amperes-robot/peta/etc/report/Figures/zipTrolley.JPG

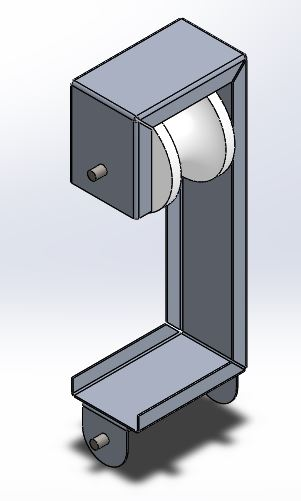
etc/report/Figures/zipTrolley.JPG
