amperes-robot/peta/etc/report/Figures/knockOffTool.JPG

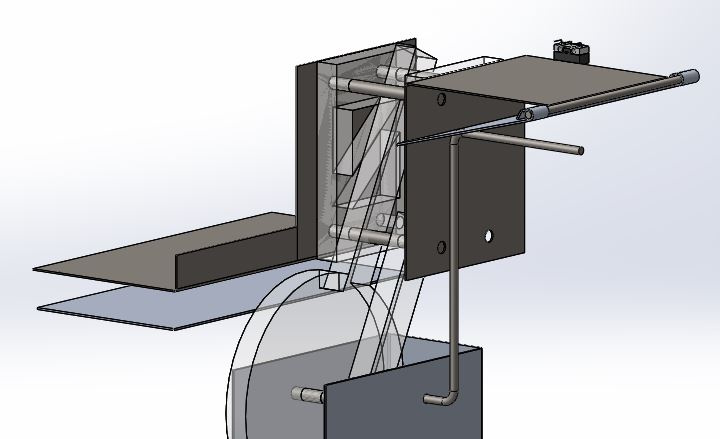
etc/report/Figures/knockOffTool.JPG
