amperes-robot/peta/README.md

ENPH 253 Project Repository

Team PETA
=========

Kevin Zhang

Anne Lim

Scott Fjordbotten

Johnson Liu
