amperes-robot/peta/mech/zipLine/ziplineZipper-Static 1-2.docx

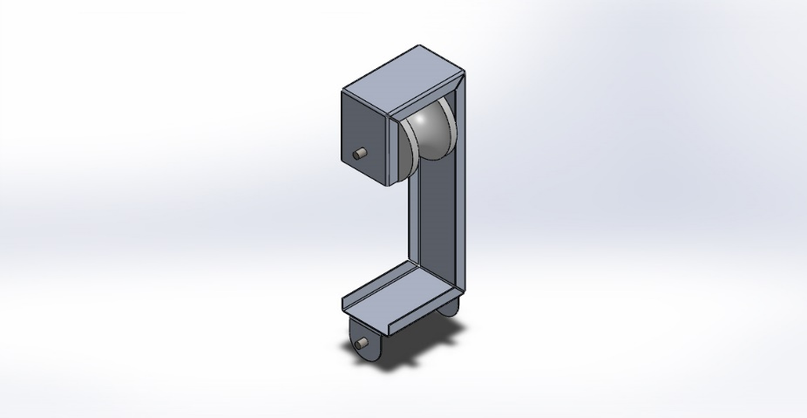
[picture p3: figure]

Simulation of ziplineZipper

Date: June 15, 2015
Designer: Solidworks

Study name: Static 1

Analysis type: Static
Description No Data

# Assumptions

# Model Information

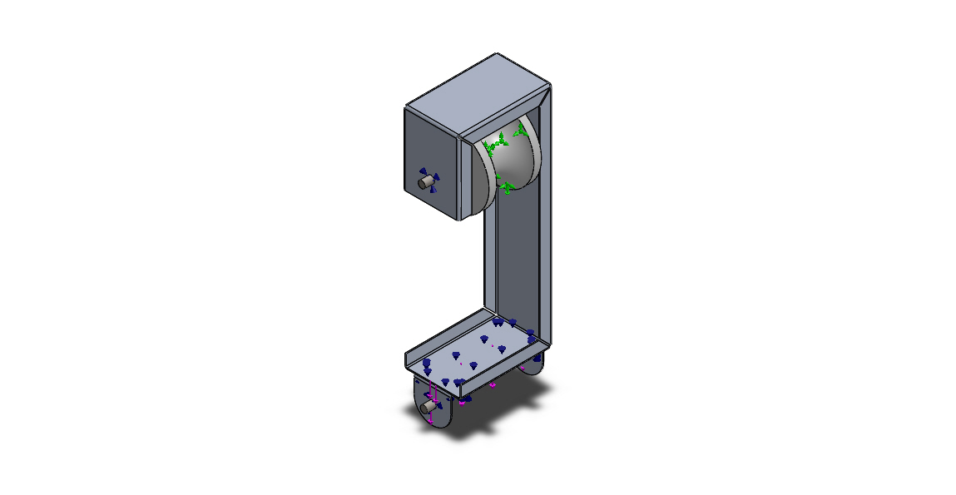
[picture p4: figure]

Model name: ziplineZipper

Current Configuration: Default

Solid Bodies
Document Name and Reference | Treated As | Volumetric Properties | Document Path/Date Modified

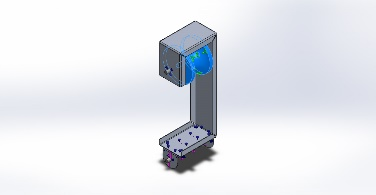
[picture p5: figure]

Cut-Extrude2 | Solid Body | Mass:0.0403131 kg Volume:3.95226e-005 m^3 Density:1020 kg/m^3 Weight:0.395068 N | C:\Users\Scott\Documents\2nd year\ENPH 253\peta\mech\zipLine\ziplineRoller.SLDPRT Jun 13 16:59:09 2015

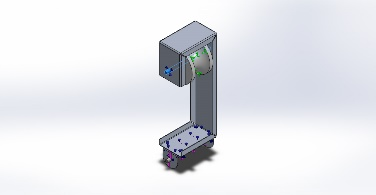
[picture p6: figure]

Boss-Extrude1 | Solid Body | Mass:0.0104596 kg Volume:1.32904e-006 m^3 Density:7870 kg/m^3 Weight:0.102504 N | C:\Users\Scott\Documents\2nd year\ENPH 253\peta\mech\zipLine\ziplineZipperAxel.SLDPRT Jun 13 16:59:10 2015

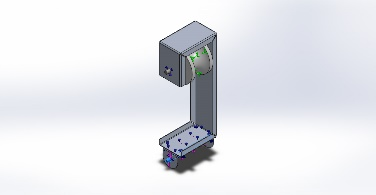
[picture p7: figure]

Boss-Extrude1 | Solid Body | Mass:0.0104596 kg Volume:1.32904e-006 m^3 Density:7870 kg/m^3 Weight:0.102504 N | C:\Users\Scott\Documents\2nd year\ENPH 253\peta\mech\zipLine\ziplineZipperAxel.SLDPRT Jun 13 16:59:10 2015

# Study Properties

Study name | Static 1
Analysis type | Static
Mesh type | Mixed Mesh
Thermal Effect: | On
Thermal option | Include temperature loads
Zero strain temperature | 298 Kelvin
Include fluid pressure effects from SolidWorks Flow Simulation | Off
Solver type | FFEPlus
Inplane Effect: | Off
Soft Spring: | Off
Inertial Relief: | Off
Incompatible bonding options | Automatic
Large displacement | Off
Compute free body forces | On
Friction | Off
Use Adaptive Method: | Off
Result folder | SolidWorks document (C:\Users\Scott\Documents\2nd year\ENPH 253\peta\mech\zipLine)

# Units

Unit system: | SI (MKS)
Length/Displacement | mm
Temperature | Kelvin
Angular velocity | Rad/sec
Pressure/Stress | N/m^2

# Material Properties

Model Reference | Properties | Components

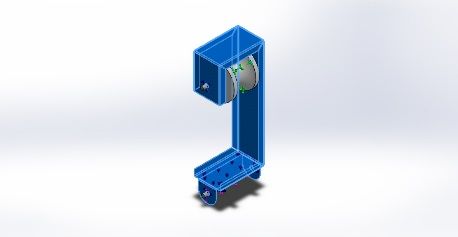
[picture p8: figure]

| Name: 5052-H34 Model type: Linear Elastic Isotropic Default failure criterion: Unknown Yield strength: 2.15e+008 N/m^2 Tensile strength: 2.6e+008 N/m^2 Elastic modulus: 7e+010 N/m^2 Poisson's ratio: 0.33 Mass density: 2680 kg/m^3 Shear modulus: 2.59e+010 N/m^2 Thermal expansion coefficient: 2.4e-005 /Kelvin | SolidBody 1(Cut-Extrude1)(ziplineCBracket-1), SolidBody 1(Cut-Extrude1)(ziplineWinchBracket-1)

Curve Data:N/A

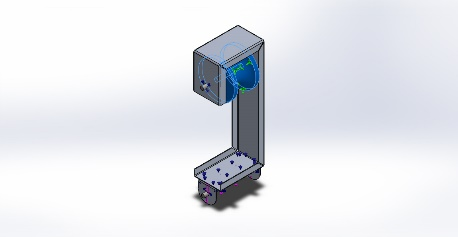
[picture p9: figure]

| Name: ABS Model type: Linear Elastic Isotropic Default failure criterion: Unknown Tensile strength: 3e+007 N/m^2 Elastic modulus: 2e+009 N/m^2 Poisson's ratio: 0.394 Mass density: 1020 kg/m^3 Shear modulus: 3.189e+008 N/m^2 | SolidBody 1(Cut-Extrude2)(ziplineRoller-1)

Curve Data:N/A

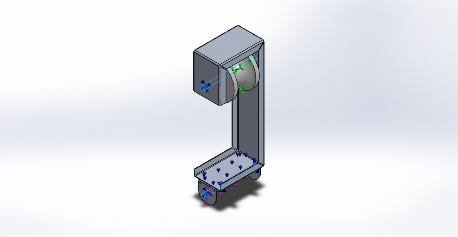
[picture p10: figure]

| Name: AISI 1020 Steel, Cold Rolled Model type: Linear Elastic Isotropic Default failure criterion: Unknown Yield strength: 3.5e+008 N/m^2 Tensile strength: 4.2e+008 N/m^2 Elastic modulus: 2.05e+011 N/m^2 Poisson's ratio: 0.29 Mass density: 7870 kg/m^3 Shear modulus: 8e+010 N/m^2 Thermal expansion coefficient: 1.2e-005 /Kelvin | SolidBody 1(Boss-Extrude1)(ziplineZipperAxel-1), SolidBody 1(Boss-Extrude1)(ziplineZipperAxel-2)

Curve Data:N/A

# Loads and Fixtures

Fixture name | Fixture Image | Fixture Details

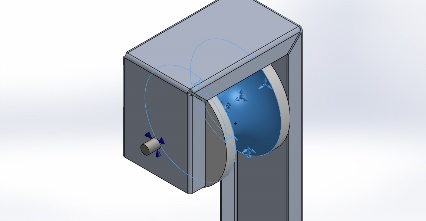
[picture p11: figure]

Fixed-1 | | Entities: 1 face(s) Type: Fixed Geometry

Resultant Forces

Components | X | Y | Z | Resultant
Reaction force(N) | 6.08177e-006 | 44.145 | -7.96234e-006 | 44.145
Reaction Moment(N.m) | 0 | 0 | 0 | 1e-033

Load name | Load Image | Load Details

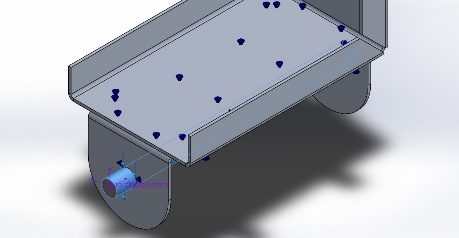
[picture p12: figure]

BearingLoads-1 | | Entities: 1 face(s) Coordinate System: Coordinate System1 Force Values: 0 -44.145 0 N

# Connector Definitions

Connector name | Connector Details | Connector Image

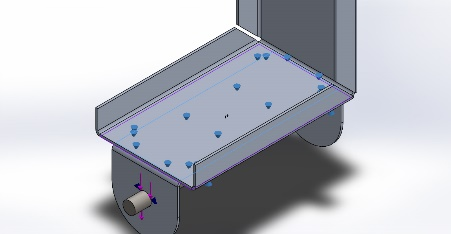
[picture p13: figure]

Rigid Connector-1 | Entities: 2 face(s) Type: Rigid | Rigid Connector-1

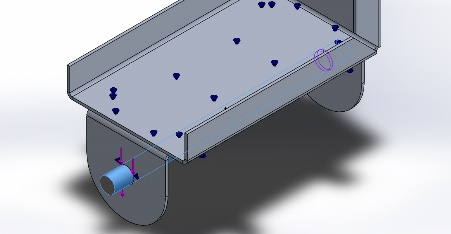
[picture p14: figure]

Rigid Connector-2 | Entities: 2 face(s) Type: Rigid | Rigid Connector-2

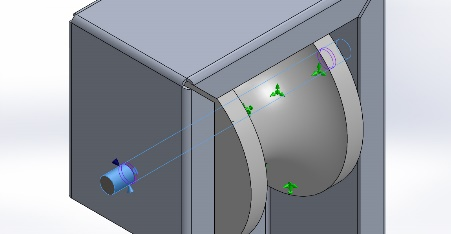
[picture p15: figure]

Rigid Connector-3 | Entities: 3 face(s) Type: Rigid | Rigid Connector-3

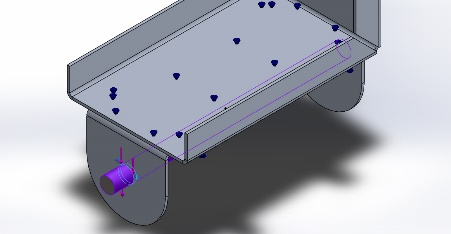
[picture p16: figure]

Rigid Connector-4 | Entities: 2 face(s) Type: Rigid | Rigid Connector-4

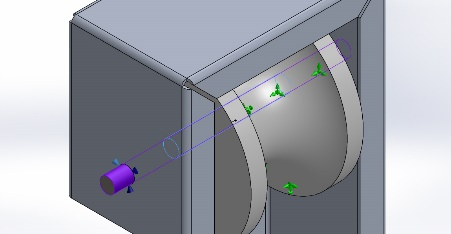
[picture p17: figure]

Rigid Connector-5 | Entities: 2 face(s) Type: Rigid | Rigid Connector-5

# Contact Information

Contact | Contact Image | Contact Properties

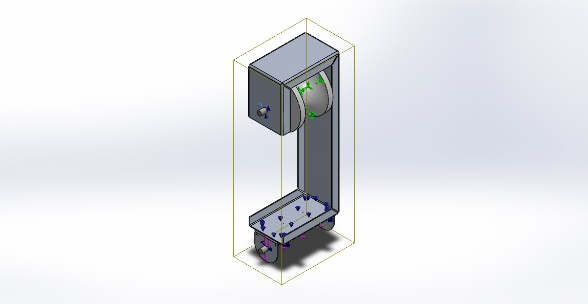
[picture p18: figure]

Global Contact | | Type: Bonded Components: 1 component(s) Options: Compatible mesh

# Mesh Information

Mesh type | Mixed Mesh
Mesher Used: | Standard mesh
Automatic Transition: | Off
Include Mesh Auto Loops: | Off
Jacobian points | 4 Points
Jacobian check for shell | Off
Element Size | 3.69528 mm
Tolerance | 0.184764 mm
Mesh Quality | High
Remesh failed parts with incompatible mesh | Off

## Mesh Information - Details

Total Nodes | 18106
Total Elements | 9996
Time to complete mesh(hh;mm;ss): | 00:00:08
Computer name: | HP-PC

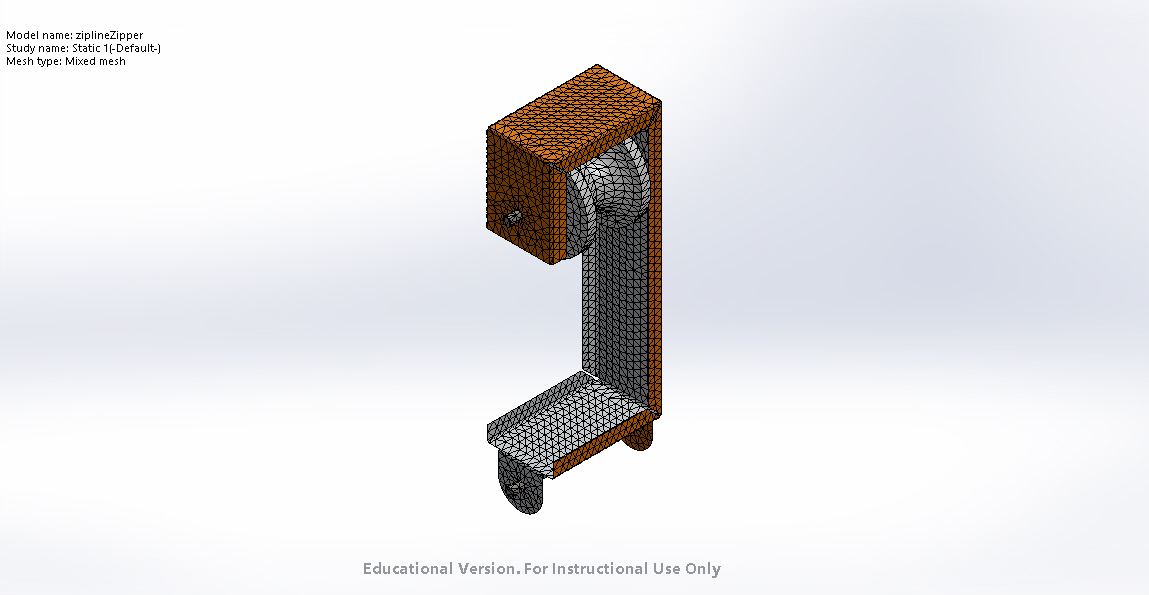
[picture p19: figure]

# Sensor Details

No Data

# Resultant Forces

## Reaction Forces

Selection set | Units | Sum X | Sum Y | Sum Z | Resultant
Entire Model | N | 6.08177e-006 | 44.145 | -7.96234e-006 | 44.145

## Reaction Moments

Selection set | Units | Sum X | Sum Y | Sum Z | Resultant
Entire Model | N.m | 0 | 0 | 0 | 1e-033

# Beams

No Data

# Study Results

Name | Type | Min | Max
Stress1 | VON: von Mises Stress | 0.00107596 N/m^2 Node: 9768 | 1.32393e+007 N/m^2 Node: 11499

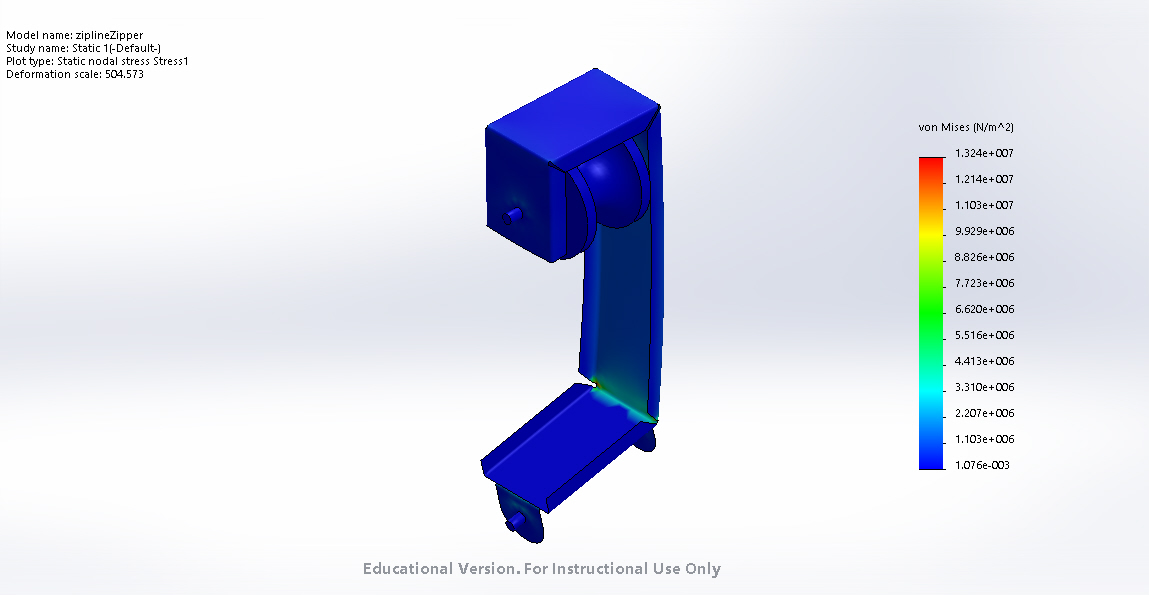
[picture p20: figure]

ziplineZipper-Static 1-Stress-Stress1

Name | Type | Min | Max
Displacement1 | URES: Resultant Displacement | 0 mm Node: 1 | 0.035754 mm Node: 10597

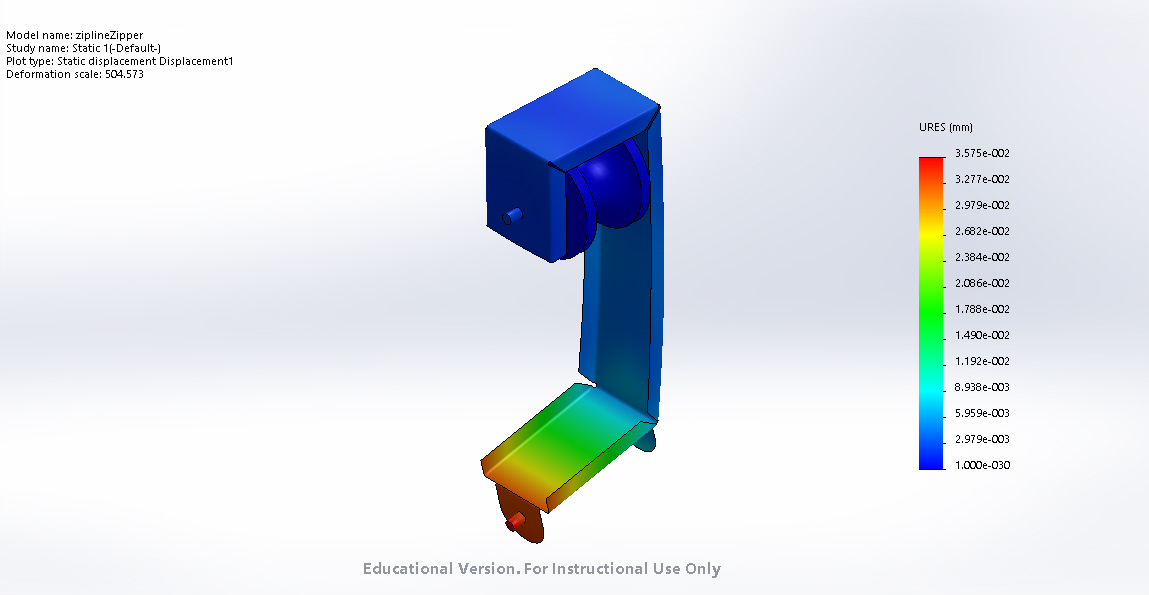
[picture p21: figure]

ziplineZipper-Static 1-Displacement-Displacement1

Name | Type | Min | Max
Strain1 | ESTRN: Equivalent Strain | 3.14989e-014 Element: 6184 | 0.000224662 Element: 1951

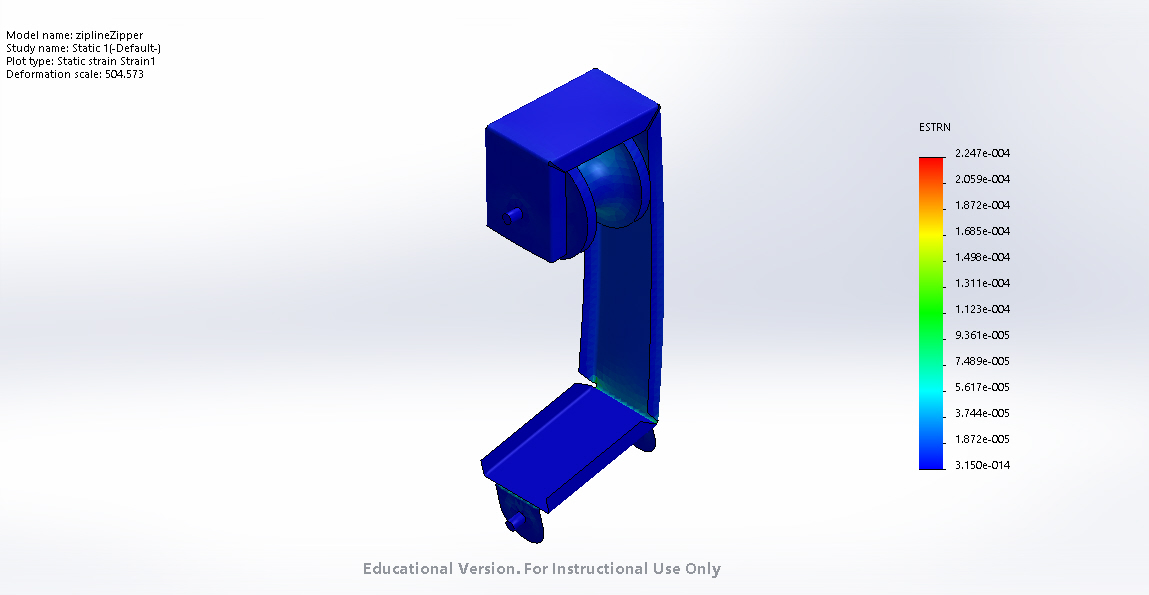
[picture p22: figure]

ziplineZipper-Static 1-Strain-Strain1

Name | Type
Displacement1{1} | Deformed Shape

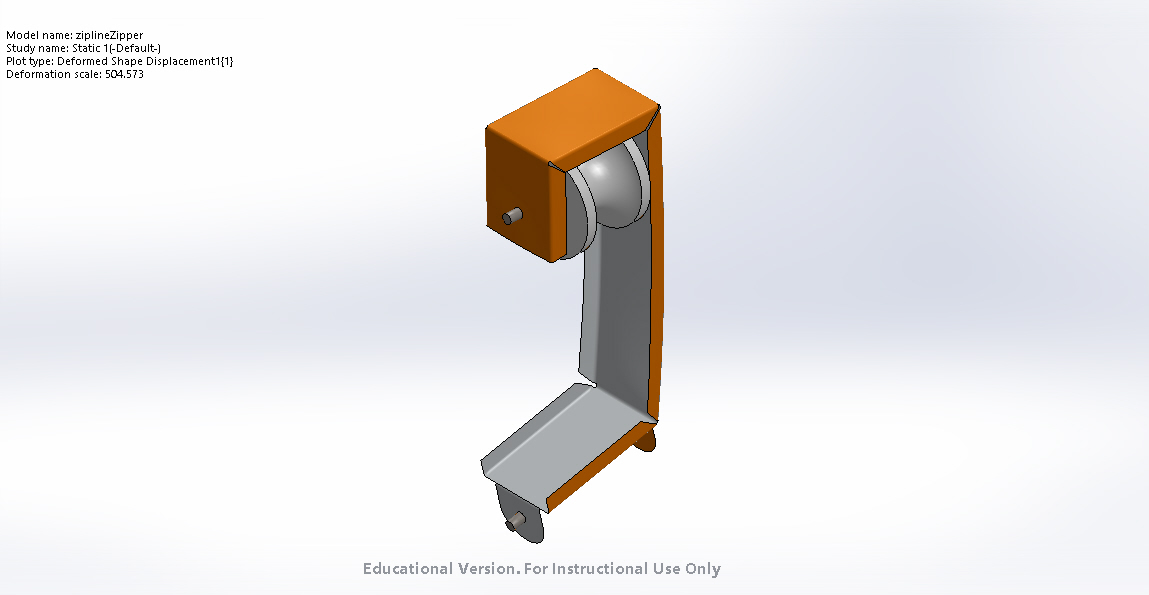
[picture p23: figure]

ziplineZipper-Static 1-Displacement-Displacement1{1}

# Conclusion

Analyzed with SolidWorks Simulation Simulation of ziplineZipper 14

Analyzed with SolidWorks Simulation Simulation of ziplineZipper 1
