amperes-robot/peta/elec/HBridge.png

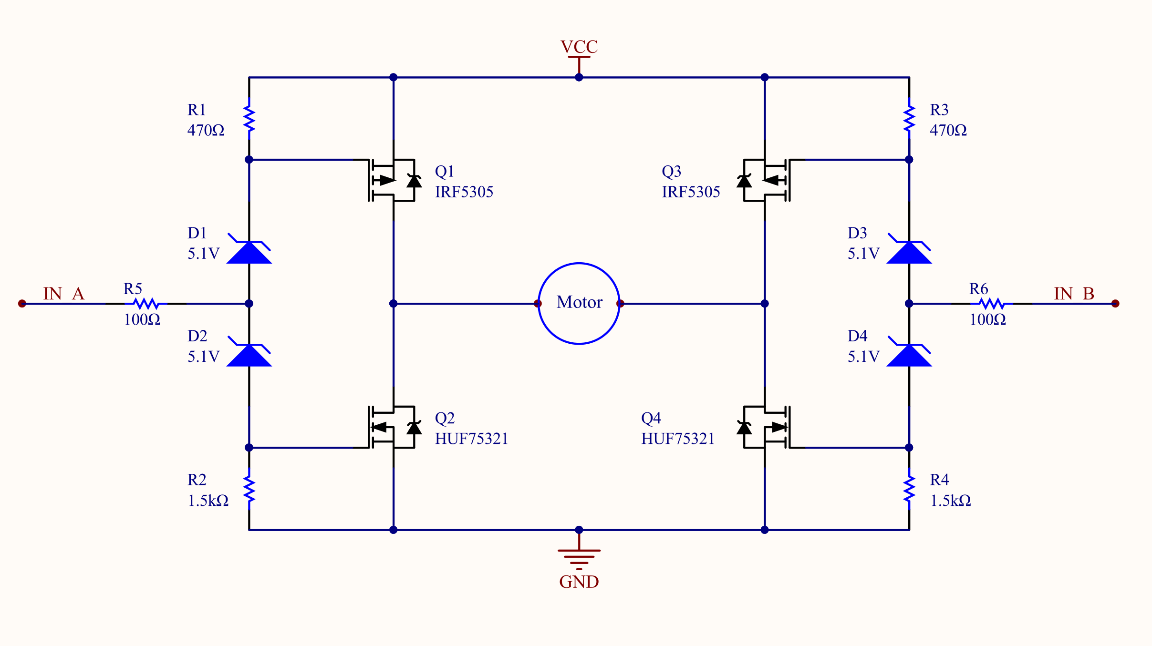
elec/HBridge.png
