amperes-robot/peta/elec/IR_forWebsite.JPG

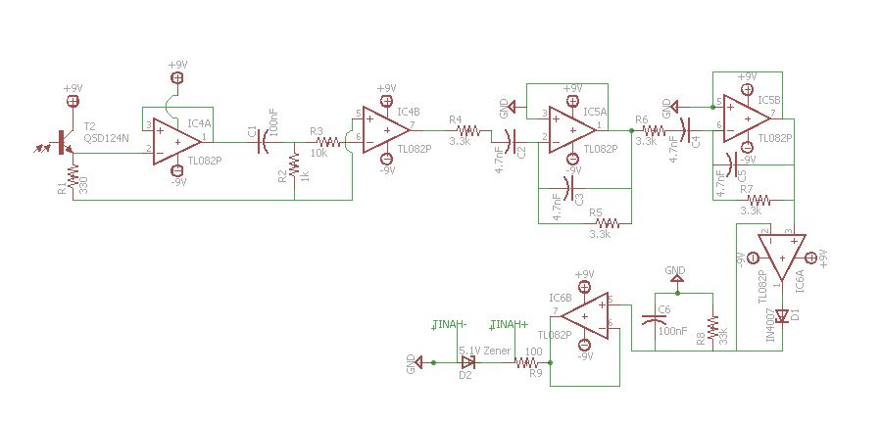
elec/IR_forWebsite.JPG
