amperes-robot/peta/etc/report/Figures/amp.jpg

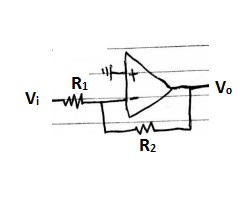
etc/report/Figures/amp.jpg
