amperes-robot/peta/etc/report/Figures/armArms.JPG

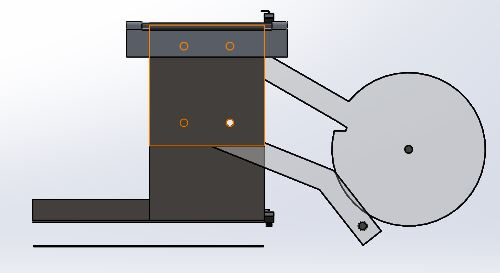
etc/report/Figures/armArms.JPG
