amperes-robot/peta/etc/report/Figures/armBodyFront.JPG

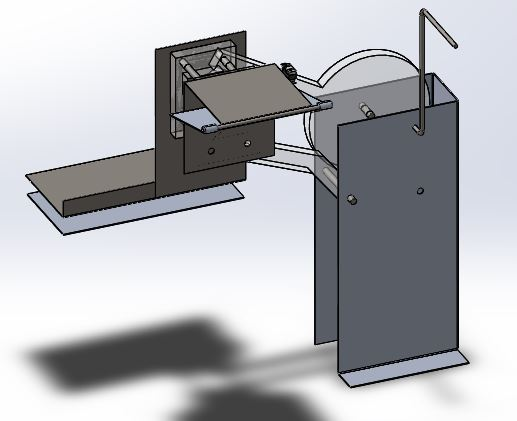
etc/report/Figures/armBodyFront.JPG
