amperes-robot/peta/etc/report/Figures/armBodyRear.JPG

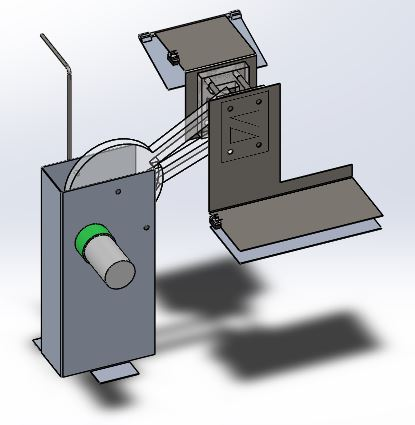
etc/report/Figures/armBodyRear.JPG
