amperes-robot/peta/etc/report/Figures/armEnd.JPG

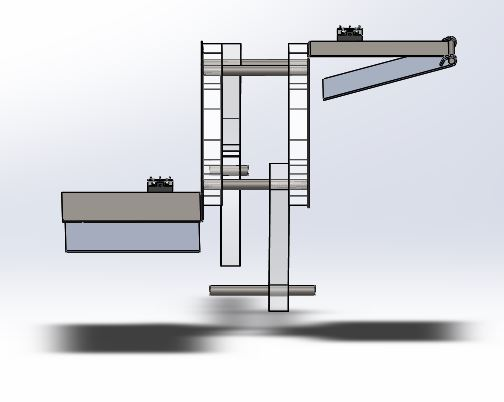
etc/report/Figures/armEnd.JPG
