amperes-robot/peta/etc/report/Figures/bandPass.jpg

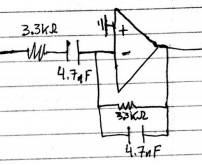
etc/report/Figures/bandPass.jpg
