amperes-robot/peta/etc/report/Figures/Board Storage Space.JPG

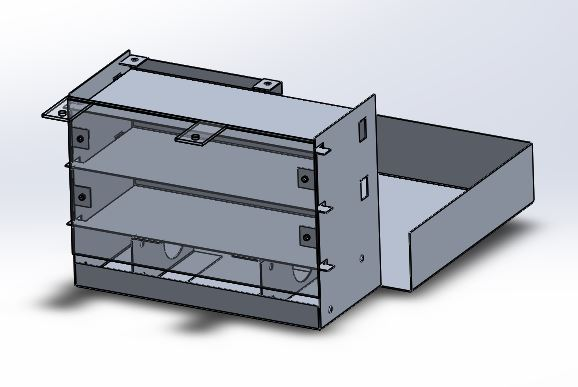
etc/report/Figures/Board Storage Space.JPG
