amperes-robot/peta/etc/report/Figures/chassis back features.jpg

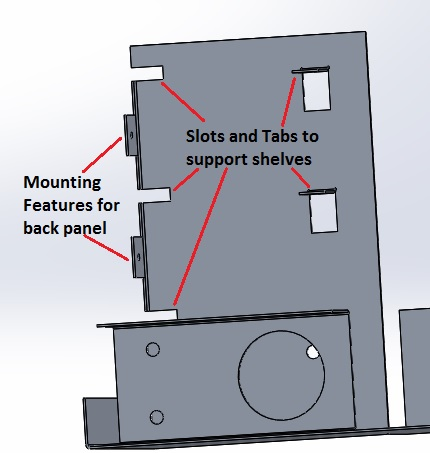
etc/report/Figures/chassis back features.jpg
