amperes-robot/peta/etc/report/Figures/Chassis Body.JPG

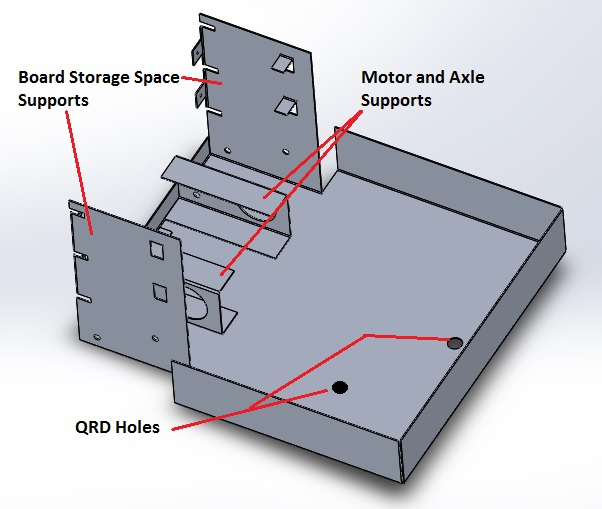
etc/report/Figures/Chassis Body.JPG
