amperes-robot/peta/etc/report/Figures/chassisAssy.JPG

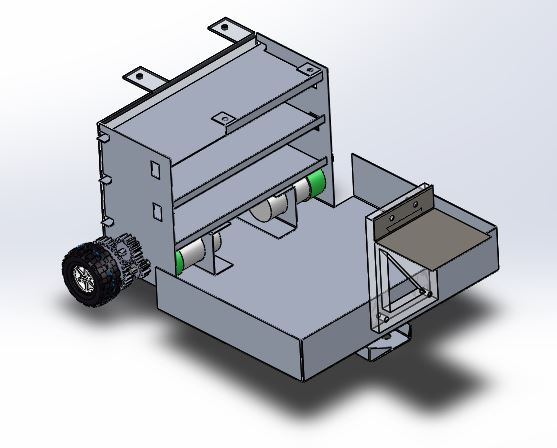
etc/report/Figures/chassisAssy.JPG
