amperes-robot/peta/etc/report/Figures/course.JPG

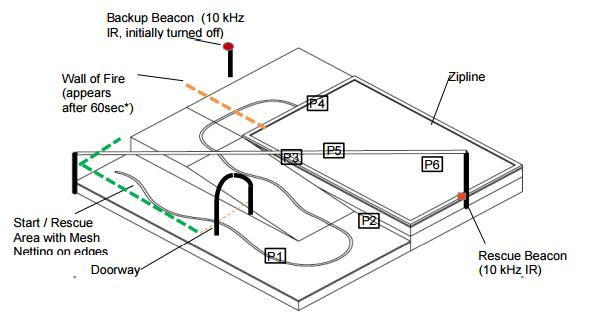
etc/report/Figures/course.JPG
