amperes-robot/peta/etc/report/Figures/dcBlock.jpg

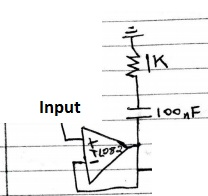
etc/report/Figures/dcBlock.jpg
