amperes-robot/peta/etc/report/Figures/driveGears.JPG

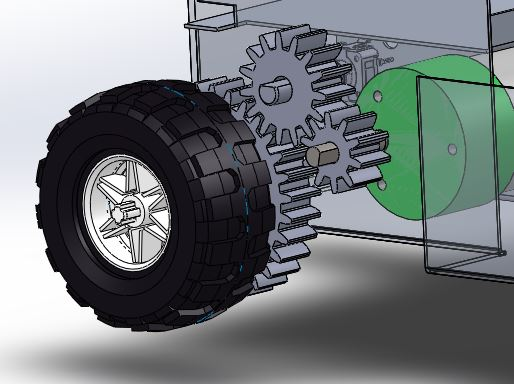
etc/report/Figures/driveGears.JPG
