amperes-robot/peta/etc/report/Figures/frontArm.JPG

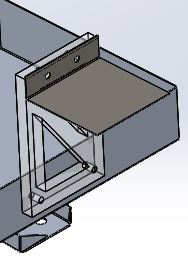
etc/report/Figures/frontArm.JPG
