amperes-robot/peta/etc/report/Figures/frontSled.JPG

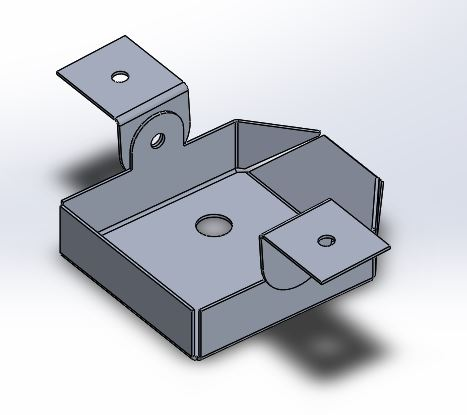
etc/report/Figures/frontSled.JPG
