amperes-robot/peta/etc/report/Figures/peakDetector.jpg

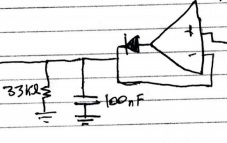
etc/report/Figures/peakDetector.jpg
