amperes-robot/peta/etc/report/Figures/robotAssy.JPG

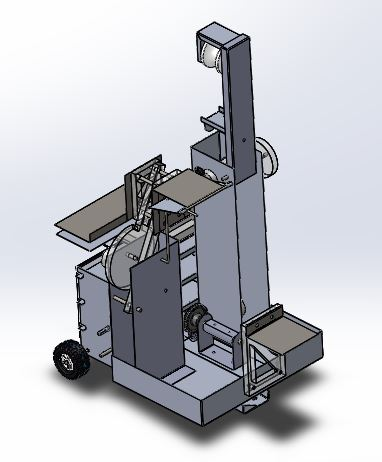
etc/report/Figures/robotAssy.JPG
