amperes-robot/peta/etc/report/Figures/Schematic_B_QRD.PNG

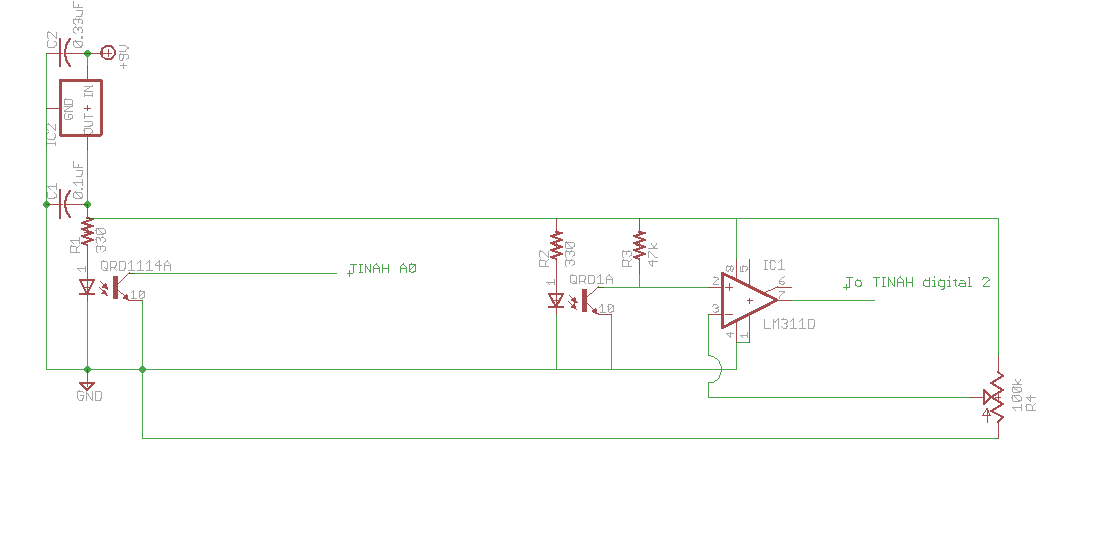
etc/report/Figures/Schematic_B_QRD.PNG
