amperes-robot/peta/etc/report/Figures/Schematic_C-IR.PNG

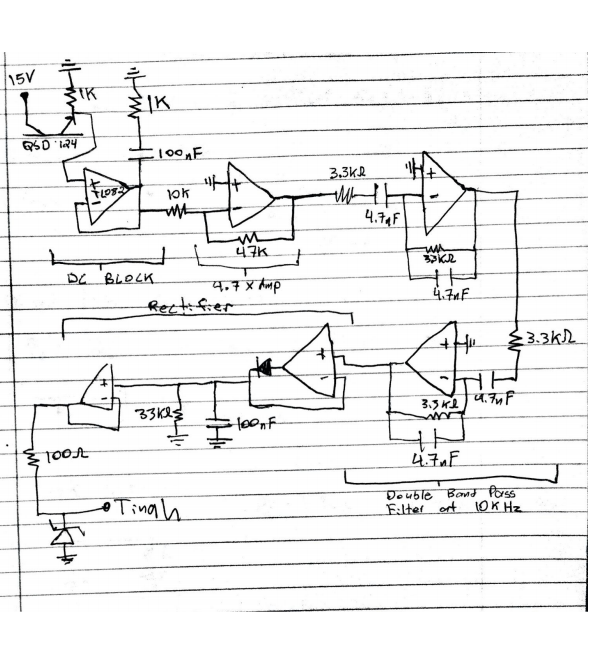
etc/report/Figures/Schematic_C-IR.PNG
