amperes-robot/peta/etc/report/Figures/Schematic_D-winch.PNG

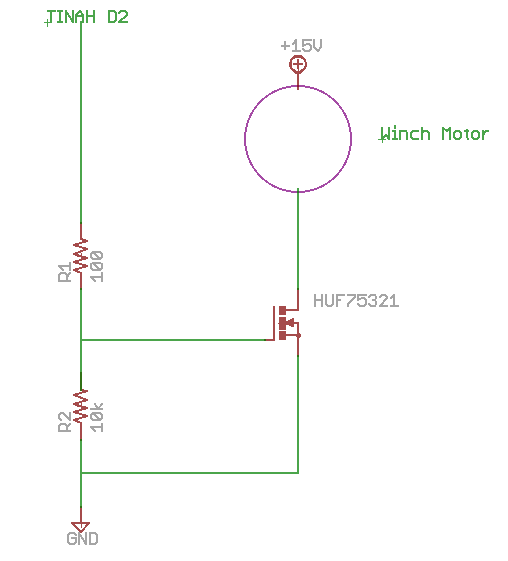
etc/report/Figures/Schematic_D-winch.PNG
