amperes-robot/peta/etc/report/Figures/Schematic_E-petpickup.PNG

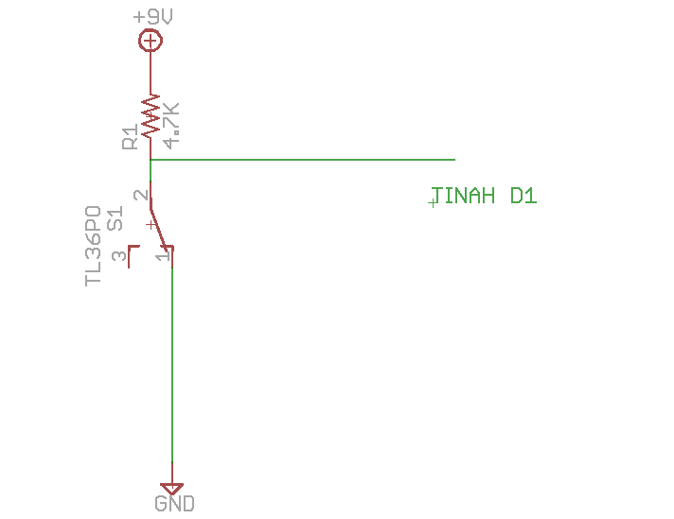
etc/report/Figures/Schematic_E-petpickup.PNG
