amperes-robot/peta/etc/report/Figures/SchematicA_HBridge.PNG

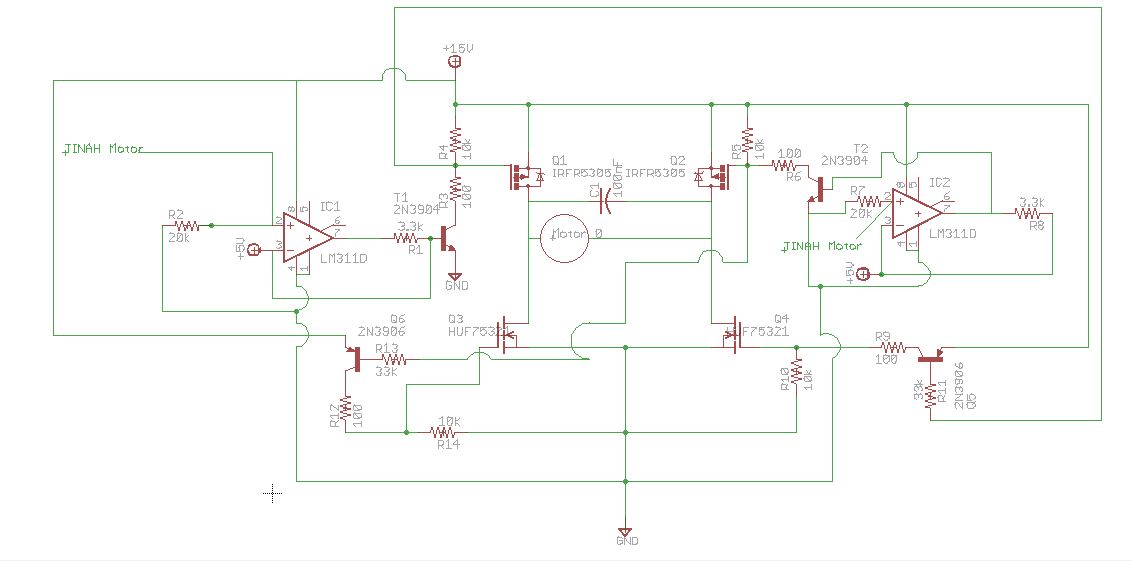
etc/report/Figures/SchematicA_HBridge.PNG
