amperes-robot/peta/etc/report/Figures/Software Modes.JPG

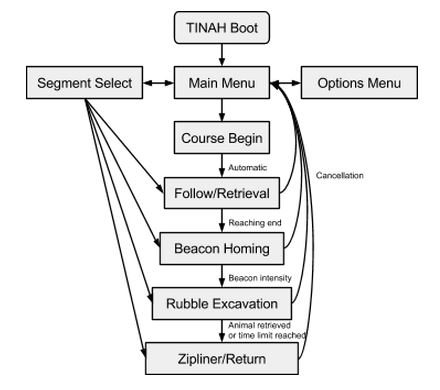
etc/report/Figures/Software Modes.JPG
