amperes-robot/peta/etc/report/Figures/Software State Diag.png

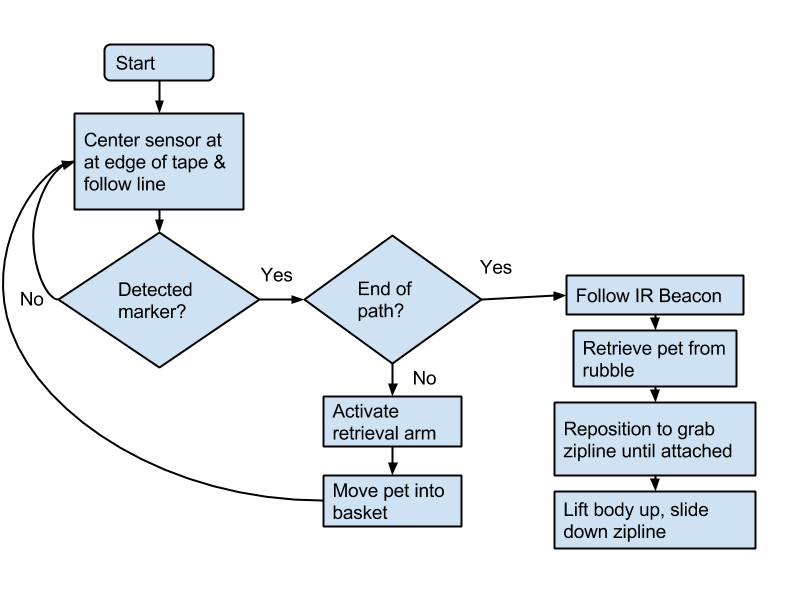
etc/report/Figures/Software State Diag.png
