amperes-robot/peta/etc/report/Figures/winch.JPG

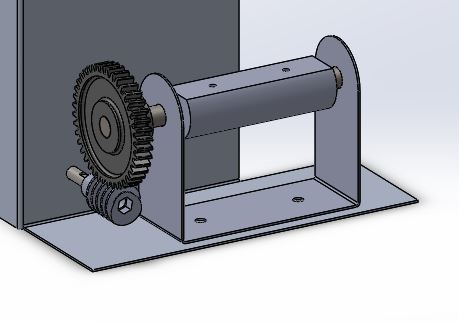
etc/report/Figures/winch.JPG
