amperes-robot/peta/etc/report/Figures/wireRouting.jpg

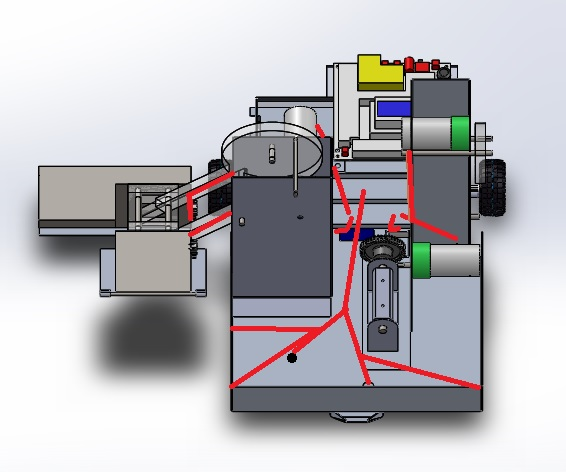
etc/report/Figures/wireRouting.jpg
