amperes-robot/peta/etc/report/Figures/ziplineModule.JPG

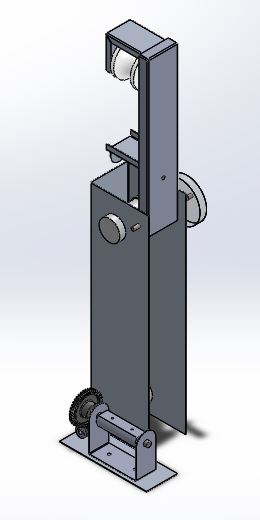
etc/report/Figures/ziplineModule.JPG
