amperes-robot/peta/etc/report/Figures/ziplineZipperFEA.JPG

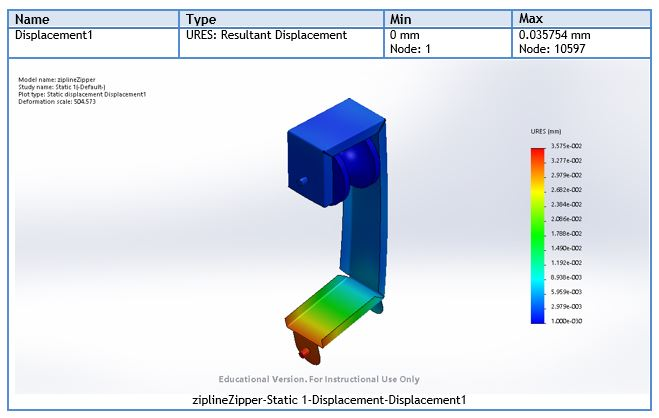
etc/report/Figures/ziplineZipperFEA.JPG
