amperes-robot/peta/etc/Solidworks Render Best Quality.JPG

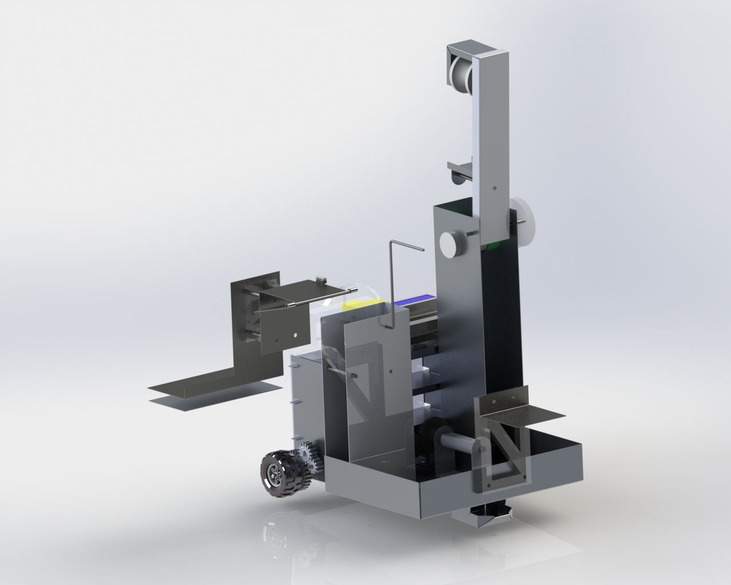
etc/Solidworks Render Best Quality.JPG
