amperes-robot/peta/mech/boxArm/boxArm.SLDASM

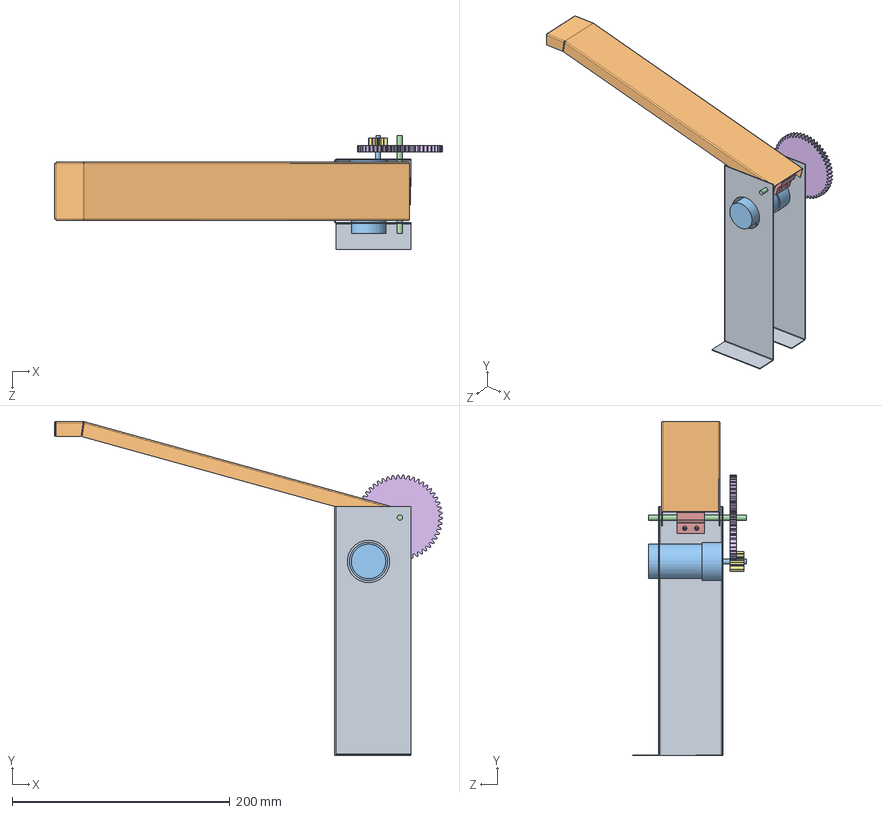
[picture p76: CAD file, 2015-07-29]
mech/boxArm/boxArm.SLDASM
356.2 x 307.0 x 104.9 mm
armSupport
boxArm
Motor Barber Coleman geared
ziplineAxel
printedShaftFitting
50toothGearWithOffset
MotorGearSolidworks
