amperes-robot/peta/mech/chassis/chassisAssy.SLDASM

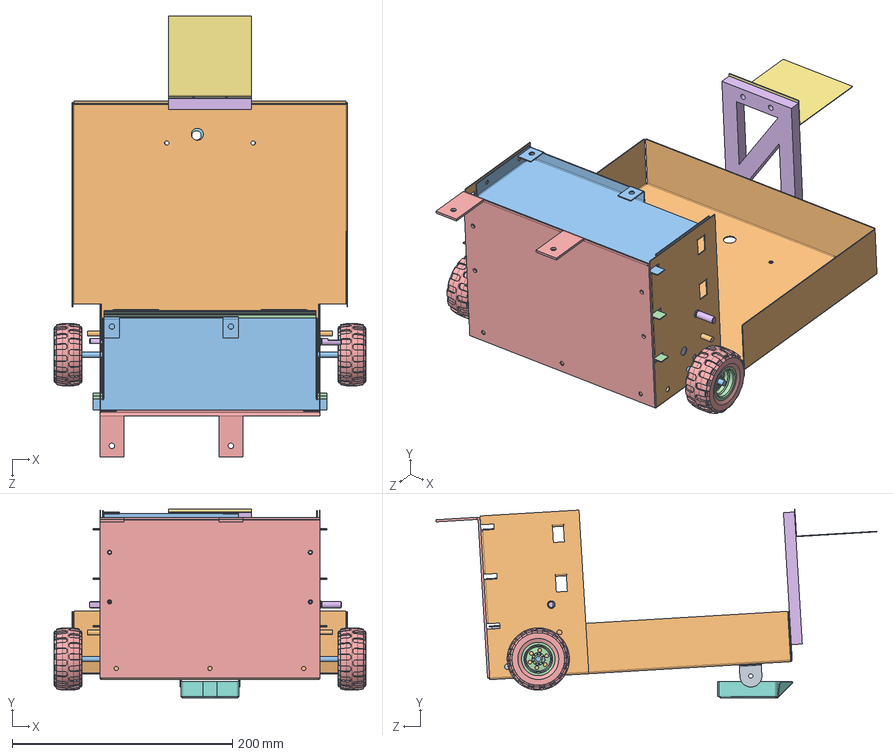
[picture p77: CAD file, 2015-07-23]
mech/chassis/chassisAssy.SLDASM
283.1 x 171.2 x 400.0 mm
sledBracket x 2
ChassisPlate
boardTrayTopTINAH
boardTray x 2
frontarm
LBracket
SledV2
Base x 2
Motor Barber Coleman geared x 2
steelAxle x 2
hub x 2
tire x 2
pec11r-4x25f-sxxxx x 2
axleSupport x 2
