amperes-robot/peta/mech/ext/meccano gear/worm and gear assembly.SLDASM

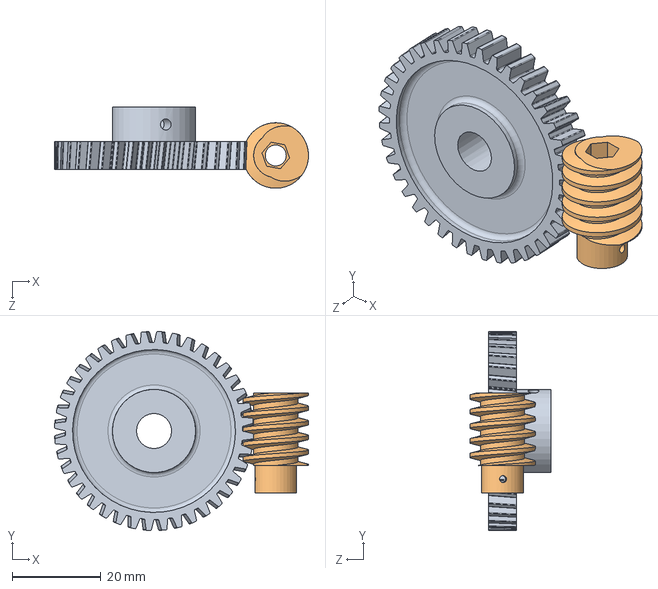
[picture p78: CAD file, 2015-07-09]
mech/ext/meccano gear/worm and gear assembly.SLDASM
57.4 x 45.0 x 18.4 mm
helical gear 40 teeth
worm for helical gear
