amperes-robot/peta/mech/ext/QRD/QRD1114.SLDASM

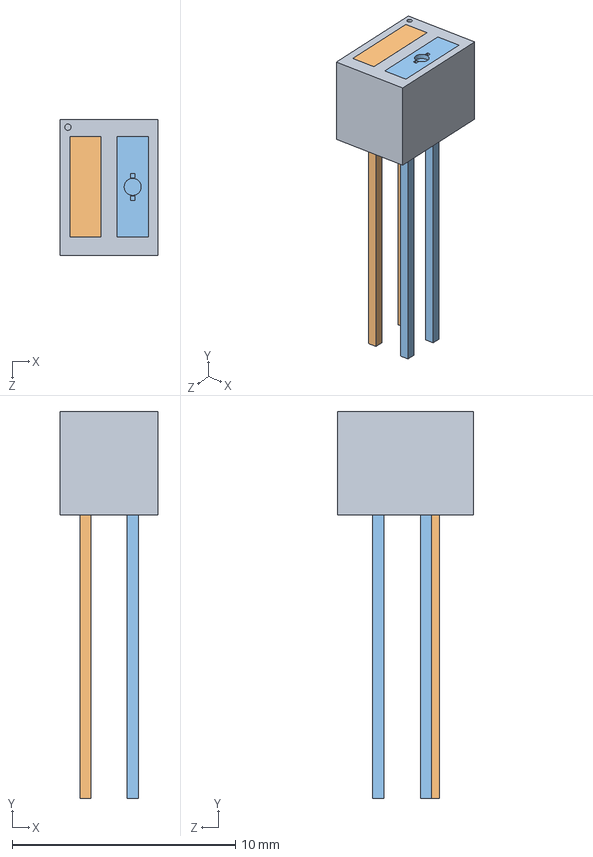
[picture p79: CAD file, 2015-07-23]
mech/ext/QRD/QRD1114.SLDASM
4.39 x 17.4 x 6.10 mm
QRD Chasis
receptor qrd
emisorqrd
