amperes-robot/peta/mech/ext/wheel.SLDASM

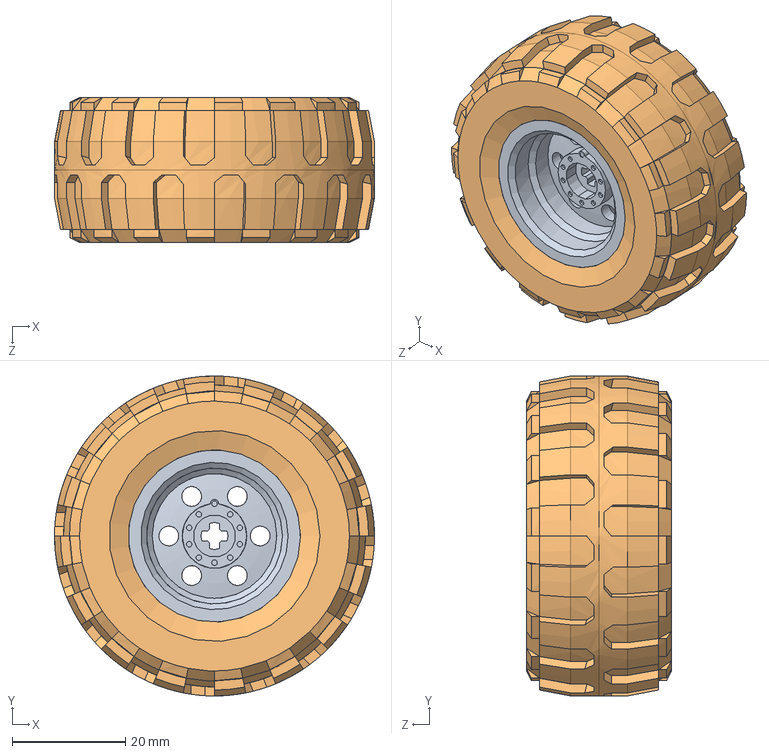
[picture p80: CAD file, 2015-07-23]
mech/ext/wheel.SLDASM
56.5 x 56.5 x 25.6 mm
hub
tire
