amperes-robot/peta/mech/GearBox/GearBoxAssy.SLDASM

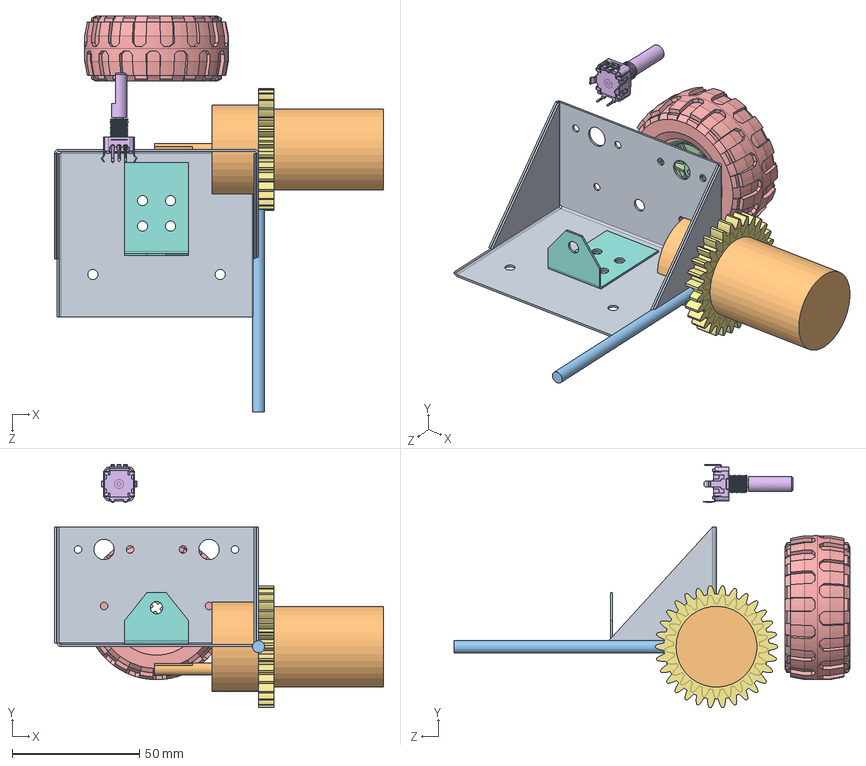
[picture p81: CAD file, 2015-07-23]
mech/GearBox/GearBoxAssy.SLDASM
129.1 x 95.5 x 155.4 mm
Base
Motor Barber Coleman geared
steelAxle
hub
tire
pec11r-4x25f-sxxxx
spur gear_am x 3
axleSupport
