amperes-robot/peta/mech/petArm/armAssy.SLDASM

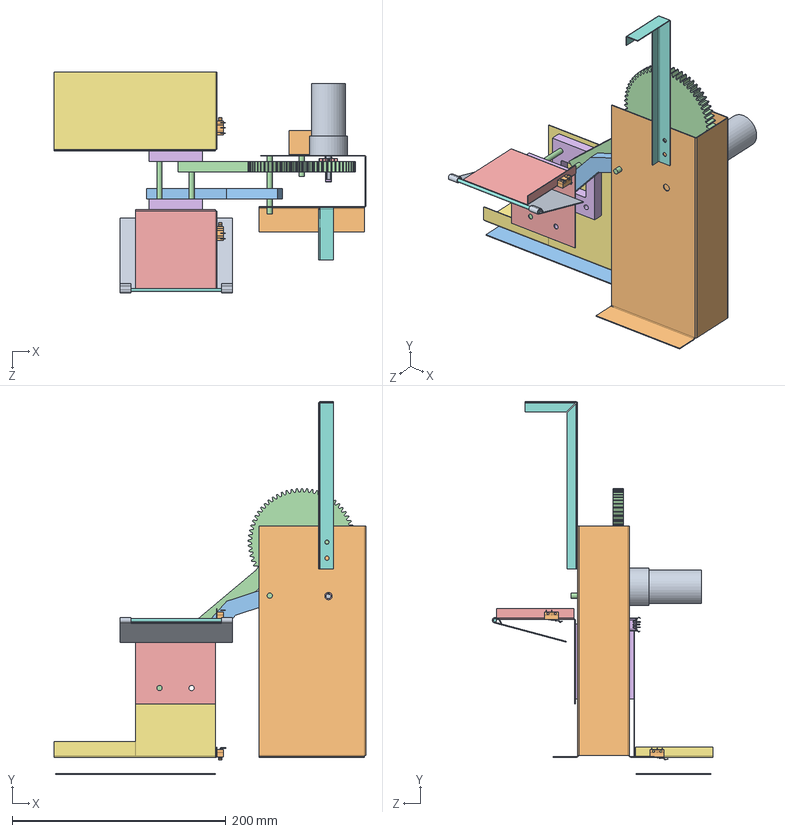
[picture p82: CAD file, 2015-07-23]
mech/petArm/armAssy.SLDASM
291.8 x 348.9 x 206.3 mm
Motor Barber Coleman geared
armBase
ArmLongSection
armRod x 5
LBracket
armBracket x 2
LBracketBack
pickUpArmAxel
pickUpArmSensorPlate
Microswitch_1A_125vAC(seul) x 2
boxPetSensePlate
GearArmV2
MotorGearSolidworks
pec11r-4x25f-sxxxx
spur gear_am
knockOffToolSheetMetal
