amperes-robot/peta/mech/QRDeye.SLDASM

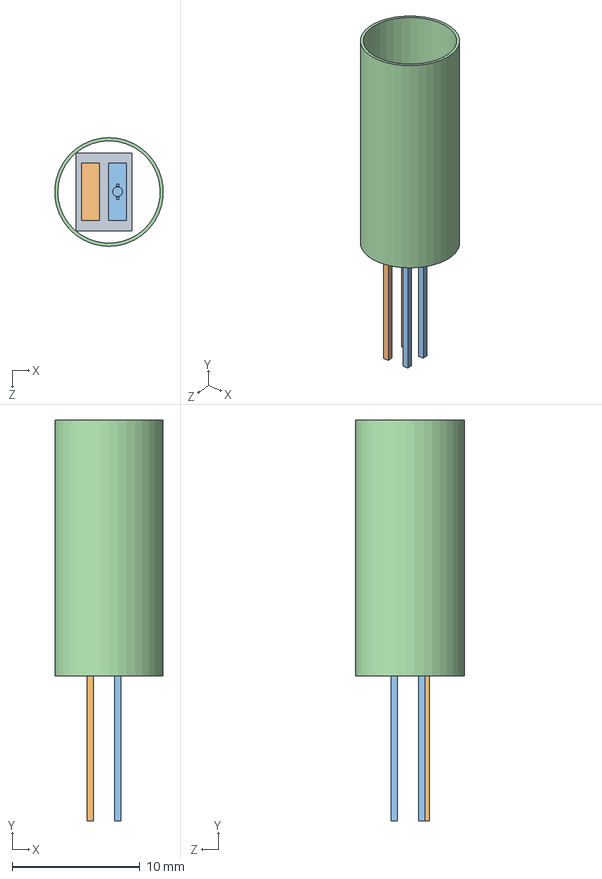
[picture p83: CAD file, 2015-07-23]
mech/QRDeye.SLDASM
8.47 x 31.4 x 8.50 mm
QRD Chasis
receptor qrd
emisorqrd
QRDsleeve
