amperes-robot/peta/mech/RobotAssy.SLDASM

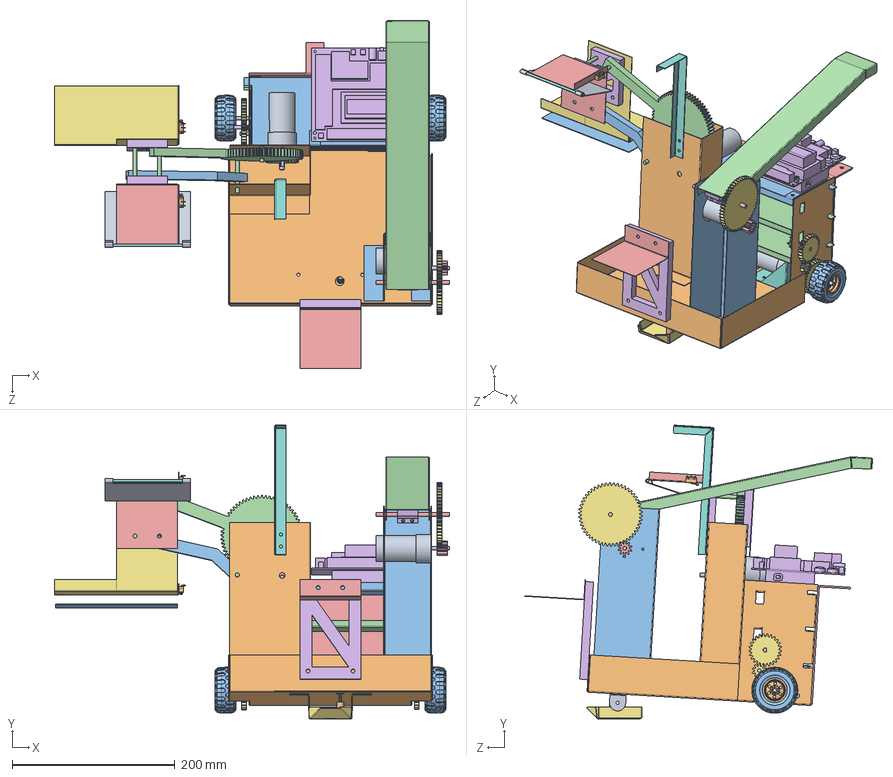
[picture p84: CAD file, 2015-07-23]
mech/RobotAssy.SLDASM
484.8 x 360.7 x 427.2 mm
Motor Barber Coleman geared x 4
armBase
ArmLongSection
armRod x 5
LBracket x 2
armBracket x 2
LBracketBack
pickUpArmAxel
pickUpArmSensorPlate
Microswitch_1A_125vAC(seul) x 2
boxPetSensePlate
GearArmV2
MotorGearSolidworks x 2
pec11r-4x25f-sxxxx x 3
spur gear_am x 7
knockOffToolSheetMetal
sledBracket x 2
ChassisPlate
boardTrayTopTINAH
boardTray x 2
frontarm
SledV2
Base x 2
steelAxle x 2
hub x 2
tire x 2
axleSupport x 2
LiPoBattery
Tinah Board representation
QRD Chasis
receptor qrd
emisorqrd
QRDsleeve
armSupport
boxArm
ziplineAxel
printedShaftFitting
50toothGearWithOffset
