amperes-robot/peta/mech/zipLine/winchAssy.SLDASM

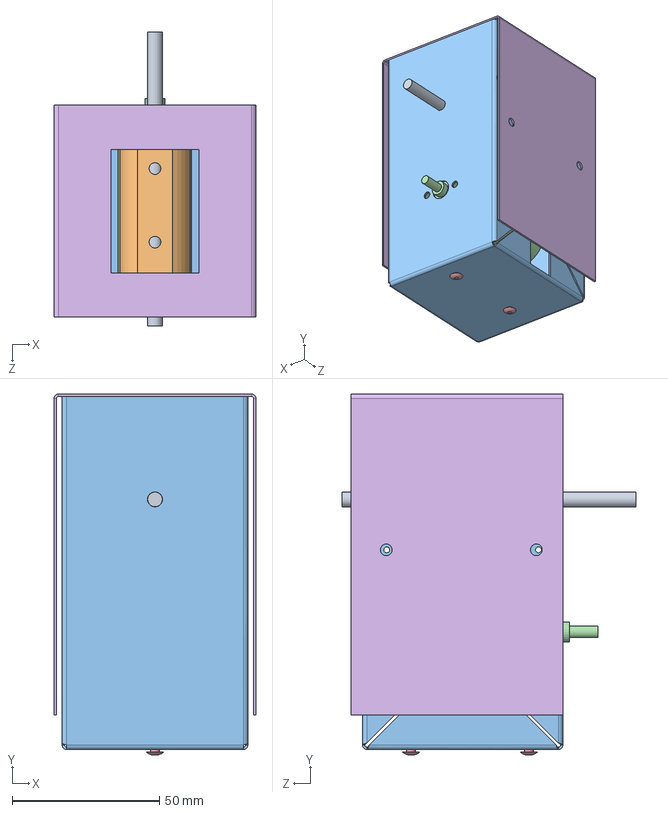
[picture p85: CAD file, 2015-07-29]
mech/zipLine/winchAssy.SLDASM
68.6 x 122.7 x 100.0 mm
winchAxel
winchReel
winchBody
winchGearedMotor
pop rivet x 2
winchCover
