amperes-robot/peta/mech/ext/meccano gear/ASM Meccano Gear 65mm.SLDASM

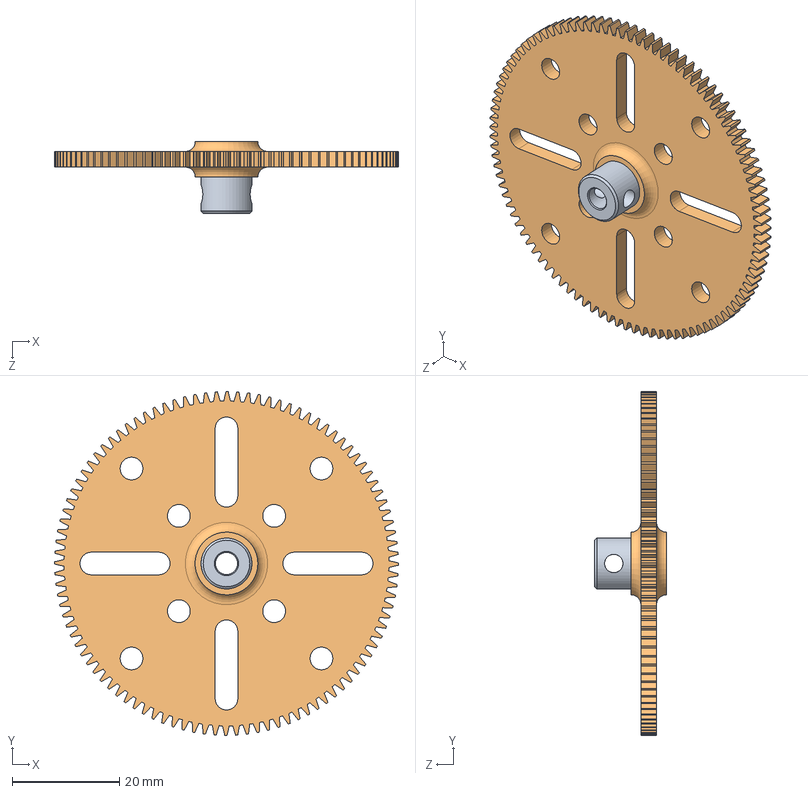
[picture p86: CAD file, 2015-06-16]
mech/ext/meccano gear/ASM Meccano Gear 65mm.SLDASM
64.3 x 64.3 x 13.4 mm
Meccano Gear Axle
Meccano Gear 65mm
