amperes-robot/peta/mech/zipLine/ziplineZipper.SLDASM

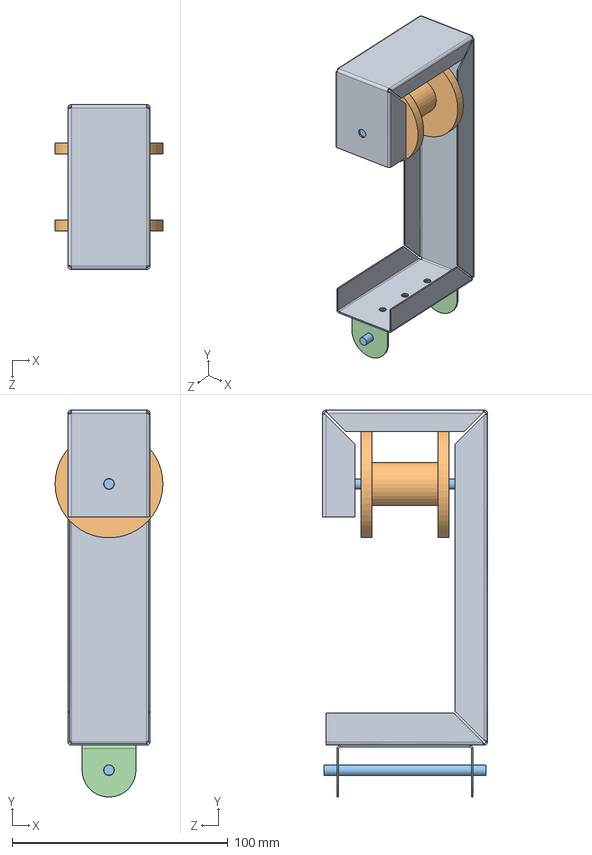
[picture p87: CAD file, 2015-07-29]
mech/zipLine/ziplineZipper.SLDASM
50.0 x 179.5 x 76.5 mm
ziplineCBracket
ziplineRoller
ziplineZipperAxel x 2
ziplineWinchBracket
