amperes-robot/peta/mech/zipLine/ziplineAssy.SLDASM

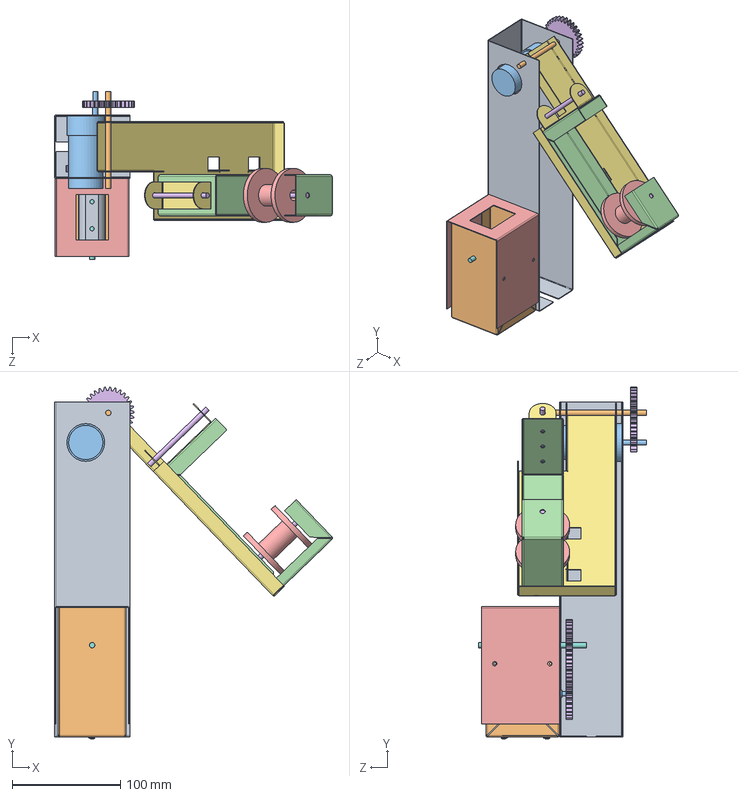
[picture p88: CAD file, 2015-07-29]
mech/zipLine/ziplineAssy.SLDASM
257.7 x 325.8 x 155.7 mm
ZiplineSupport
ziplineAxel
Motor Barber Coleman geared
ziplineCBracket
ziplineRoller
ziplineZipperAxel x 2
ziplineWinchBracket
winchAxel
winchReel
winchBody
winchGearedMotor
pop rivet x 2
winchCover
spur gear_am x 4
ziplineArmGuideLShape
