amperes-robot/peta/mech/chassis/sledAssy.SLDASM

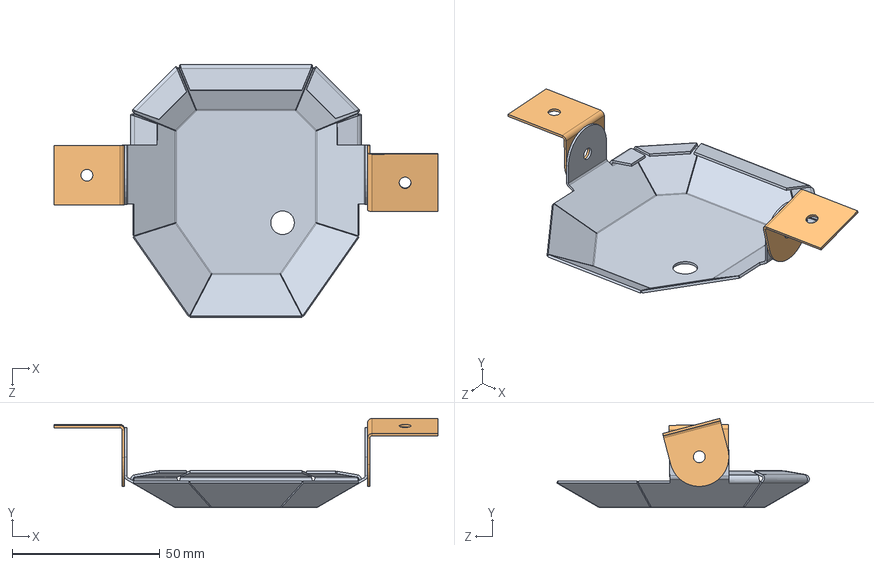
[picture p89: CAD file, 2015-06-16]
mech/chassis/sledAssy.SLDASM
129.9 x 30.2 x 85.5 mm
Sled
sledBracket x 2
