amperes-robot/peta/mech/DXFs/50toothGearWithOffset.DXF

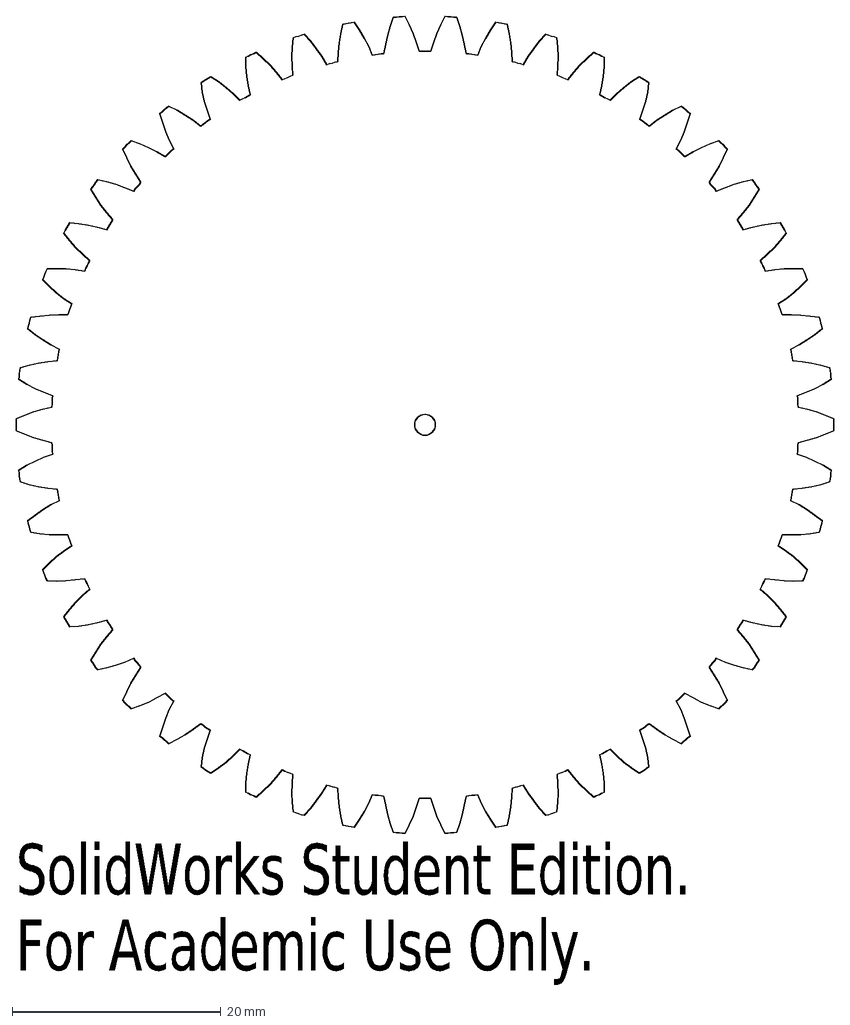
[picture p90: CAD file, 2015-07-23]
mech/DXFs/50toothGearWithOffset.DXF
SolidWorks Student Edition.
For Academic Use Only.
