amperes-robot/peta/mech/DXFs/arm/Flat pattern - knockOffToolSheetMetal.DXF

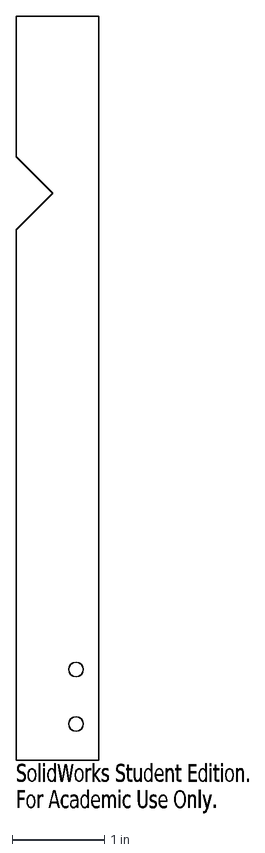
[picture p91: CAD file, 2015-07-11]
mech/DXFs/arm/Flat pattern - knockOffToolSheetMetal.DXF
SolidWorks Student Edition.
For Academic Use Only.
