amperes-robot/peta/mech/DXFs/boxArm/Flat pattern - boxArm.DXF

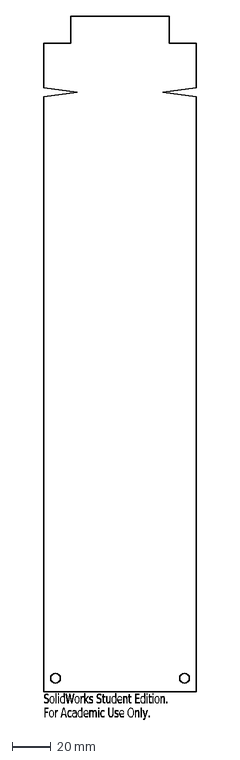
[picture p92: CAD file, 2015-07-23]
mech/DXFs/boxArm/Flat pattern - boxArm.DXF
SolidWorks Student Edition.
For Academic Use Only.
