amperes-robot/peta/mech/DXFs/chassis/Flat pattern - boardTray.DXF

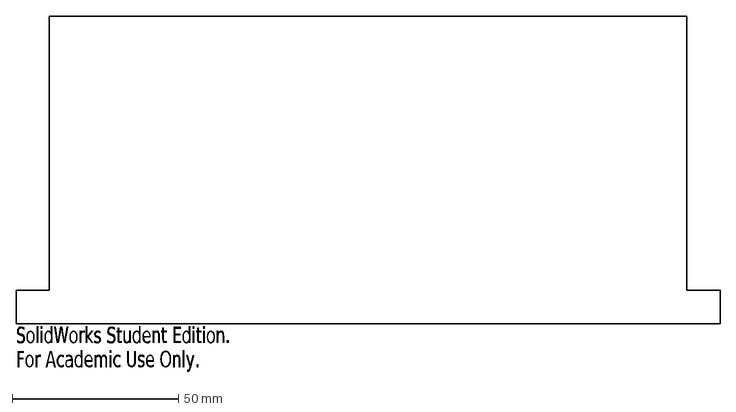
[picture p93: CAD file, 2015-06-25]
mech/DXFs/chassis/Flat pattern - boardTray.DXF
SolidWorks Student Edition.
For Academic Use Only.
