amperes-robot/peta/mech/DXFs/Zipline/Flat pattern - ziplineArmGuideLShape.DXF

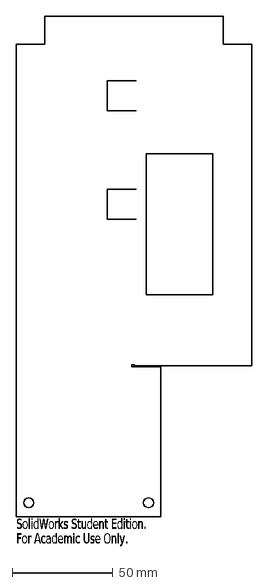
[picture p94: CAD file, 2015-07-17]
mech/DXFs/Zipline/Flat pattern - ziplineArmGuideLShape.DXF
SolidWorks Student Edition.
For Academic Use Only.
