amperes-robot/peta/mech/Gears/MotorGearSolidworks.SLDPRT

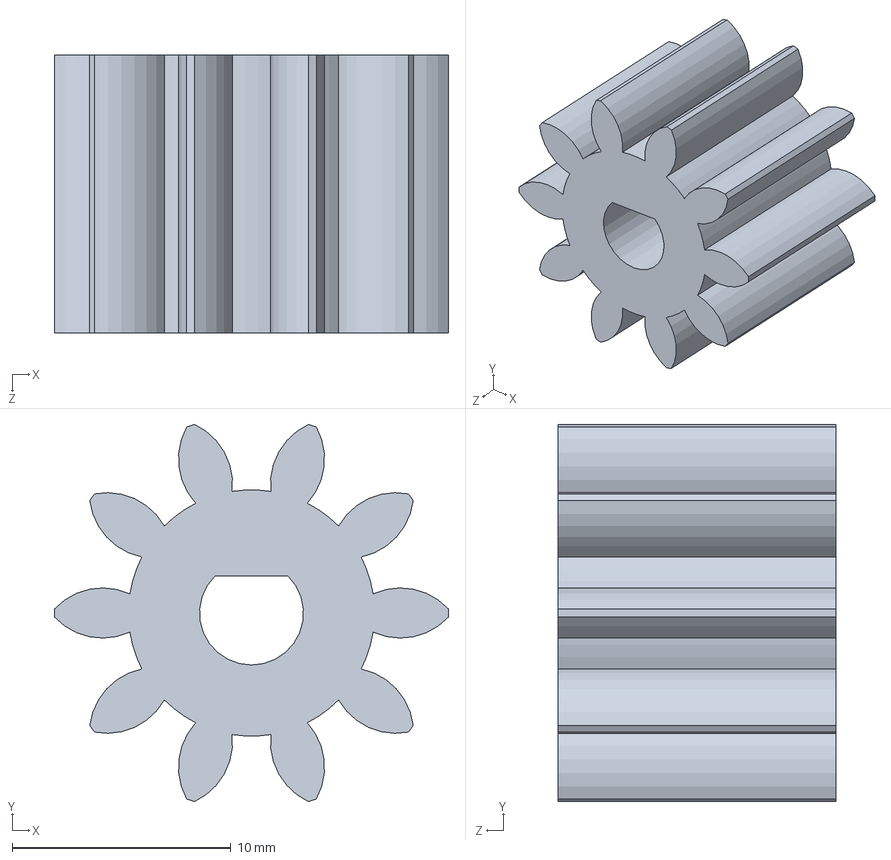
[picture p95: CAD file, 2015-07-23]
mech/Gears/MotorGearSolidworks.SLDPRT
18.0 x 17.2 x 12.7 mm
