amperes-robot/peta/mech/zipLine/ziplineArmGuideLShape.SLDPRT

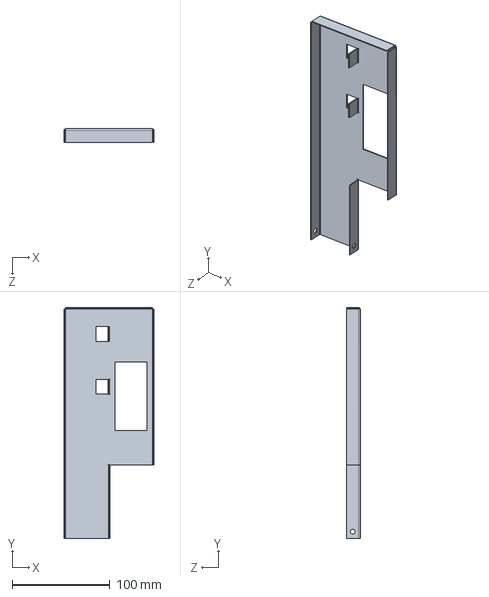
[picture p96: CAD file, 2015-07-29]
mech/zipLine/ziplineArmGuideLShape.SLDPRT
91.6 x 235.8 x 13.8 mm
