amperes-robot/peta/mech/boxArm/50toothGearWithOffset.SLDPRT

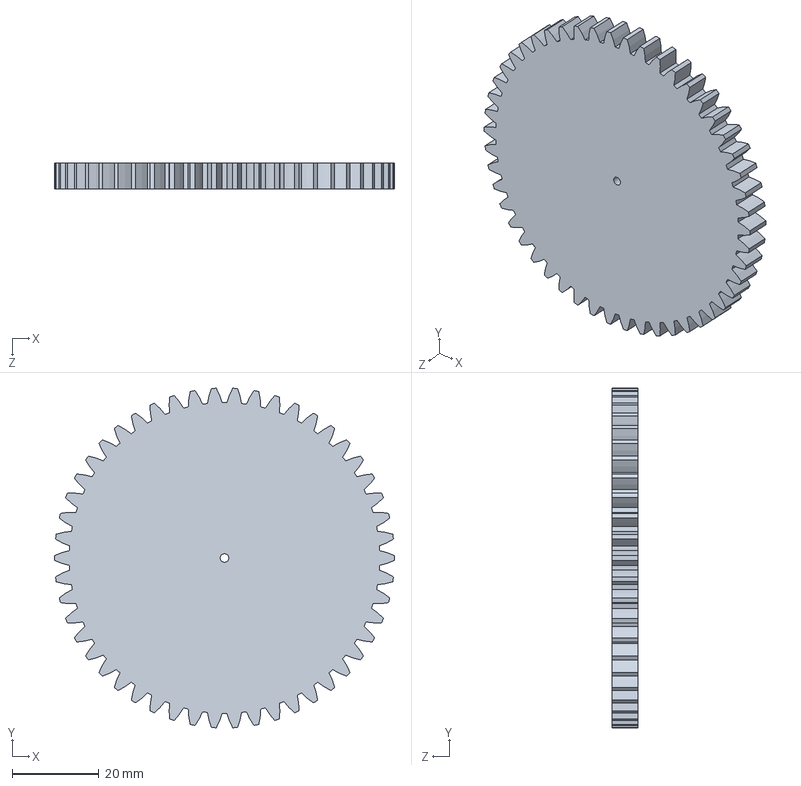
[picture p97: CAD file, 2015-07-23]
mech/boxArm/50toothGearWithOffset.SLDPRT
78.2 x 78.2 x 6.00 mm
