amperes-robot/peta/mech/chassis/AxelMotorBracket.SLDPRT

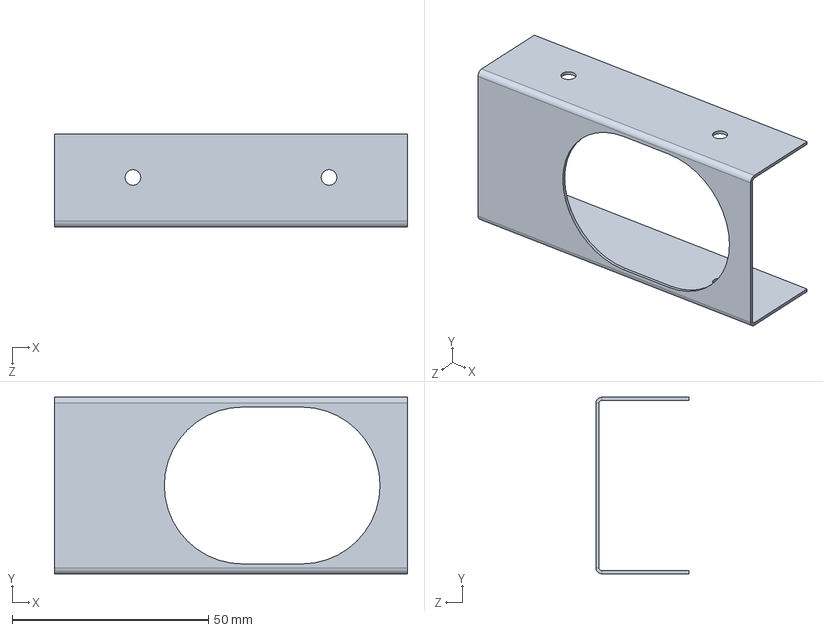
[picture p98: CAD file, 2015-07-22]
mech/chassis/AxelMotorBracket.SLDPRT
90.0 x 45.0 x 23.8 mm
