amperes-robot/peta/mech/DXFs/arm/Flat-frontarm_curved.DXF

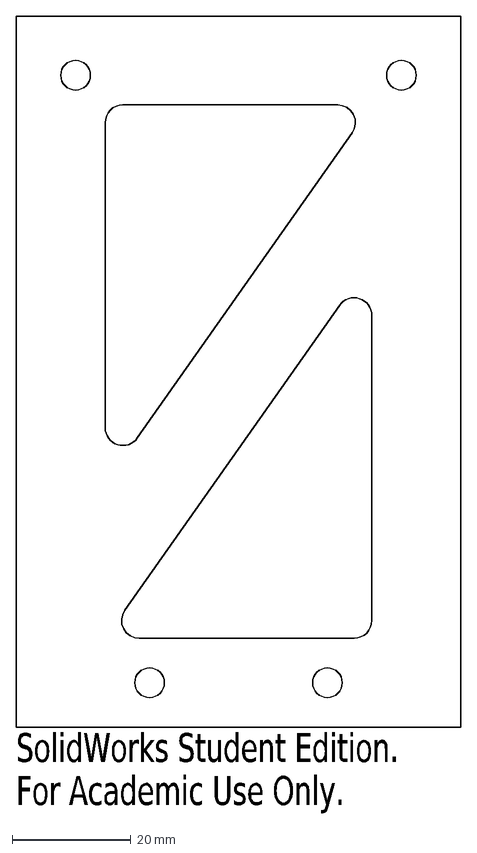
[picture p99: CAD file, 2015-07-09]
mech/DXFs/arm/Flat-frontarm_curved.DXF
SolidWorks Student Edition.
For Academic Use Only.
