amperes-robot/peta/mech/DXFs/boxArm/Flat pattern - armSupport.DXF

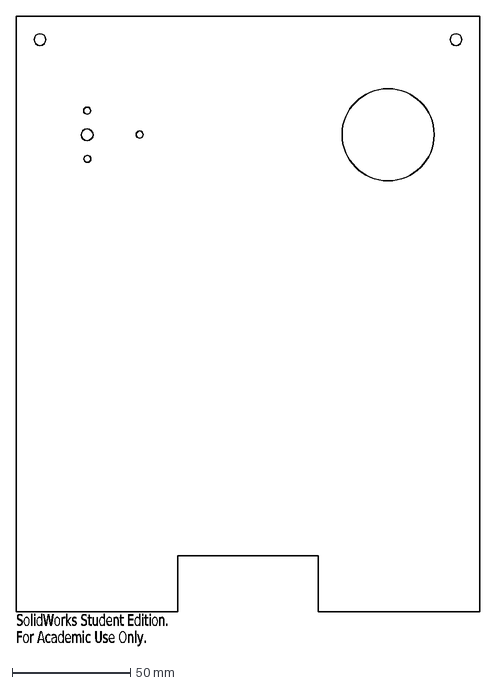
[picture p100: CAD file, 2015-07-23]
mech/DXFs/boxArm/Flat pattern - armSupport.DXF
SolidWorks Student Edition.
For Academic Use Only.
