amperes-robot/peta/mech/DXFs/chassis/Flat pattern - boadBackPanel.DXF

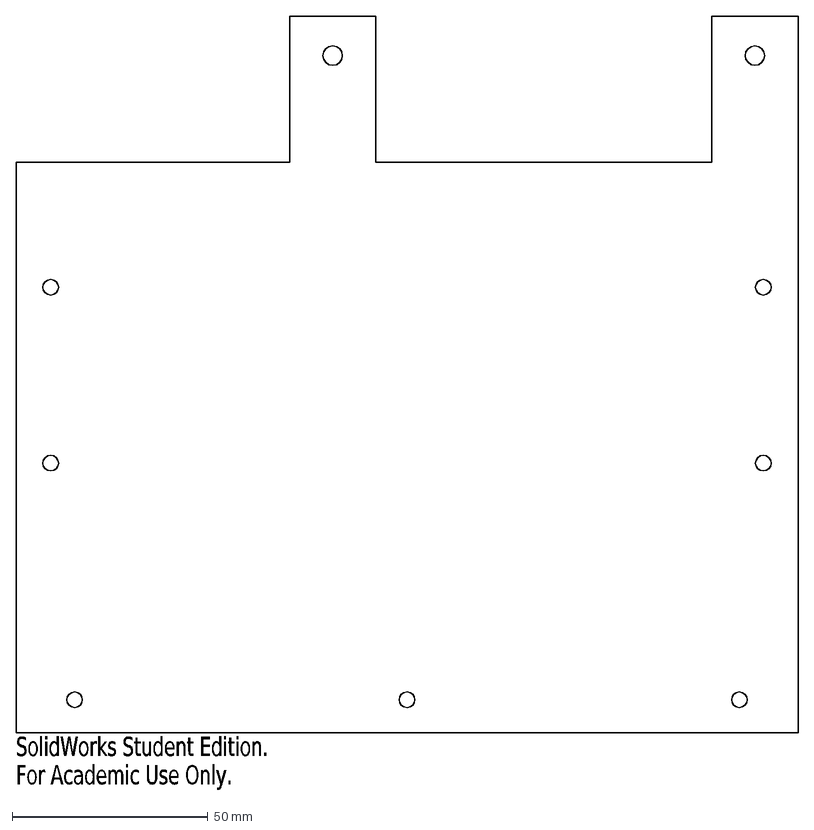
[picture p101: CAD file, 2015-06-25]
mech/DXFs/chassis/Flat pattern - boadBackPanel.DXF
SolidWorks Student Edition.
For Academic Use Only.
