amperes-robot/peta/mech/DXFs/Flat pattern - AxelMotorBracket_NoHoles.DXF

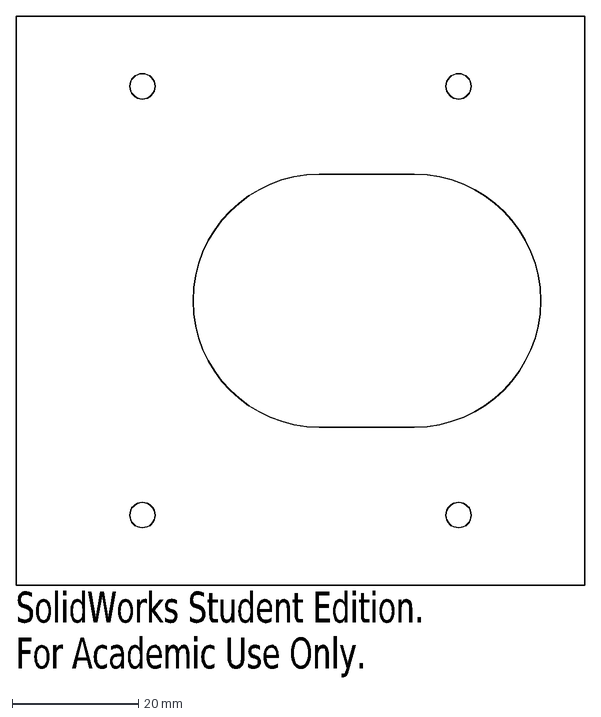
[picture p102: CAD file, 2015-07-22]
mech/DXFs/Flat pattern - AxelMotorBracket_NoHoles.DXF
SolidWorks Student Edition.
For Academic Use Only.
