amperes-robot/peta/mech/DXFs/Zipline/Flat pattern - ZiplineSupport.DXF

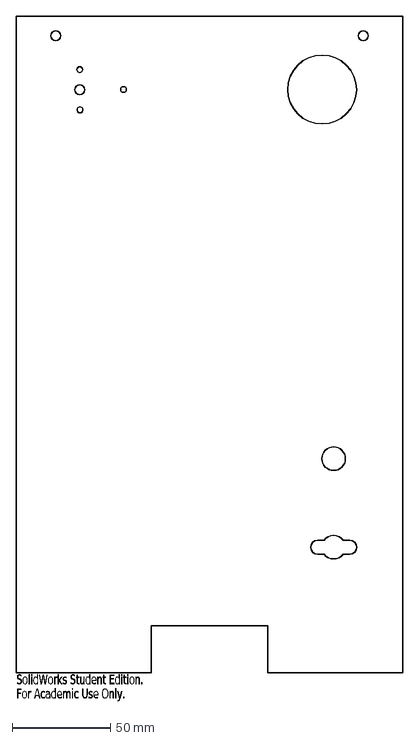
[picture p103: CAD file, 2015-07-17]
mech/DXFs/Zipline/Flat pattern - ZiplineSupport.DXF
SolidWorks Student Edition.
For Academic Use Only.
