amperes-robot/peta/mech/ext/axle.SLDPRT

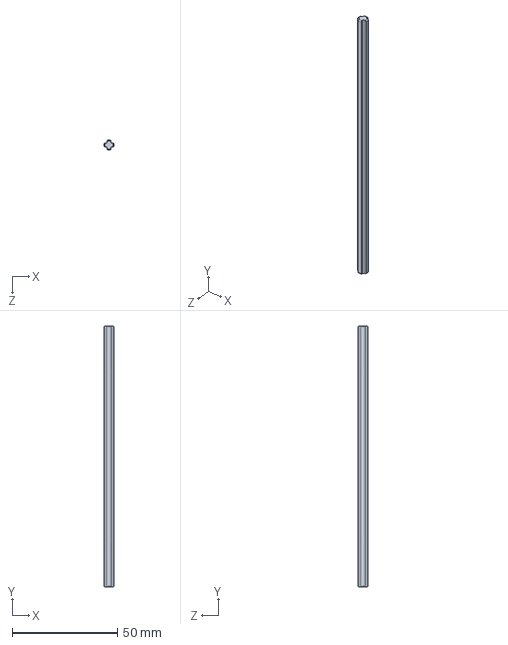
[picture p104: CAD file, 2015-06-18]
mech/ext/axle.SLDPRT
4.78 x 124.0 x 4.78 mm
