amperes-robot/peta/mech/ext/meccano gear/Meccano Gear 65mm.SLDPRT

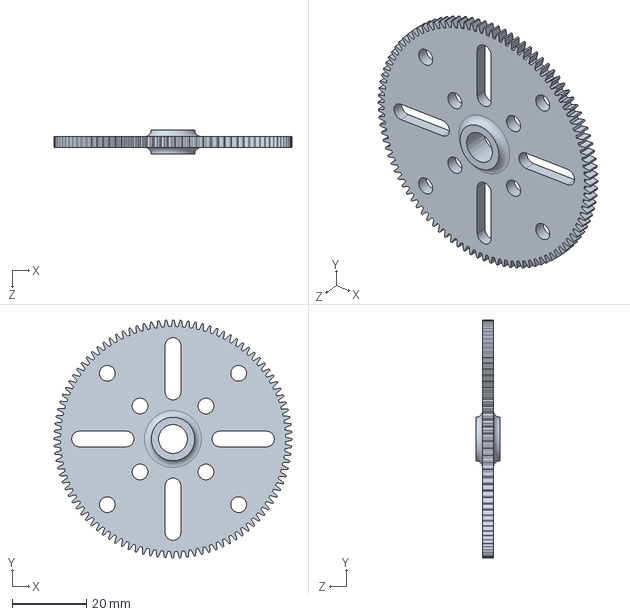
[picture p105: CAD file, 2015-06-16]
mech/ext/meccano gear/Meccano Gear 65mm.SLDPRT
64.3 x 64.3 x 6.58 mm
