amperes-robot/peta/mech/ext/QRD/QRD Chasis.SLDPRT

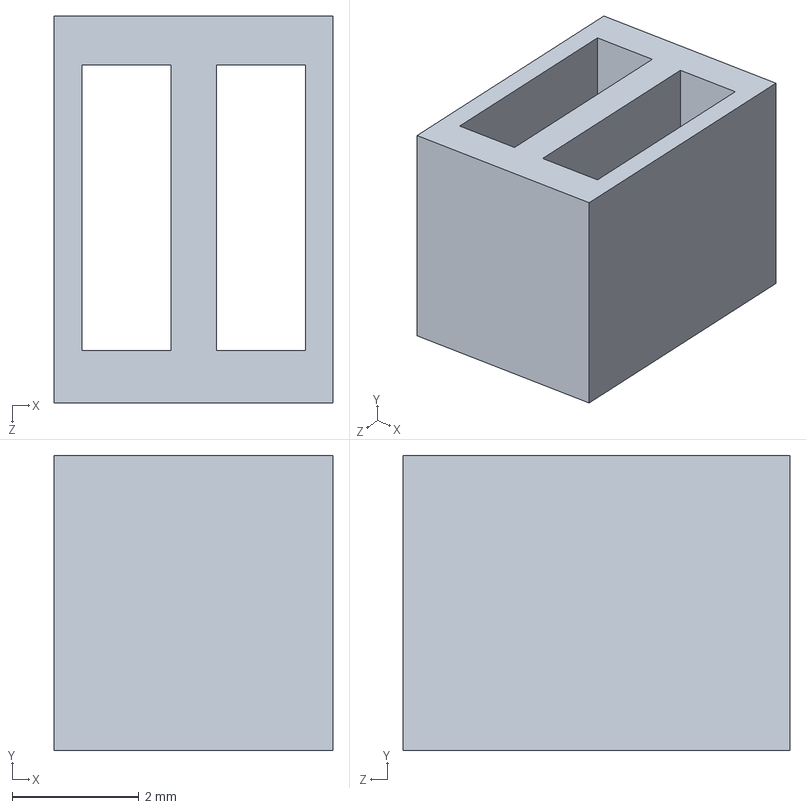
[picture p106: CAD file, 2015-06-16]
mech/ext/QRD/QRD Chasis.SLDPRT
4.39 x 4.65 x 6.10 mm
