amperes-robot/peta/mech/GearBox/Base.SLDPRT

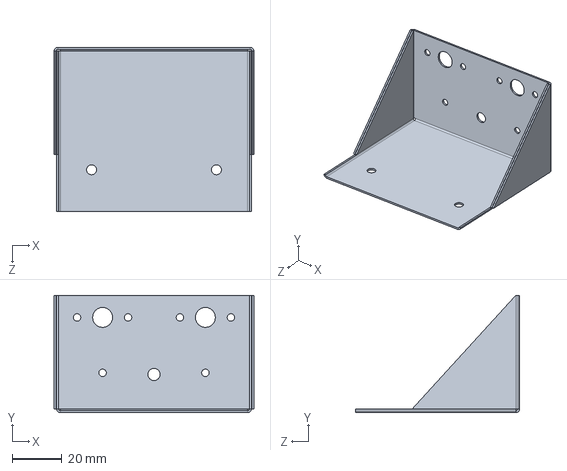
[picture p107: CAD file, 2015-07-06]
mech/GearBox/Base.SLDPRT
80.1 x 47.0 x 65.8 mm
