amperes-robot/peta/mech/Gears/WheelGearSolidworksWoffset.SLDPRT

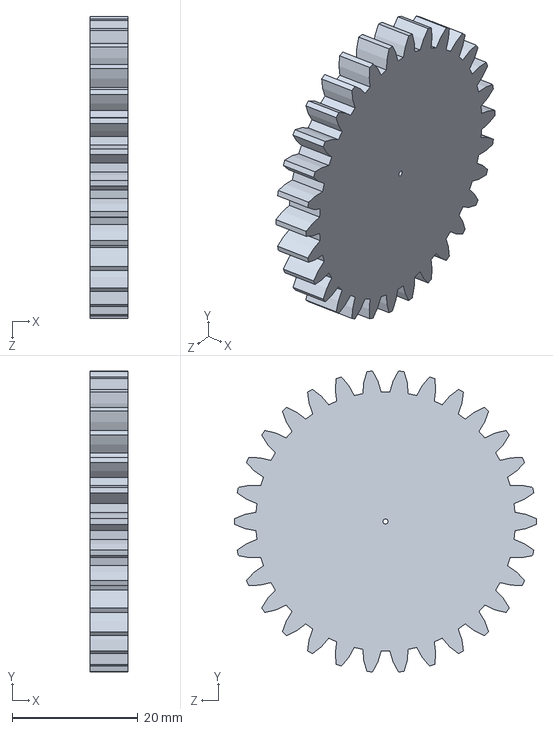
[picture p108: CAD file, 2015-07-11]
mech/Gears/WheelGearSolidworksWoffset.SLDPRT
6.00 x 47.8 x 48.0 mm
