amperes-robot/peta/mech/petArm/knockOffToolSheetMetal.SLDPRT

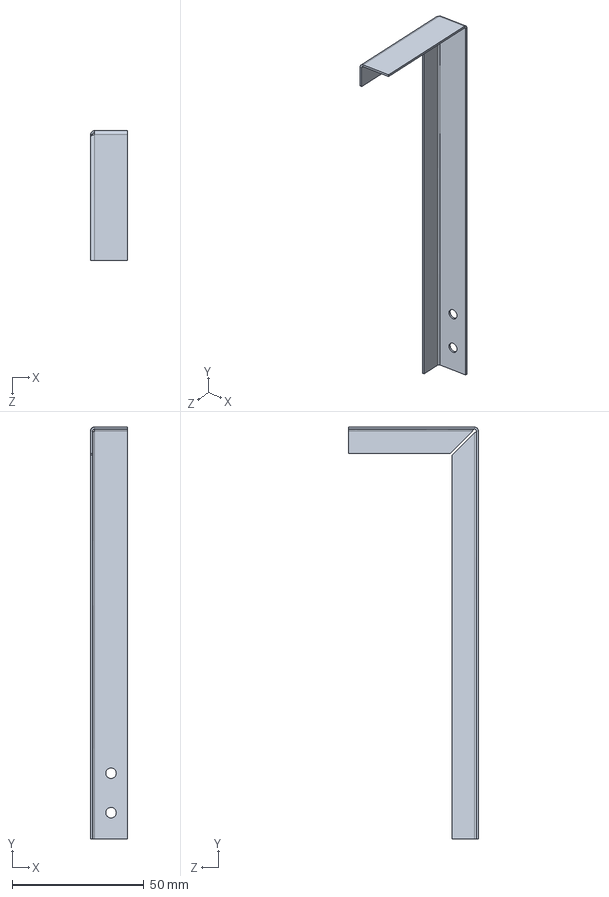
[picture p109: CAD file, 2015-07-11]
mech/petArm/knockOffToolSheetMetal.SLDPRT
14.0 x 156.5 x 49.3 mm
