amperes-robot/peta/mech/better_gear.SLDPRT

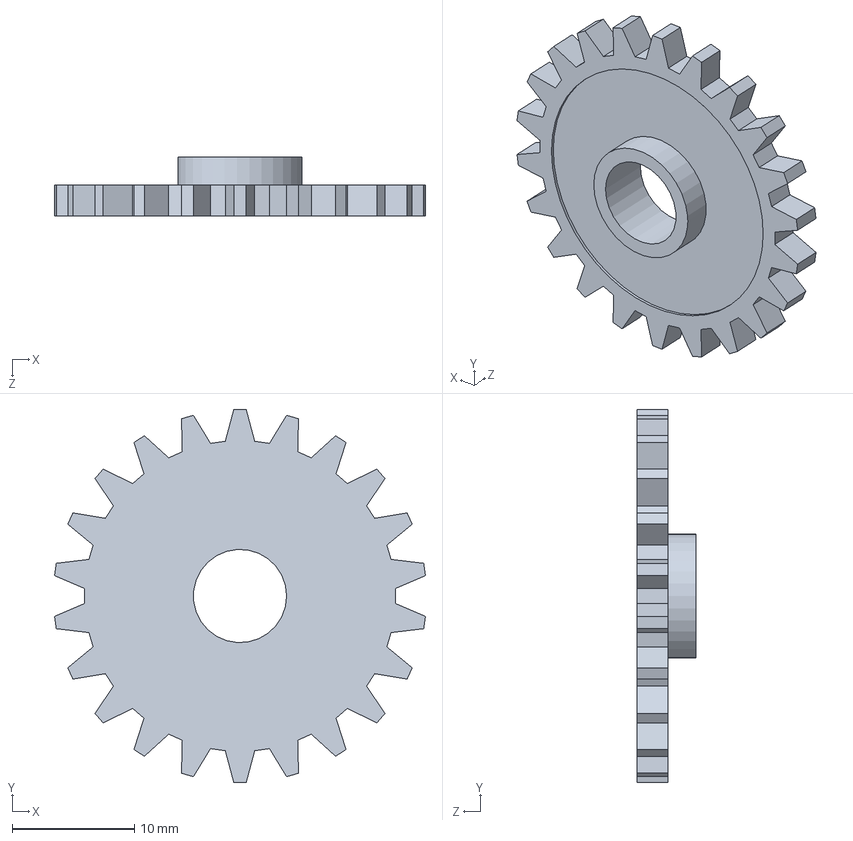
[picture p110: CAD file, 2015-06-17]
mech/better_gear.SLDPRT
30.3 x 30.5 x 4.83 mm
