amperes-robot/peta/mech/boxArm/armSupport.SLDPRT

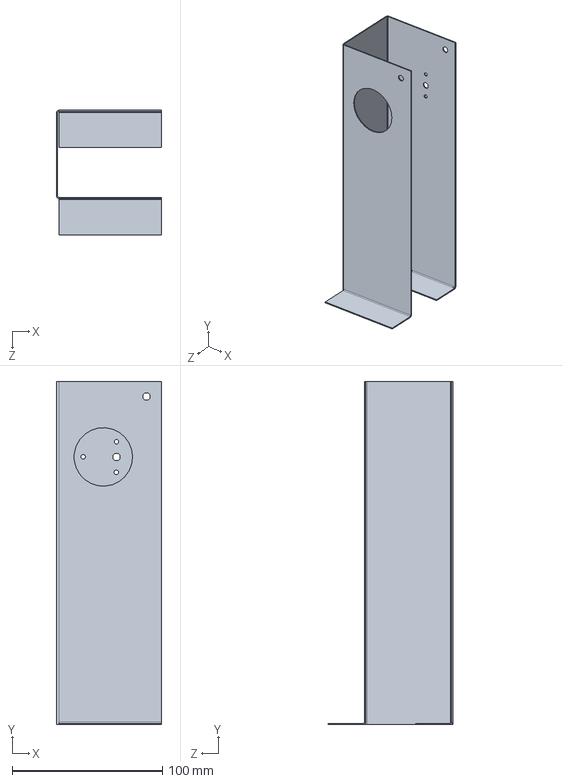
[picture p111: CAD file, 2015-07-23]
mech/boxArm/armSupport.SLDPRT
70.0 x 228.6 x 83.0 mm
