amperes-robot/peta/mech/chassis/boardTray.SLDPRT

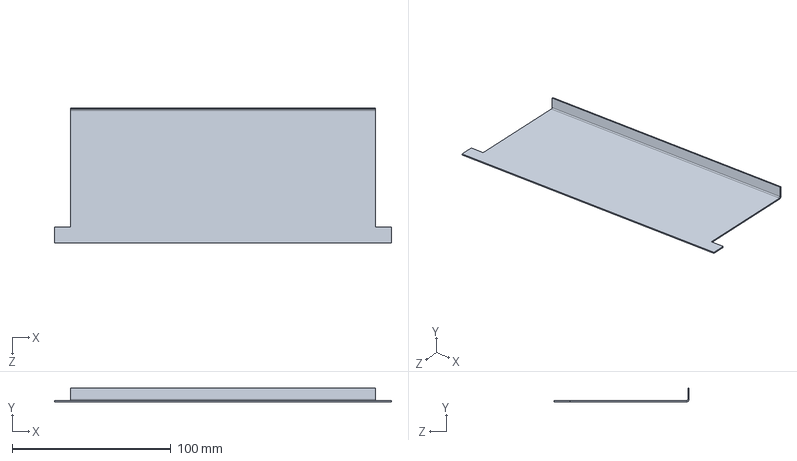
[picture p112: CAD file, 2015-06-25]
mech/chassis/boardTray.SLDPRT
212.0 x 8.81 x 85.0 mm
