amperes-robot/peta/mech/DXFs/arm/FrontLBracket.DXF

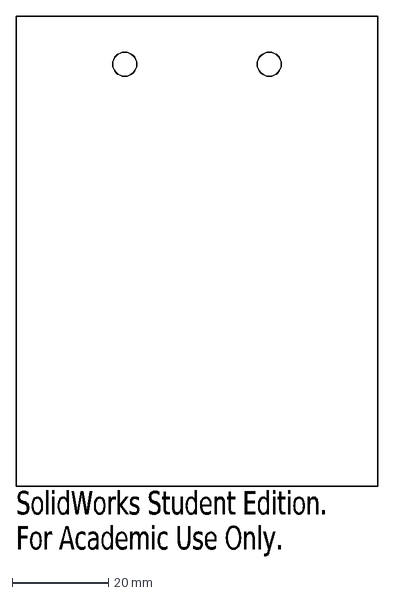
[picture p113: CAD file, 2015-07-09]
mech/DXFs/arm/FrontLBracket.DXF
SolidWorks Student Edition.
For Academic Use Only.
