amperes-robot/peta/mech/DXFs/chassis/Flat pattern - SledV2.DXF

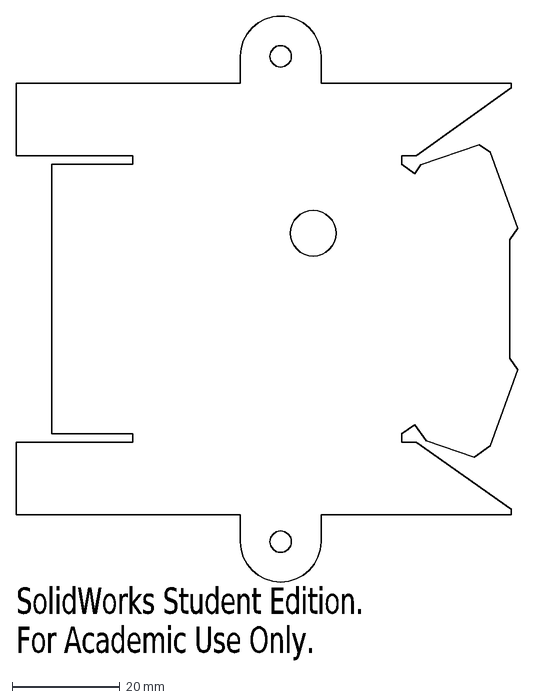
[picture p114: CAD file, 2015-06-24]
mech/DXFs/chassis/Flat pattern - SledV2.DXF
SolidWorks Student Edition.
For Academic Use Only.
