amperes-robot/peta/mech/DXFs/Zipline/Flat pattern - winchBody.DXF

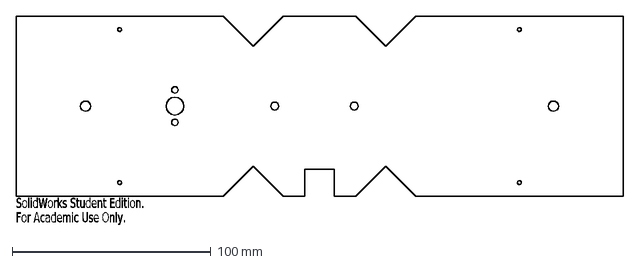
[picture p115: CAD file, 2015-07-11]
mech/DXFs/Zipline/Flat pattern - winchBody.DXF
SolidWorks Student Edition.
For Academic Use Only.
