amperes-robot/peta/mech/ext/gear_12_bevel_lego.sldprt

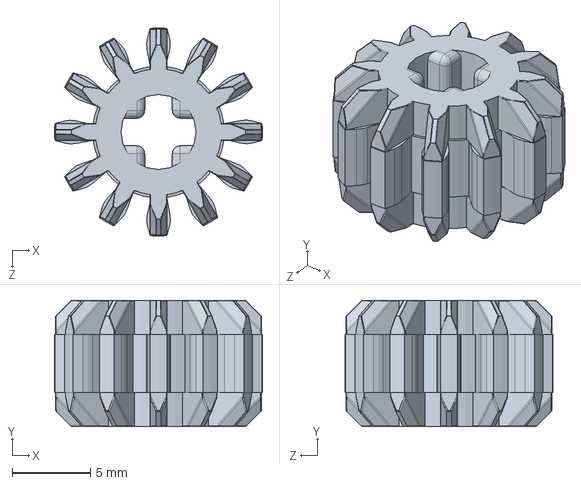
[picture p116: CAD file, 2015-06-18]
mech/ext/gear_12_bevel_lego.sldprt
13.3 x 8.07 x 13.3 mm
