amperes-robot/peta/mech/ext/QRD/receptor qrd.SLDPRT

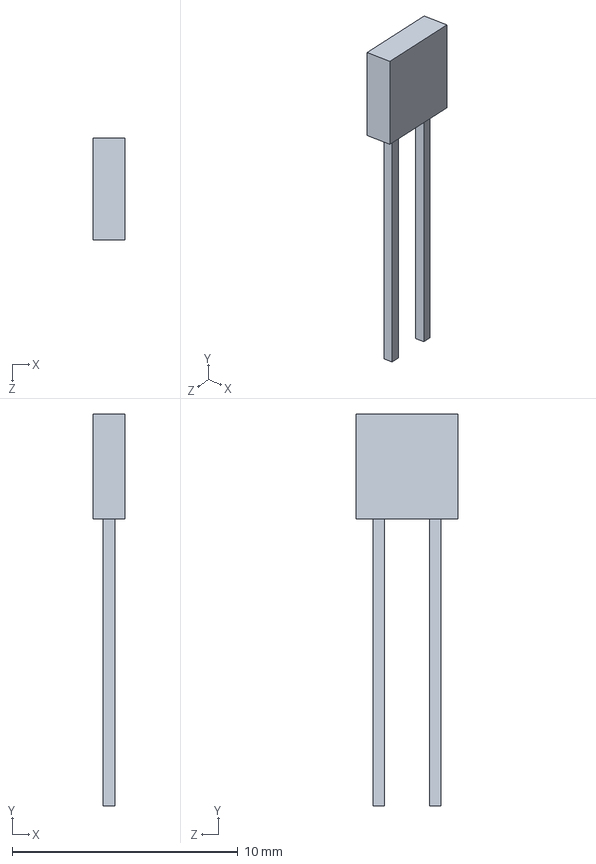
[picture p117: CAD file, 2015-06-16]
mech/ext/QRD/receptor qrd.SLDPRT
1.40 x 17.4 x 4.50 mm
