amperes-robot/peta/mech/GearBox/axleSupport.SLDPRT

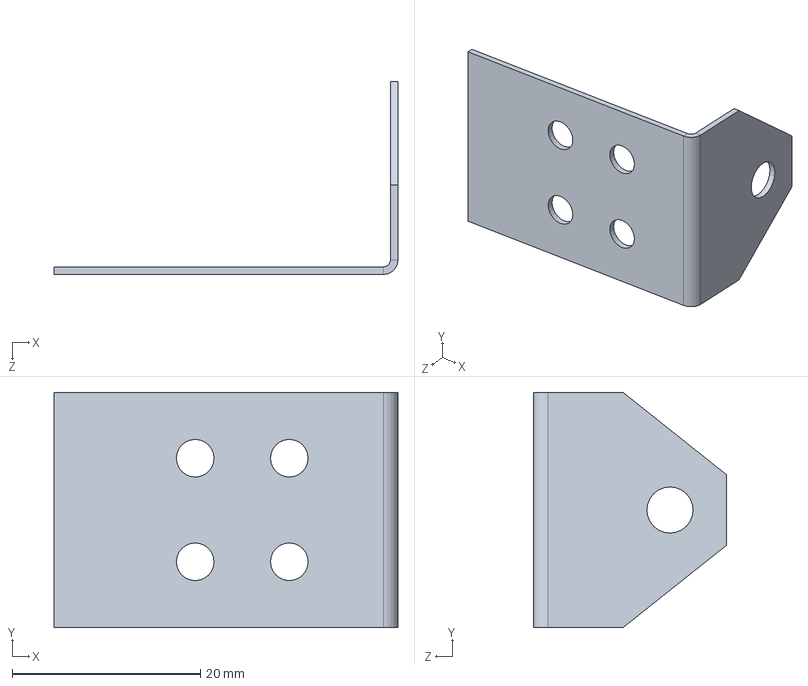
[picture p118: CAD file, 2015-07-02]
mech/GearBox/axleSupport.SLDPRT
36.5 x 25.0 x 20.5 mm
