amperes-robot/peta/mech/Gears/EncoderGearSolidworks.SLDPRT

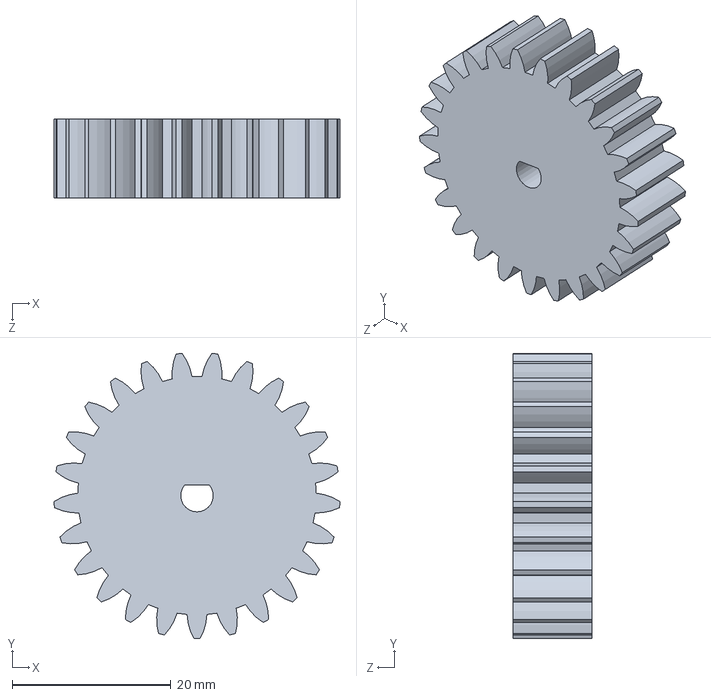
[picture p119: CAD file, 2015-07-11]
mech/Gears/EncoderGearSolidworks.SLDPRT
36.1 x 36.0 x 10.0 mm
