amperes-robot/peta/mech/petArm/armBase.SLDPRT

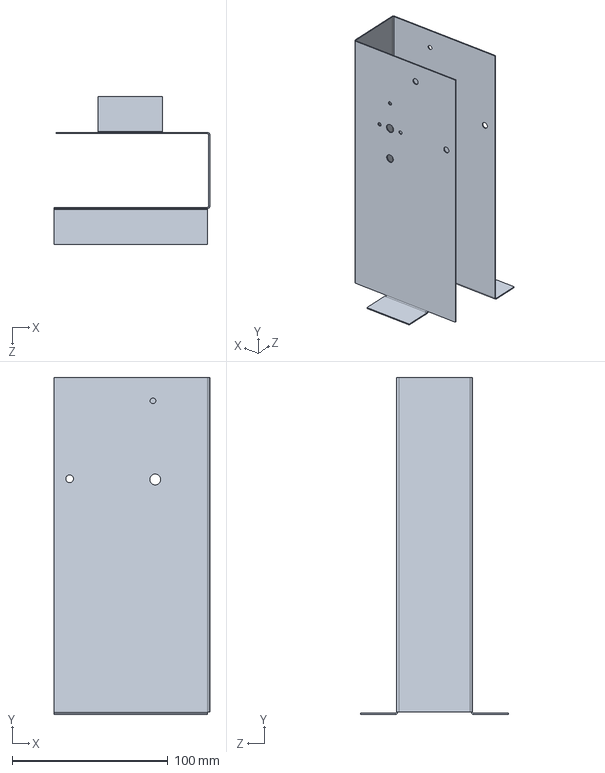
[picture p120: CAD file, 2015-07-09]
mech/petArm/armBase.SLDPRT
100.0 x 216.2 x 94.8 mm
