amperes-robot/peta/mech/chassis/boadBackPanel.SLDPRT

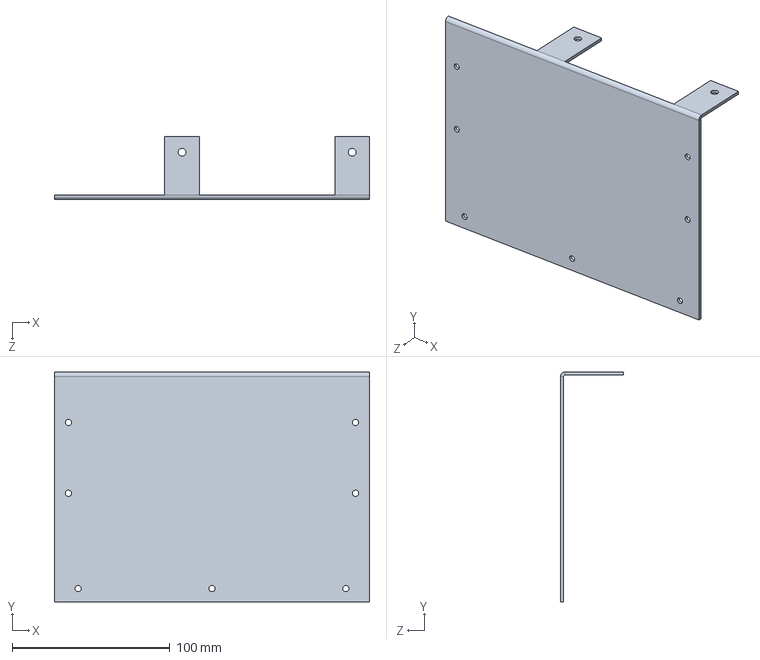
[picture p121: CAD file, 2015-06-25]
mech/chassis/boadBackPanel.SLDPRT
200.0 x 146.0 x 40.0 mm
