amperes-robot/peta/mech/DXFs/arm/Flat-frontarm.DXF

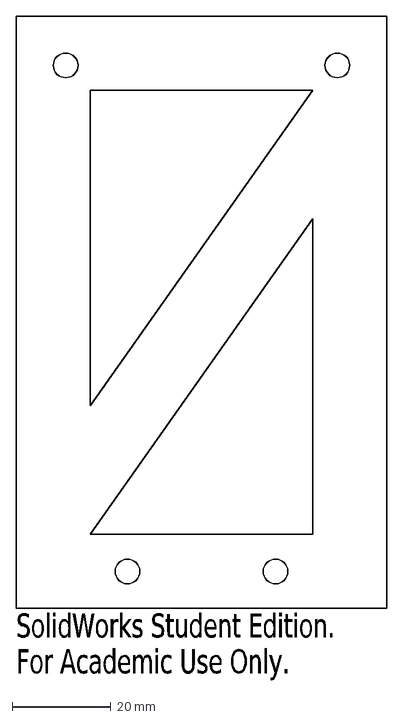
[picture p122: CAD file, 2015-07-09]
mech/DXFs/arm/Flat-frontarm.DXF
SolidWorks Student Edition.
For Academic Use Only.
