amperes-robot/peta/mech/DXFs/chassis/Flat pattern - boardTrayTopTINAH.DXF

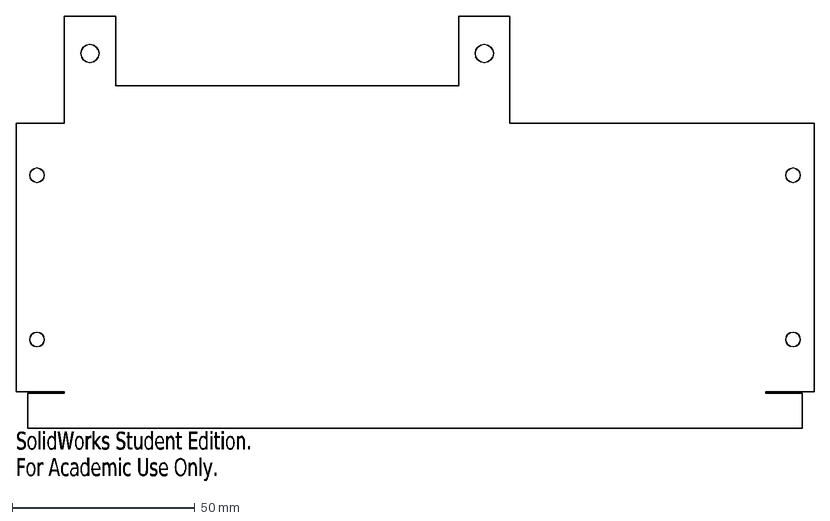
[picture p123: CAD file, 2015-06-20]
mech/DXFs/chassis/Flat pattern - boardTrayTopTINAH.DXF
SolidWorks Student Edition.
For Academic Use Only.
