amperes-robot/peta/mech/DXFs/MotorGearSolidworksFORWATERJET.DXF

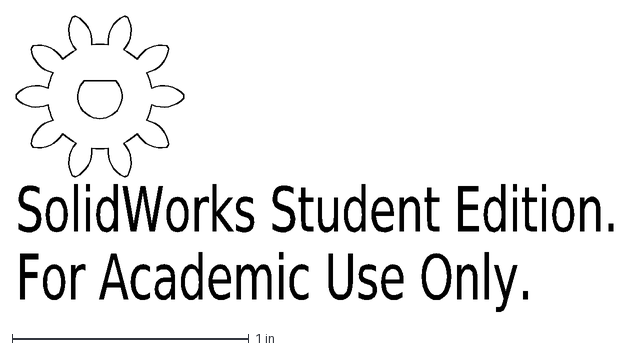
[picture p124: CAD file, 2015-07-09]
mech/DXFs/MotorGearSolidworksFORWATERJET.DXF
SolidWorks Student Edition.
For Academic Use Only.
