amperes-robot/peta/mech/DXFs/Zipline/Flat pattern - ziplineWinchBracket.DXF

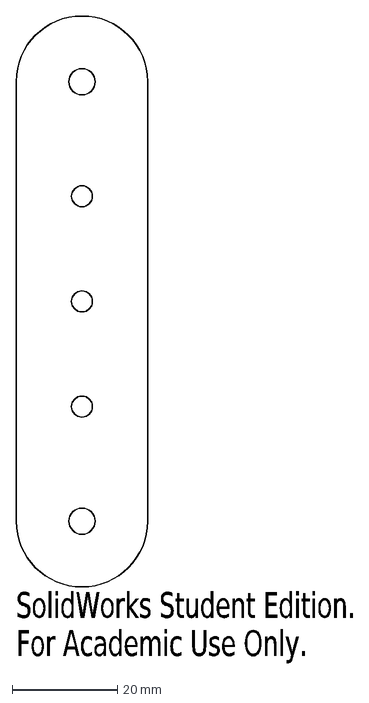
[picture p125: CAD file, 2015-07-09]
mech/DXFs/Zipline/Flat pattern - ziplineWinchBracket.DXF
SolidWorks Student Edition.
For Academic Use Only.
