amperes-robot/peta/mech/ext/hub.SLDPRT

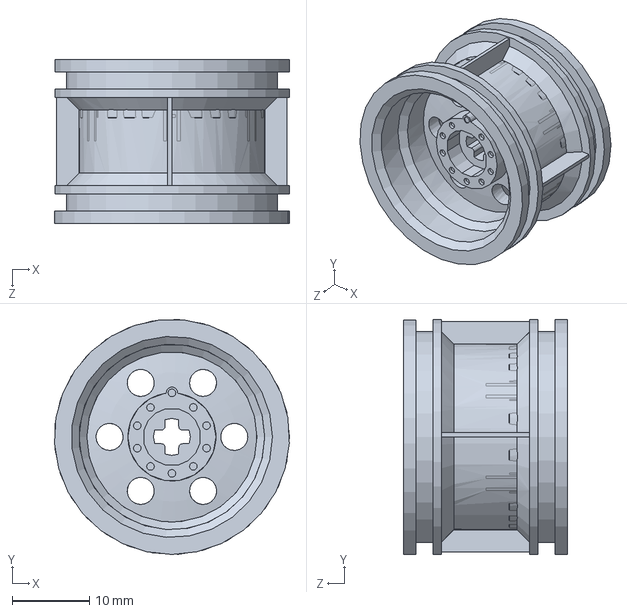
[picture p126: CAD file, 2015-06-16]
mech/ext/hub.SLDPRT
30.4 x 30.4 x 21.2 mm
