amperes-robot/peta/mech/ext/meccano gear/Meccano Gear 13.5mm.SLDPRT

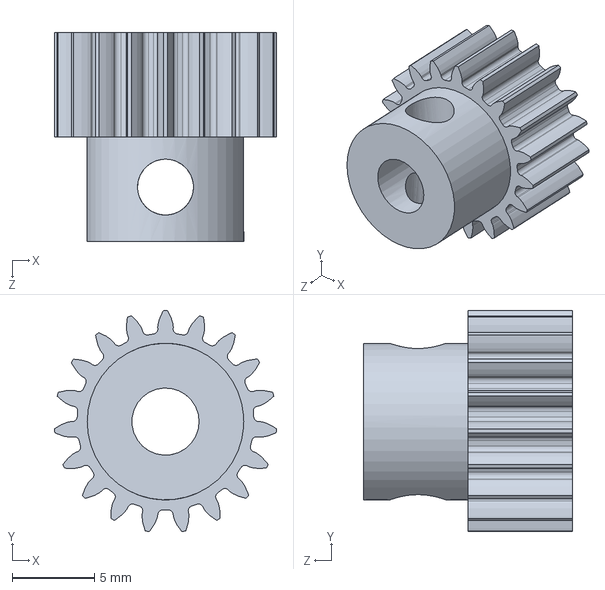
[picture p127: CAD file, 2015-06-16]
mech/ext/meccano gear/Meccano Gear 13.5mm.SLDPRT
13.5 x 13.5 x 12.7 mm
