amperes-robot/peta/mech/Gear_Blank.SLDPRT

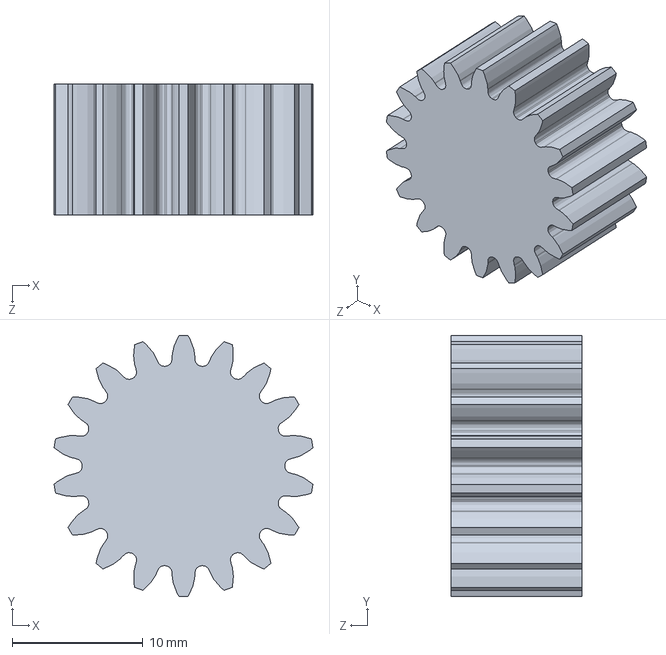
[picture p128: CAD file, 2015-06-17]
mech/Gear_Blank.SLDPRT
19.8 x 20.0 x 10.0 mm
