amperes-robot/peta/mech/GearBox/steelAxle.SLDPRT

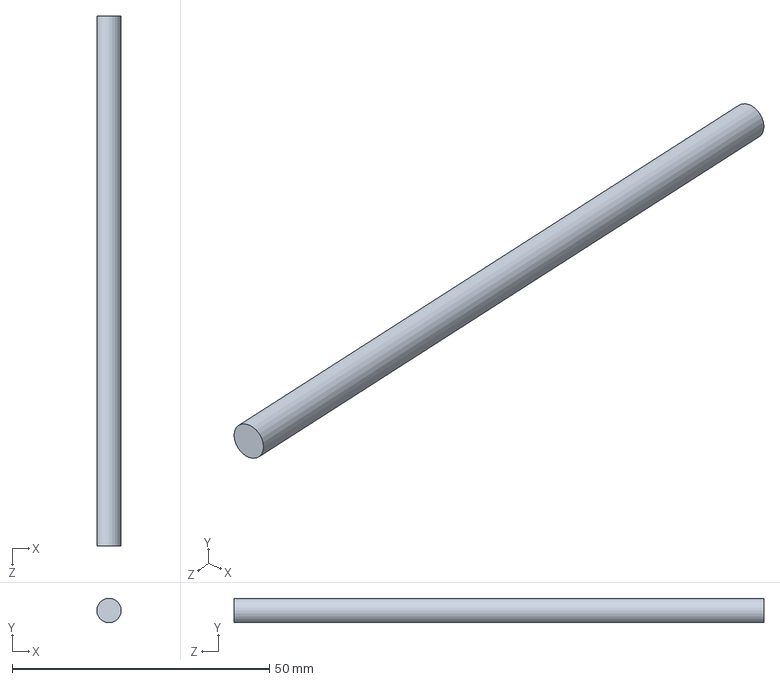
[picture p129: CAD file, 2015-07-02]
mech/GearBox/steelAxle.SLDPRT
4.75 x 4.75 x 103.0 mm
