amperes-robot/peta/mech/Gears/MotorGearSolidworksWoffset.SLDPRT

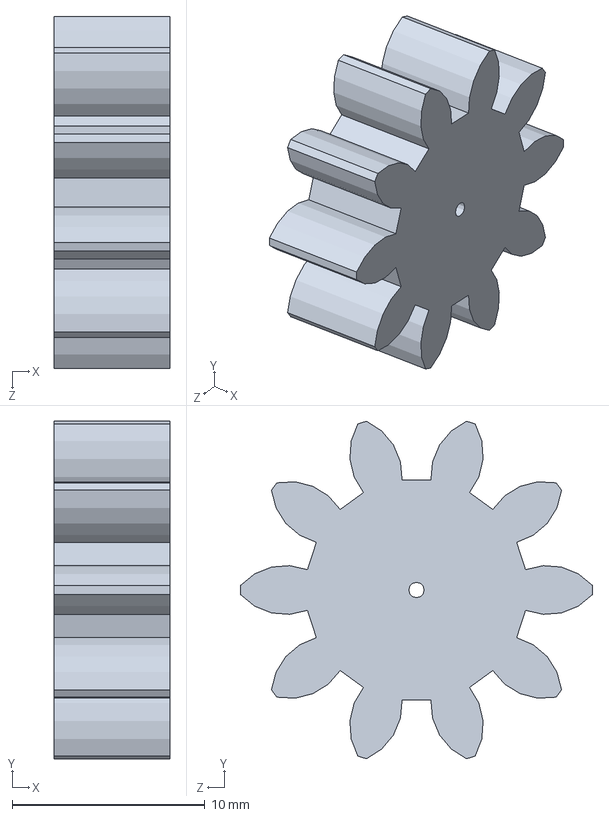
[picture p130: CAD file, 2015-06-30]
mech/Gears/MotorGearSolidworksWoffset.SLDPRT
6.00 x 17.5 x 18.2 mm
