amperes-robot/peta/mech/petArm/armBracket.SLDPRT

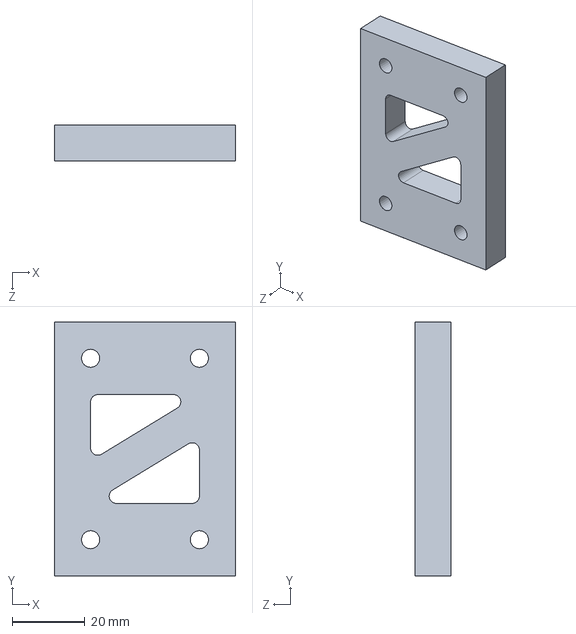
[picture p131: CAD file, 2015-07-06]
mech/petArm/armBracket.SLDPRT
50.0 x 70.0 x 10.0 mm
