amperes-robot/peta/mech/chassis/SledV2.SLDPRT

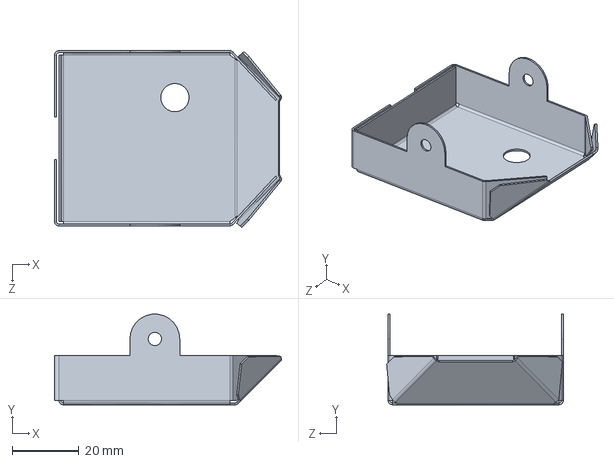
[picture p132: CAD file, 2015-06-24]
mech/chassis/SledV2.SLDPRT
68.2 x 27.2 x 53.1 mm
