amperes-robot/peta/mech/DXFs/arm/Flat pattern - LBracket.DXF

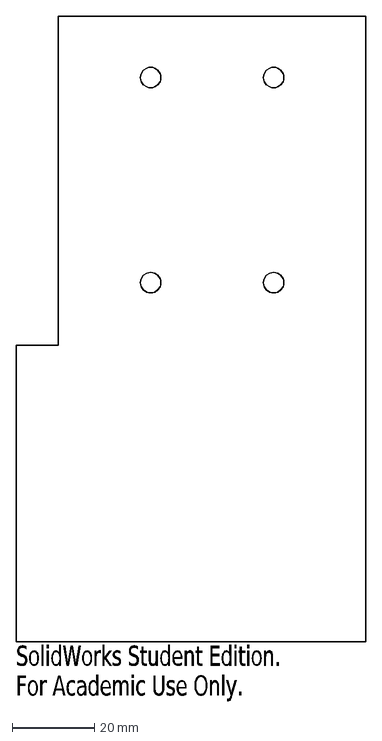
[picture p133: CAD file, 2015-07-06]
mech/DXFs/arm/Flat pattern - LBracket.DXF
SolidWorks Student Edition.
For Academic Use Only.
