amperes-robot/peta/mech/DXFs/chassis/Flat pattern - sledBracket.DXF

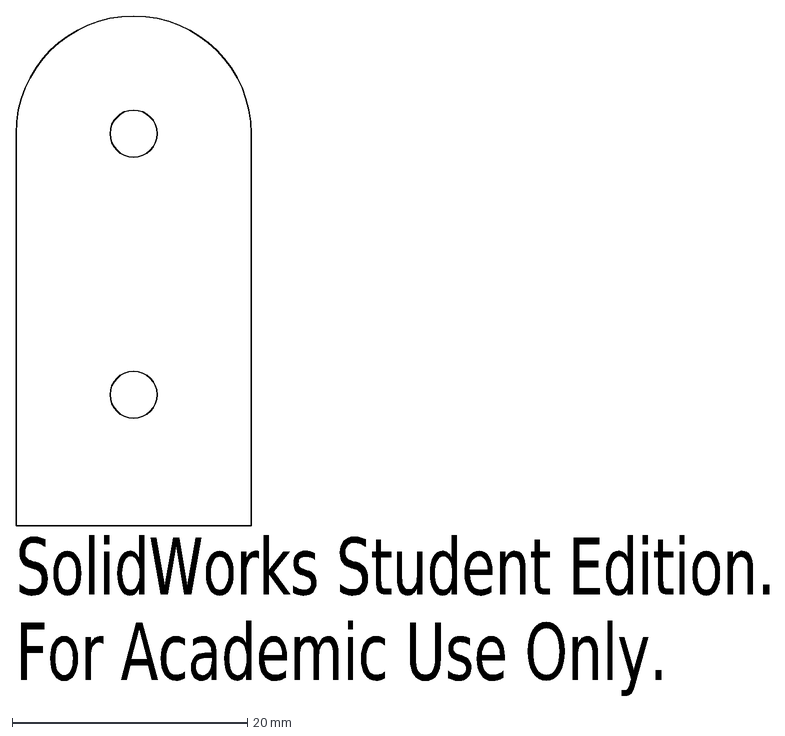
[picture p134: CAD file, 2015-06-19]
mech/DXFs/chassis/Flat pattern - sledBracket.DXF
SolidWorks Student Edition.
For Academic Use Only.
