amperes-robot/peta/mech/DXFs/MotorGearSolidworksWoffset.DXF

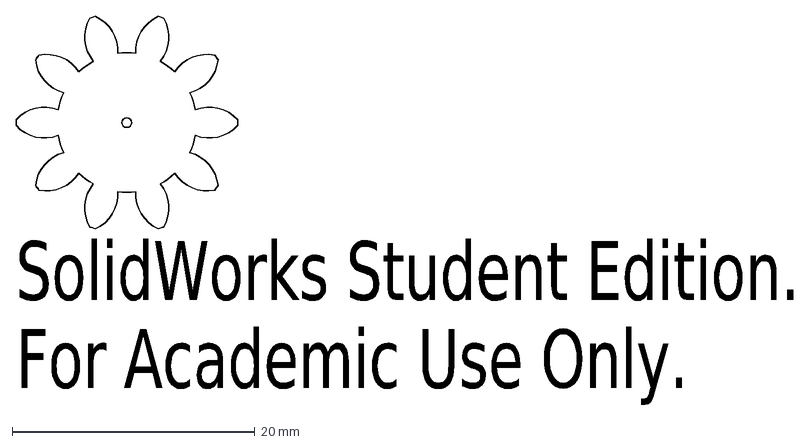
[picture p135: CAD file, 2015-07-02]
mech/DXFs/MotorGearSolidworksWoffset.DXF
SolidWorks Student Edition.
For Academic Use Only.
