amperes-robot/peta/mech/DXFs/Zipline/Flat pattern - ziplineCBracket.DXF

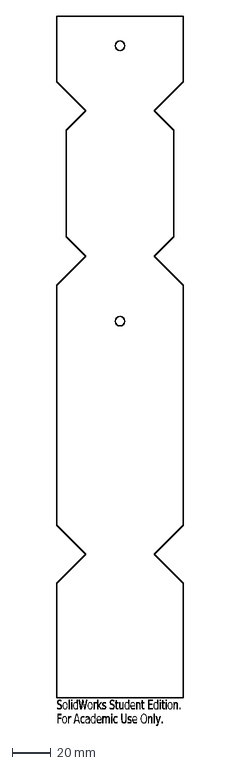
[picture p136: CAD file, 2015-07-06]
mech/DXFs/Zipline/Flat pattern - ziplineCBracket.DXF
SolidWorks Student Edition.
For Academic Use Only.
