amperes-robot/peta/mech/ext/LiPoBattery.SLDPRT

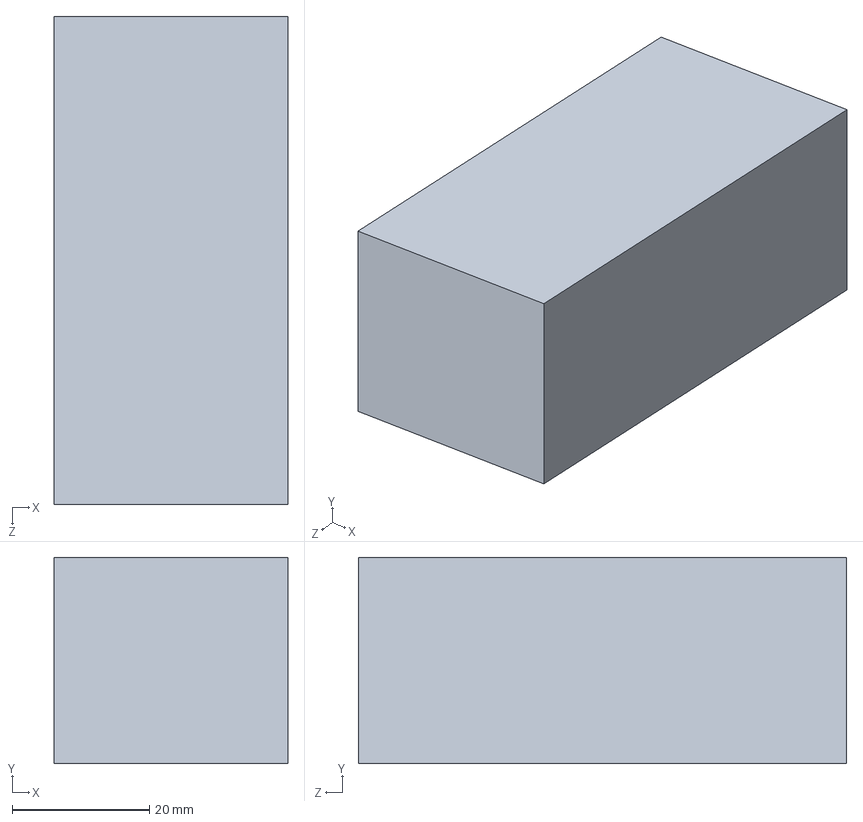
[picture p137: CAD file, 2015-06-16]
mech/ext/LiPoBattery.SLDPRT
34.0 x 30.0 x 71.0 mm
