amperes-robot/peta/mech/ext/meccano gear/helical gear 40 teeth.SLDPRT

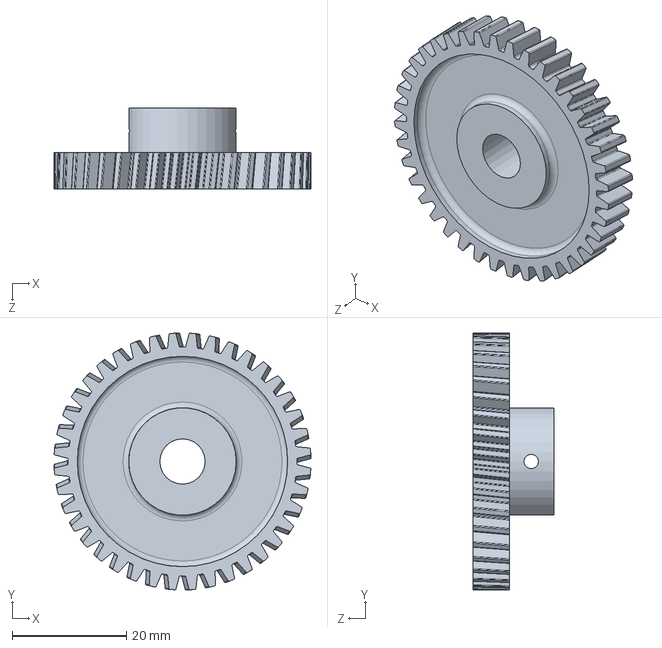
[picture p138: CAD file, 2015-06-16]
mech/ext/meccano gear/helical gear 40 teeth.SLDPRT
45.0 x 45.0 x 14.2 mm
