amperes-robot/peta/mech/ext/QRD/QRDsleeve.SLDPRT

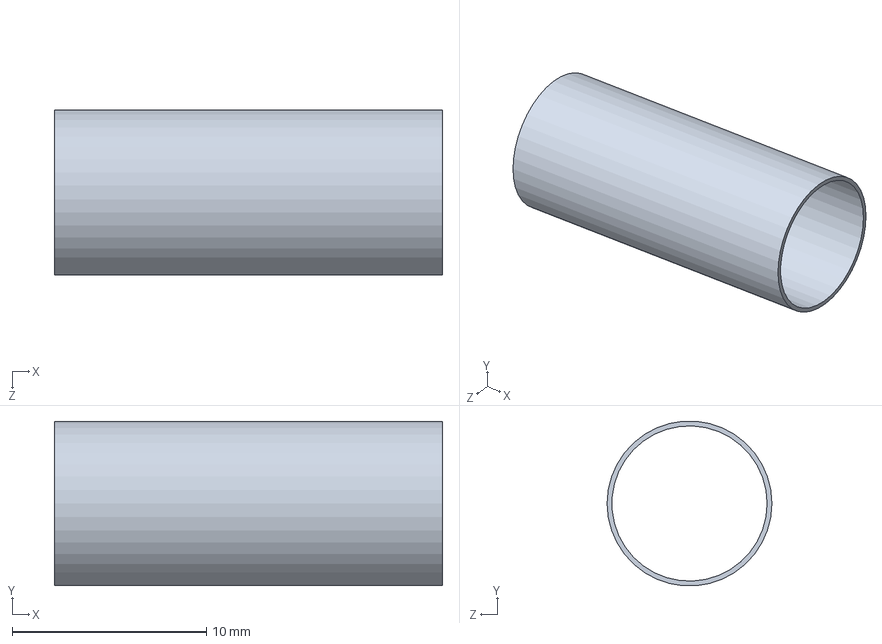
[picture p139: CAD file, 2015-06-16]
mech/ext/QRD/QRDsleeve.SLDPRT
20.0 x 8.47 x 8.50 mm
