amperes-robot/peta/mech/GearBox/Part3.SLDPRT

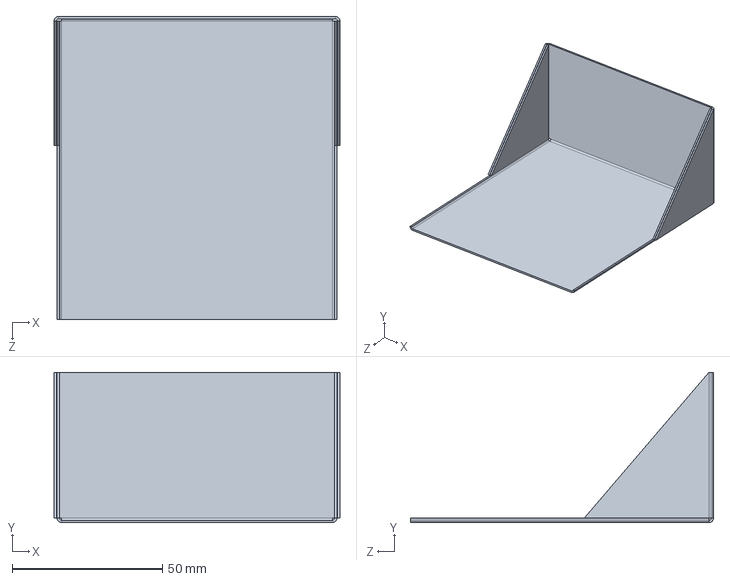
[picture p140: CAD file, 2015-06-27]
mech/GearBox/Part3.SLDPRT
95.1 x 50.0 x 100.8 mm
