amperes-robot/peta/mech/Gears/EncoderGearSolidworksWoffset.SLDPRT

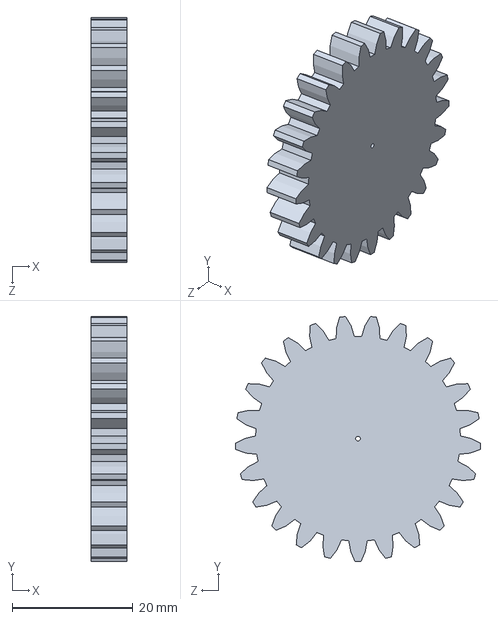
[picture p141: CAD file, 2015-06-30]
mech/Gears/EncoderGearSolidworksWoffset.SLDPRT
6.00 x 40.6 x 40.7 mm
