amperes-robot/peta/mech/petArm/ArmLongSection.SLDPRT

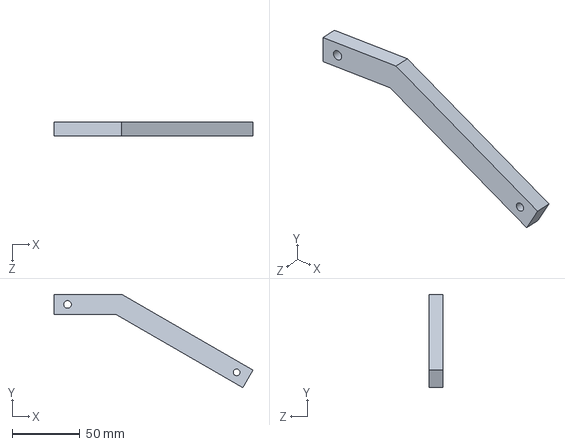
[picture p142: CAD file, 2015-07-06]
mech/petArm/ArmLongSection.SLDPRT
147.0 x 69.0 x 10.0 mm
