amperes-robot/peta/mech/zipLine/printedShaftFitting.SLDPRT

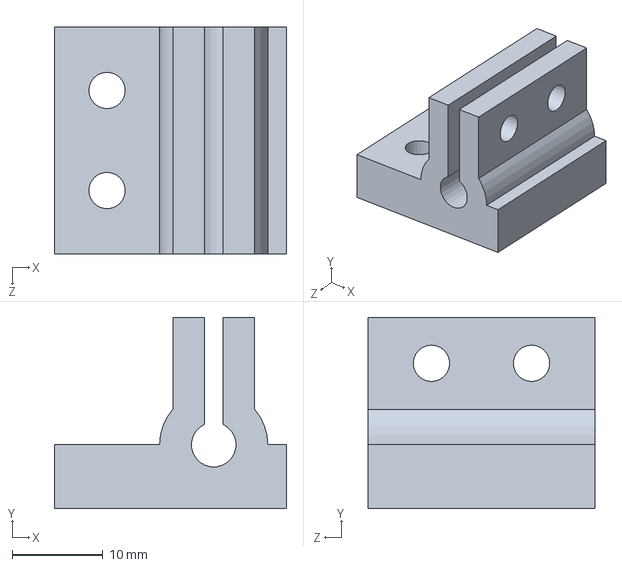
[picture p143: CAD file, 2015-07-28]
mech/zipLine/printedShaftFitting.SLDPRT
25.5 x 21.0 x 25.0 mm
