amperes-robot/peta/mech/chassis/boardTrayTopTINAH.SLDPRT

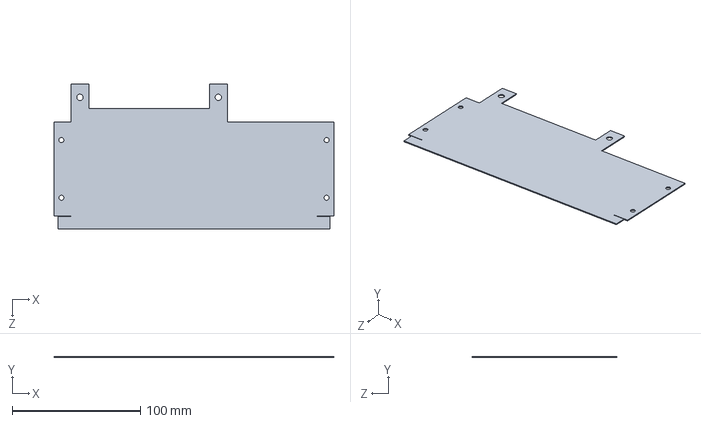
[picture p144: CAD file, 2015-06-20]
mech/chassis/boardTrayTopTINAH.SLDPRT
218.5 x 0.81 x 112.8 mm
