amperes-robot/peta/mech/DXFs/arm/Flat pattern - pickUpArmSensorPlate.DXF

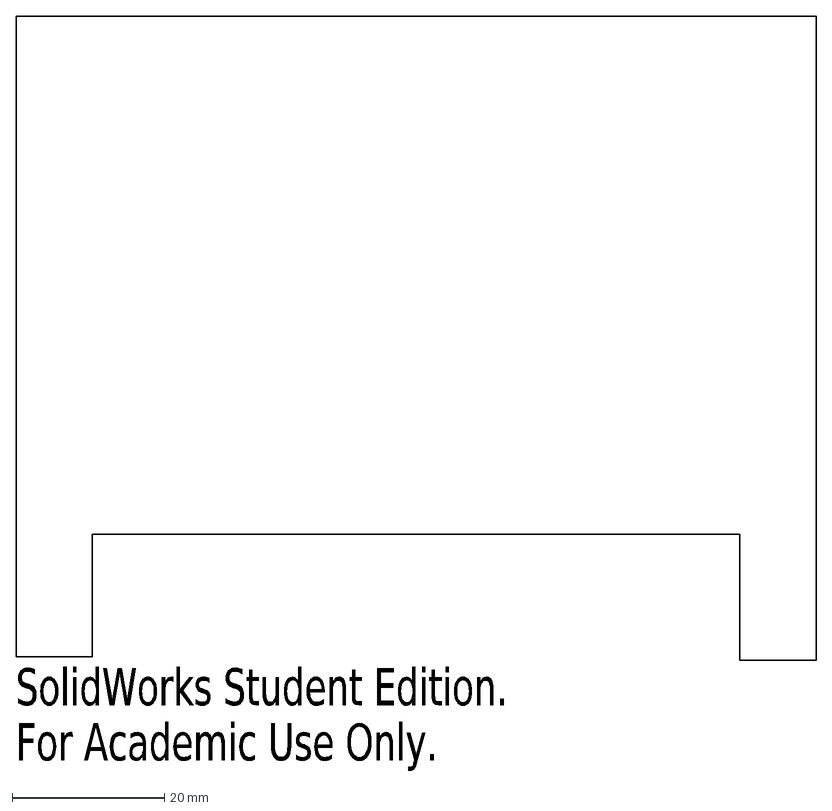
[picture p145: CAD file, 2015-07-06]
mech/DXFs/arm/Flat pattern - pickUpArmSensorPlate.DXF
SolidWorks Student Edition.
For Academic Use Only.
