amperes-robot/peta/mech/DXFs/chassis/Flat pattern - AxelMotorBracket.DXF

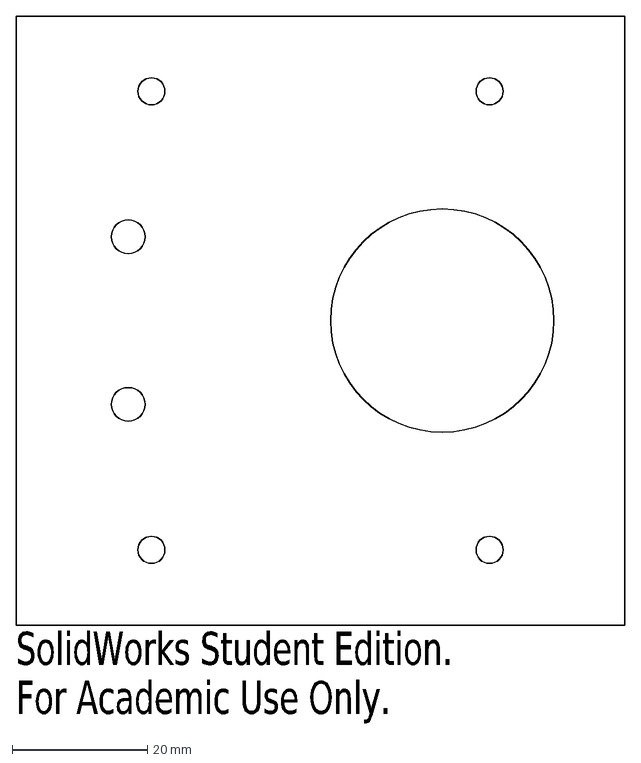
[picture p146: CAD file, 2015-06-19]
mech/DXFs/chassis/Flat pattern - AxelMotorBracket.DXF
SolidWorks Student Edition.
For Academic Use Only.
