amperes-robot/peta/mech/DXFs/EncoderGearSolidworksWoffset.DXF

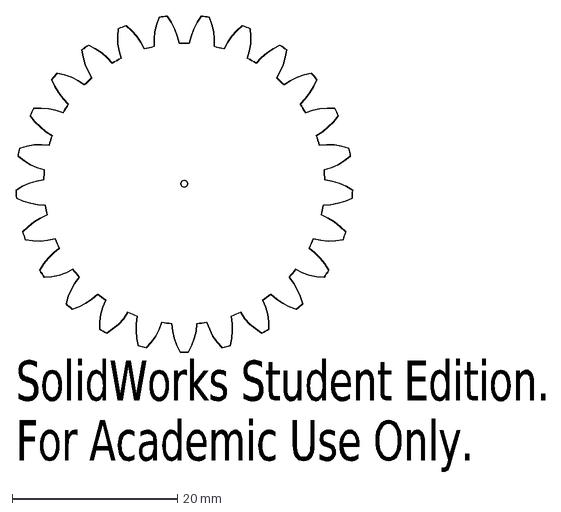
[picture p147: CAD file, 2015-07-02]
mech/DXFs/EncoderGearSolidworksWoffset.DXF
SolidWorks Student Edition.
For Academic Use Only.
