amperes-robot/peta/mech/ext/meccano gear/worm for helical gear.SLDPRT

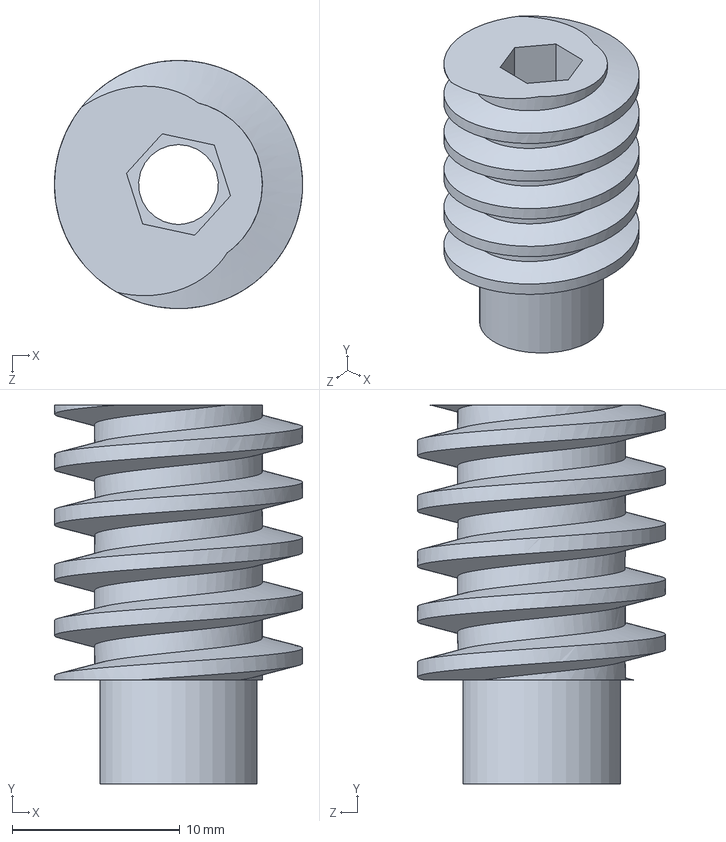
[picture p148: CAD file, 2015-06-16]
mech/ext/meccano gear/worm for helical gear.SLDPRT
14.8 x 22.6 x 14.8 mm
