amperes-robot/peta/mech/ext/pec11r-4x25f-sxxxx.SLDPRT

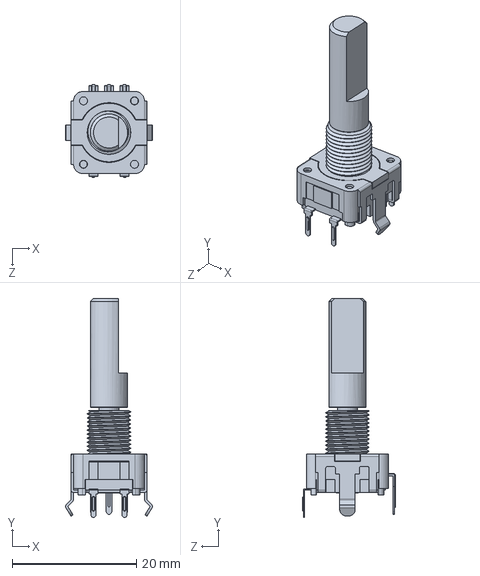
[picture p149: CAD file, 2015-06-16]
mech/ext/pec11r-4x25f-sxxxx.SLDPRT
14.0 x 35.2 x 14.9 mm
