amperes-robot/peta/mech/Gears/GearRetainer.SLDPRT

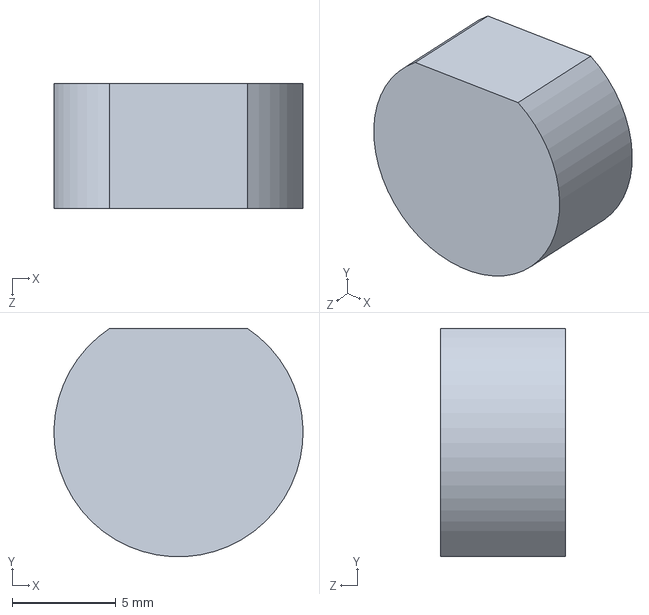
[picture p150: CAD file, 2015-06-27]
mech/Gears/GearRetainer.SLDPRT
12.0 x 11.0 x 6.00 mm
