amperes-robot/peta/mech/petArm/LBracketBack.SLDPRT

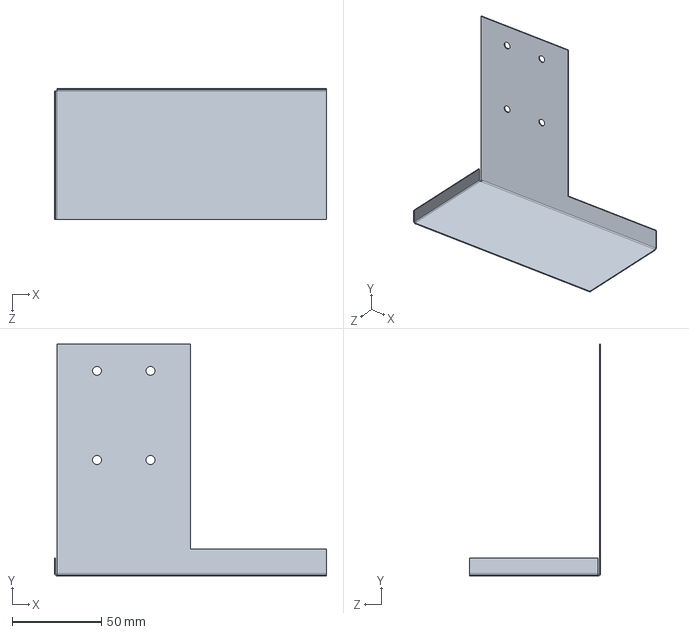
[picture p151: CAD file, 2015-07-06]
mech/petArm/LBracketBack.SLDPRT
152.5 x 130.0 x 73.6 mm
