amperes-robot/peta/mech/zipLine/ZiplineSupport.SLDPRT

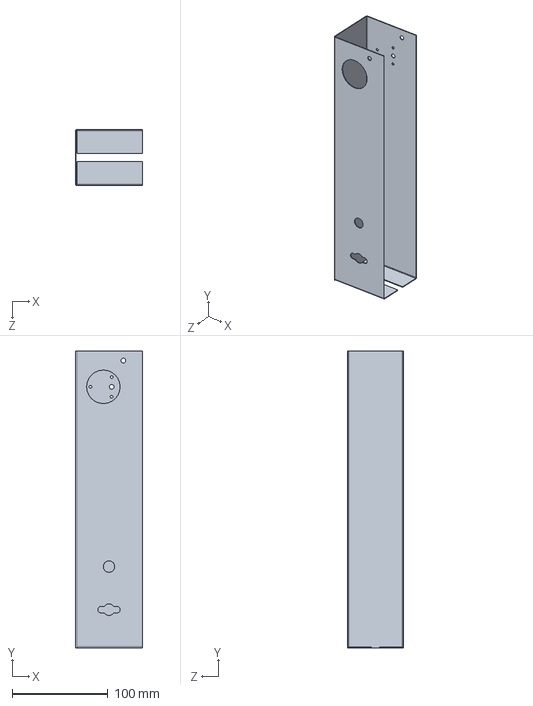
[picture p152: CAD file, 2015-07-17]
mech/zipLine/ZiplineSupport.SLDPRT
70.0 x 310.0 x 58.8 mm
