amperes-robot/peta/mech/chassis/sledBracket.SLDPRT

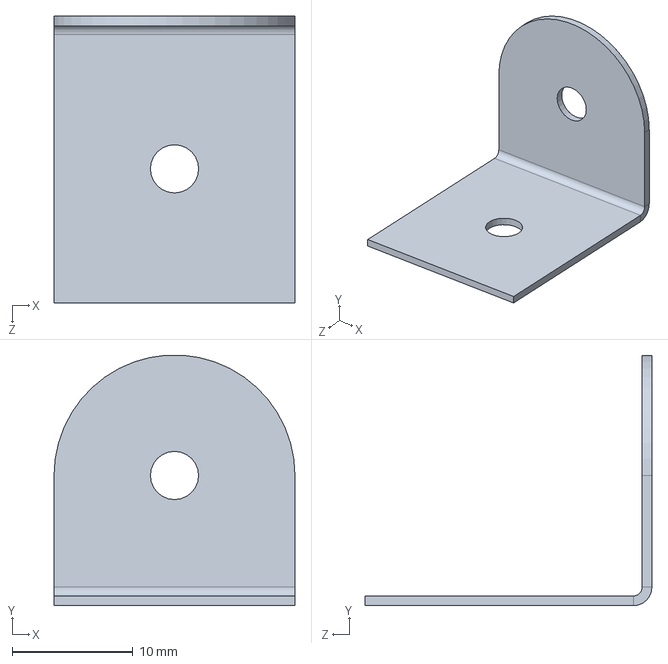
[picture p153: CAD file, 2015-06-19]
mech/chassis/sledBracket.SLDPRT
20.0 x 20.8 x 23.8 mm
