amperes-robot/peta/mech/DXFs/arm/Flat pattern - LBracketBack.DXF

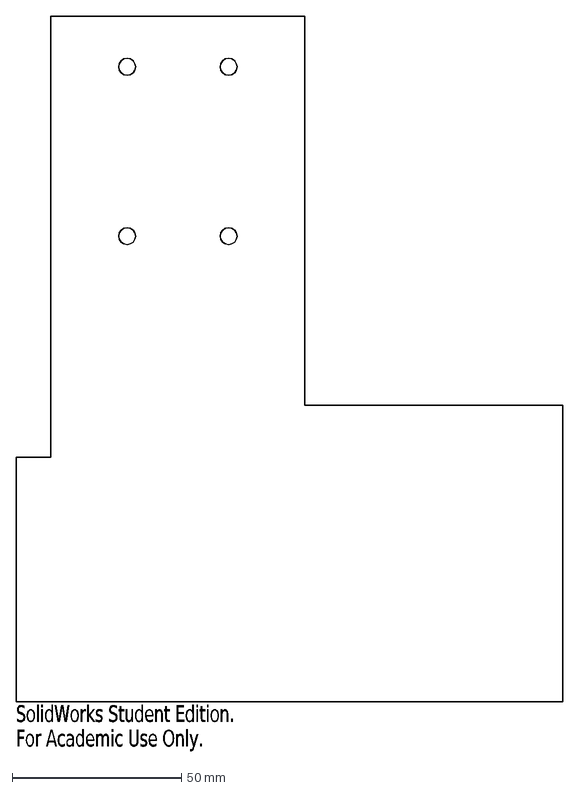
[picture p154: CAD file, 2015-07-06]
mech/DXFs/arm/Flat pattern - LBracketBack.DXF
SolidWorks Student Edition.
For Academic Use Only.
