amperes-robot/peta/mech/DXFs/chassis/Flat pattern - ChassisPlate.DXF

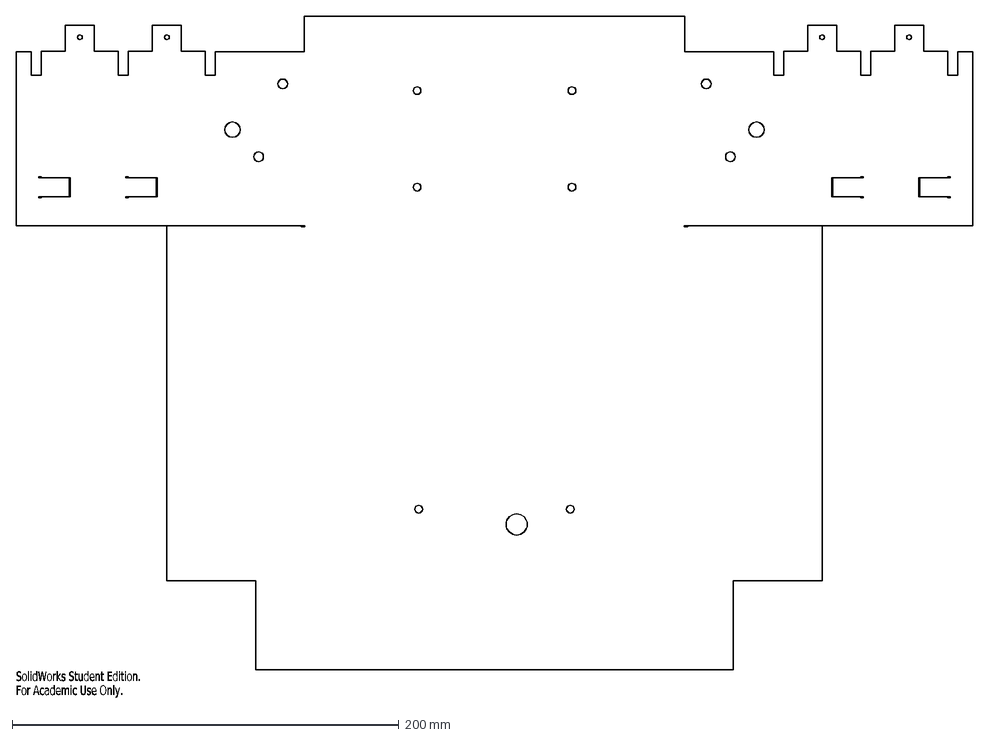
[picture p155: CAD file, 2015-06-19]
mech/DXFs/chassis/Flat pattern - ChassisPlate.DXF
SolidWorks Student Edition.
For Academic Use Only.
