amperes-robot/peta/mech/DXFs/WheelGearSolidworksWoffset.DXF

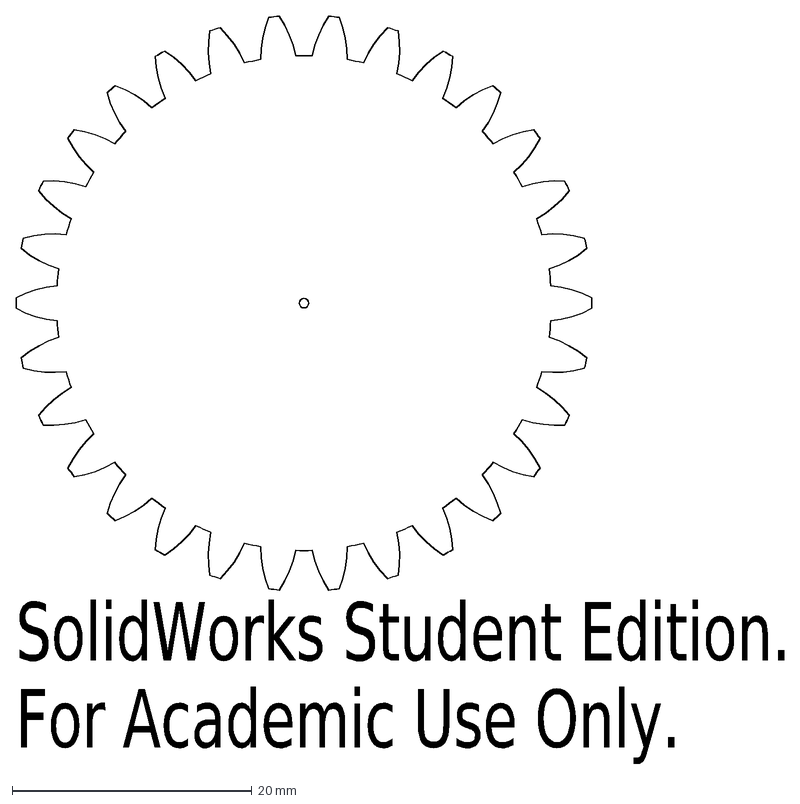
[picture p156: CAD file, 2015-07-02]
mech/DXFs/WheelGearSolidworksWoffset.DXF
SolidWorks Student Edition.
For Academic Use Only.
