amperes-robot/peta/mech/ext/meccano gear/Meccano Gear Axle.SLDPRT

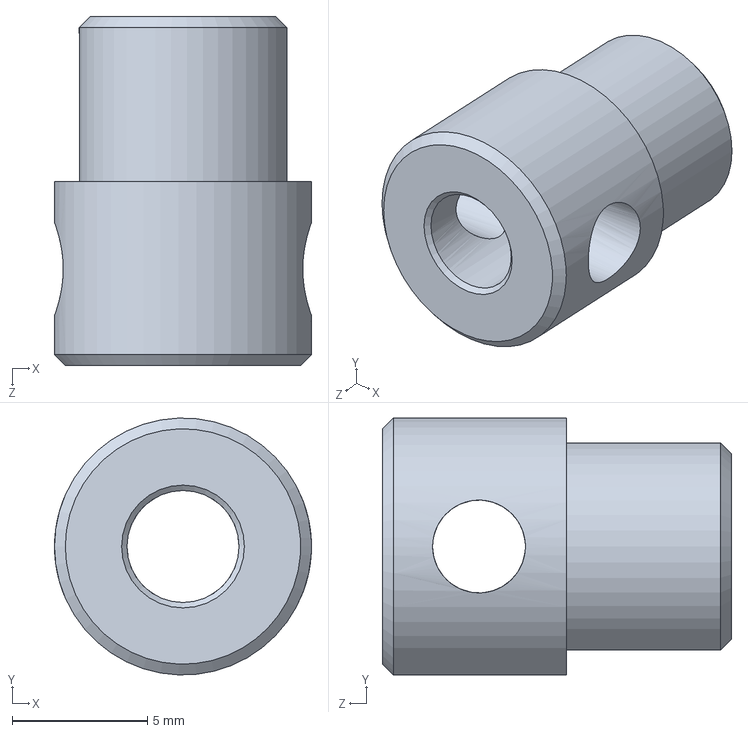
[picture p157: CAD file, 2015-06-16]
mech/ext/meccano gear/Meccano Gear Axle.SLDPRT
9.50 x 9.49 x 12.9 mm
