amperes-robot/peta/mech/ext/tire.SLDPRT

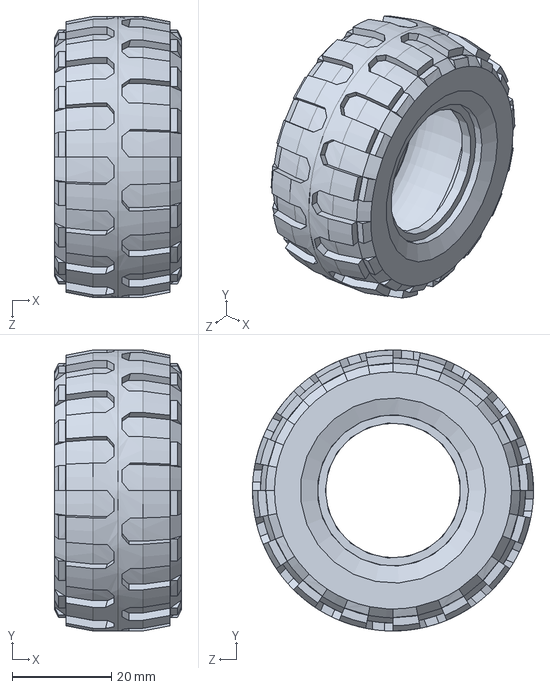
[picture p158: CAD file, 2015-06-16]
mech/ext/tire.SLDPRT
25.6 x 56.5 x 56.5 mm
