amperes-robot/peta/mech/Gears/wheel gear V2.SLDPRT

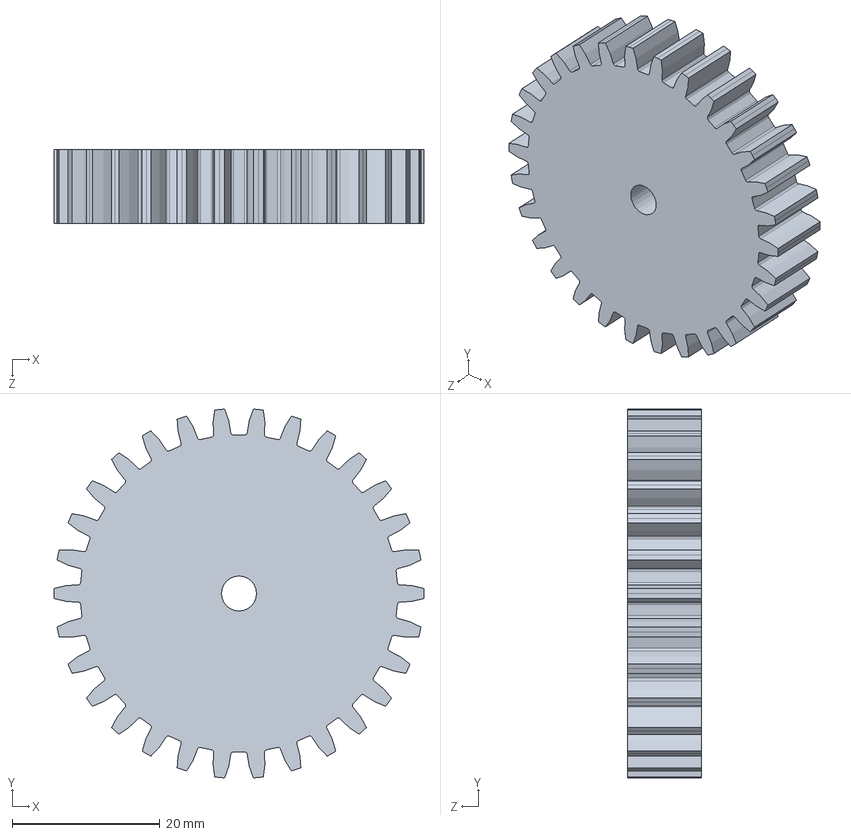
[picture p159: CAD file, 2015-06-25]
mech/Gears/wheel gear V2.SLDPRT
50.1 x 49.9 x 10.0 mm
