amperes-robot/peta/mech/petArm/pickUpArmSensorPlate.SLDPRT

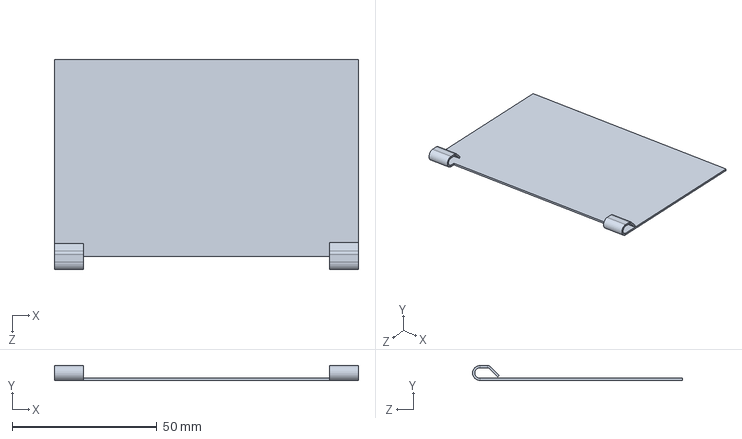
[picture p160: CAD file, 2015-07-06]
mech/petArm/pickUpArmSensorPlate.SLDPRT
105.0 x 5.12 x 72.6 mm
