amperes-robot/peta/mech/zipLine/ziplineArmGuide.SLDPRT

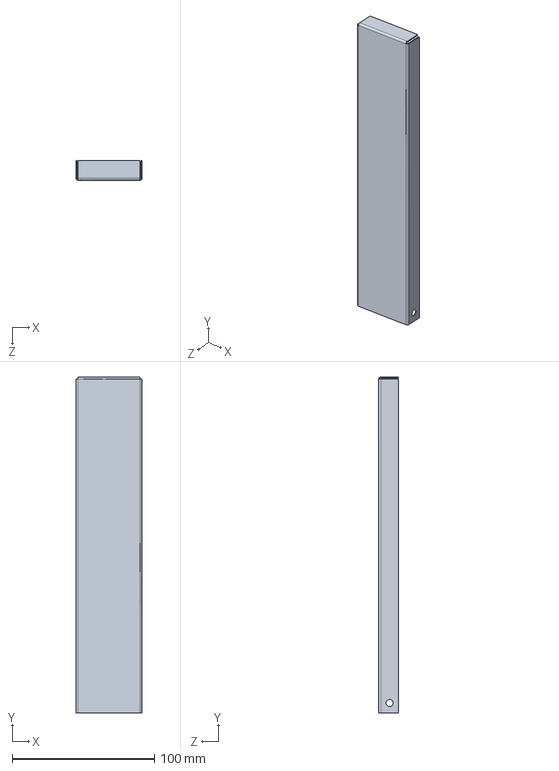
[picture p161: CAD file, 2015-07-17]
mech/zipLine/ziplineArmGuide.SLDPRT
46.6 x 235.8 x 13.8 mm
