amperes-robot/peta/mech/chassis/ChassisPlate.SLDPRT

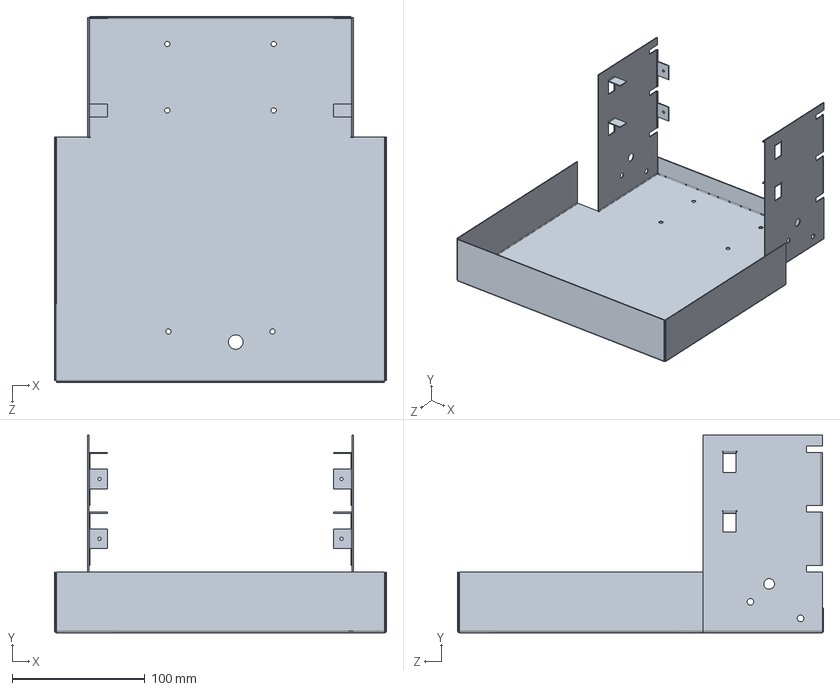
[picture p162: CAD file, 2015-06-19]
mech/chassis/ChassisPlate.SLDPRT
250.0 x 148.8 x 275.8 mm
