amperes-robot/peta/mech/DXFs/arm/Flat pattern - armBase.DXF

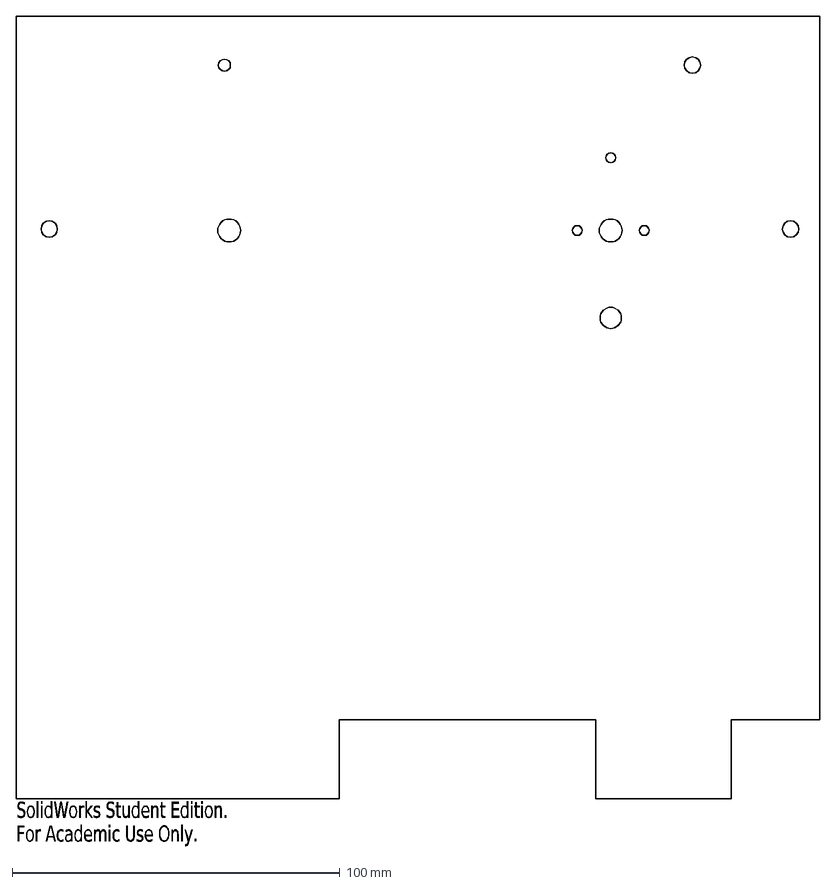
[picture p163: CAD file, 2015-07-06]
mech/DXFs/arm/Flat pattern - armBase.DXF
SolidWorks Student Edition.
For Academic Use Only.
