amperes-robot/peta/mech/DXFs/GearRetainer.DXF

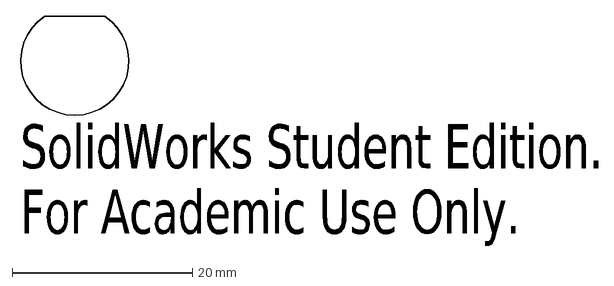
[picture p164: CAD file, 2015-06-27]
mech/DXFs/GearRetainer.DXF
SolidWorks Student Edition.
For Academic Use Only.
