amperes-robot/peta/mech/ext/Microswitch_1A_125vAC(seul).sldprt

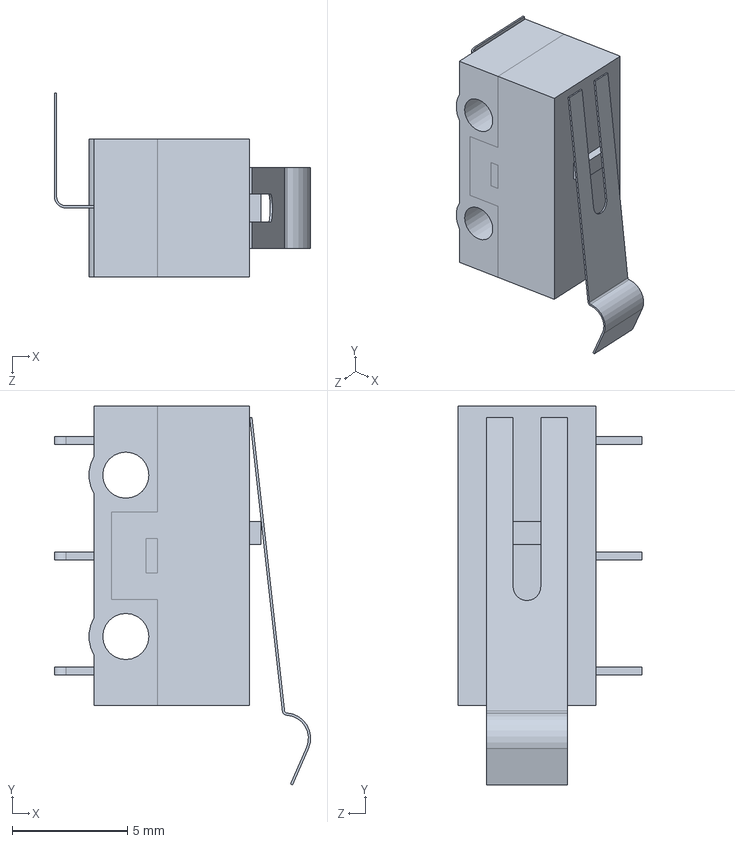
[picture p165: CAD file, 2015-06-16]
mech/ext/Microswitch_1A_125vAC(seul).sldprt
11.1 x 16.4 x 8.00 mm
