amperes-robot/peta/mech/Gears/encoder gear V2.SLDPRT

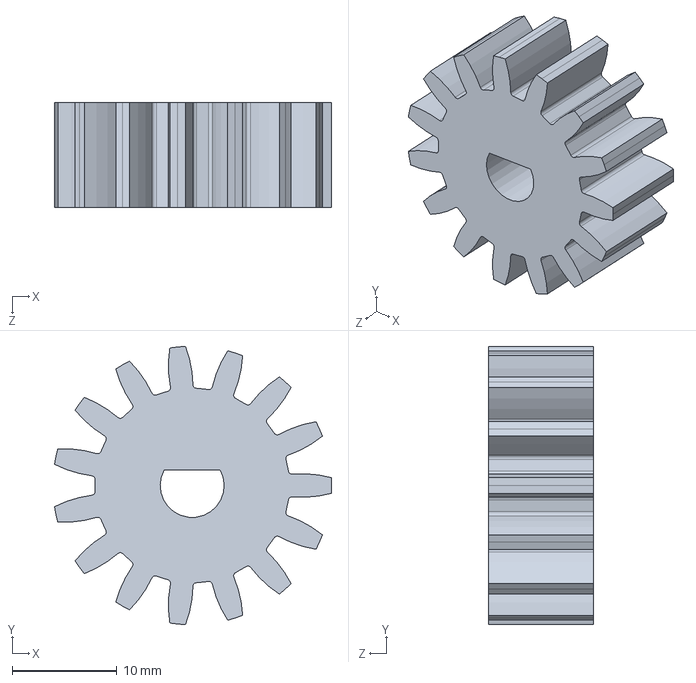
[picture p166: CAD file, 2015-06-24]
mech/Gears/encoder gear V2.SLDPRT
26.4 x 26.5 x 10.0 mm
