amperes-robot/peta/mech/petArm/LBracket.SLDPRT

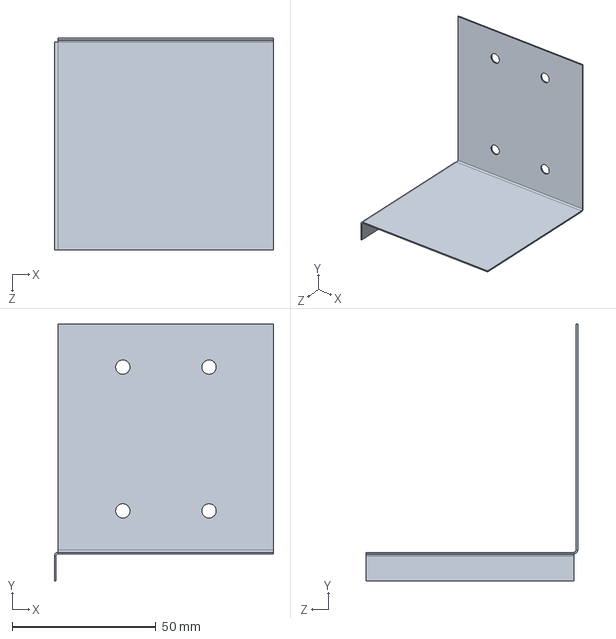
[picture p167: CAD file, 2015-07-06]
mech/petArm/LBracket.SLDPRT
76.3 x 89.4 x 73.6 mm
