amperes-robot/peta/mech/zipLine/winchAxel.SLDPRT

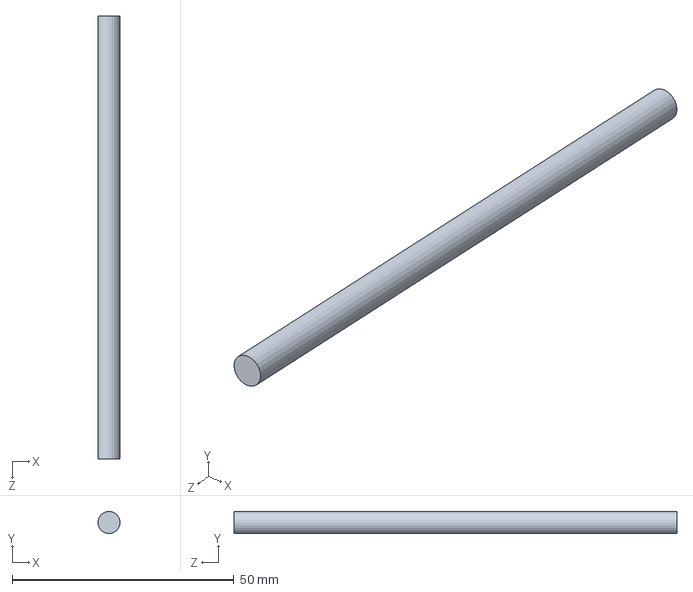
[picture p168: CAD file, 2015-07-11]
mech/zipLine/winchAxel.SLDPRT
5.00 x 5.00 x 100.0 mm
