amperes-robot/peta/mech/chassis/frontarm.SLDPRT

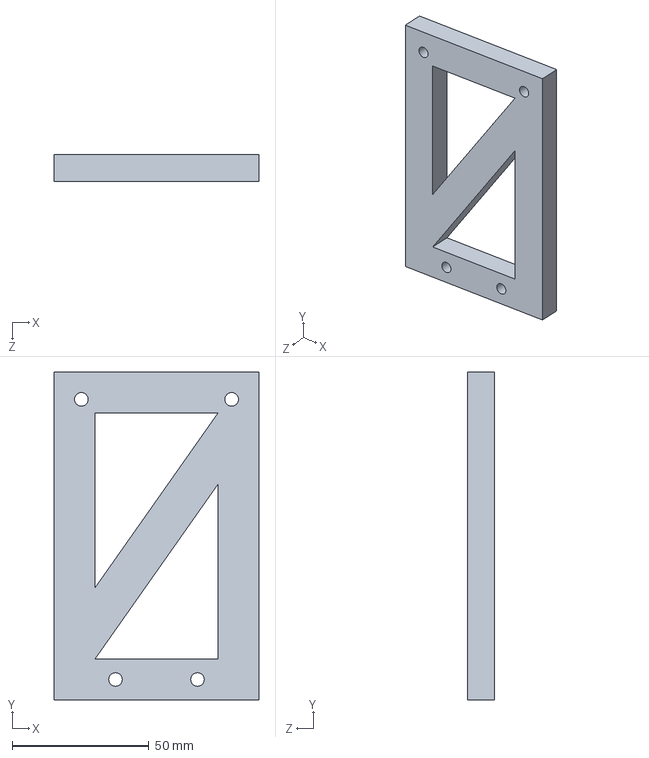
[picture p169: CAD file, 2015-06-16]
mech/chassis/frontarm.SLDPRT
75.0 x 120.0 x 10.0 mm
