amperes-robot/peta/mech/DXFs/arm/Flat pattern - ArmLongSection.DXF

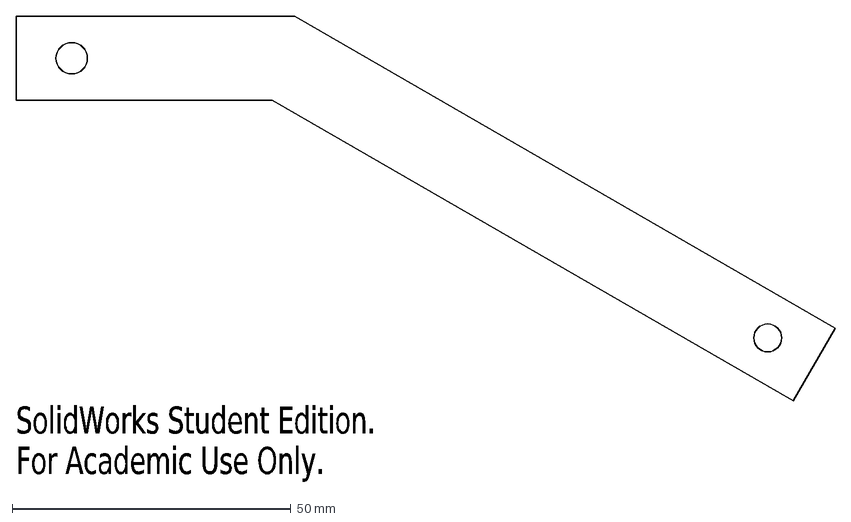
[picture p170: CAD file, 2015-07-06]
mech/DXFs/arm/Flat pattern - ArmLongSection.DXF
SolidWorks Student Edition.
For Academic Use Only.
