amperes-robot/peta/mech/DXFs/wheel gear V2.DXF

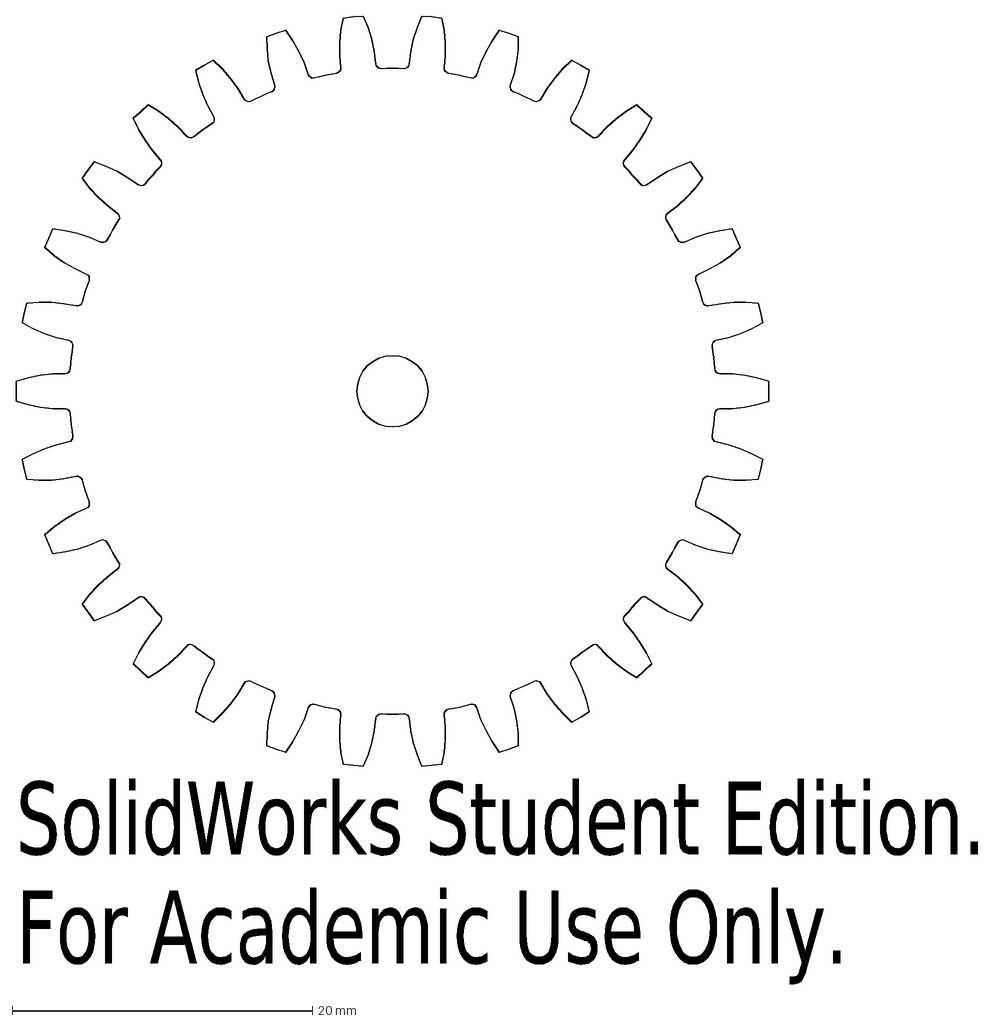
[picture p171: CAD file, 2015-06-27]
mech/DXFs/wheel gear V2.DXF
SolidWorks Student Edition.
For Academic Use Only.
