amperes-robot/peta/mech/ext/pop rivet.SLDPRT

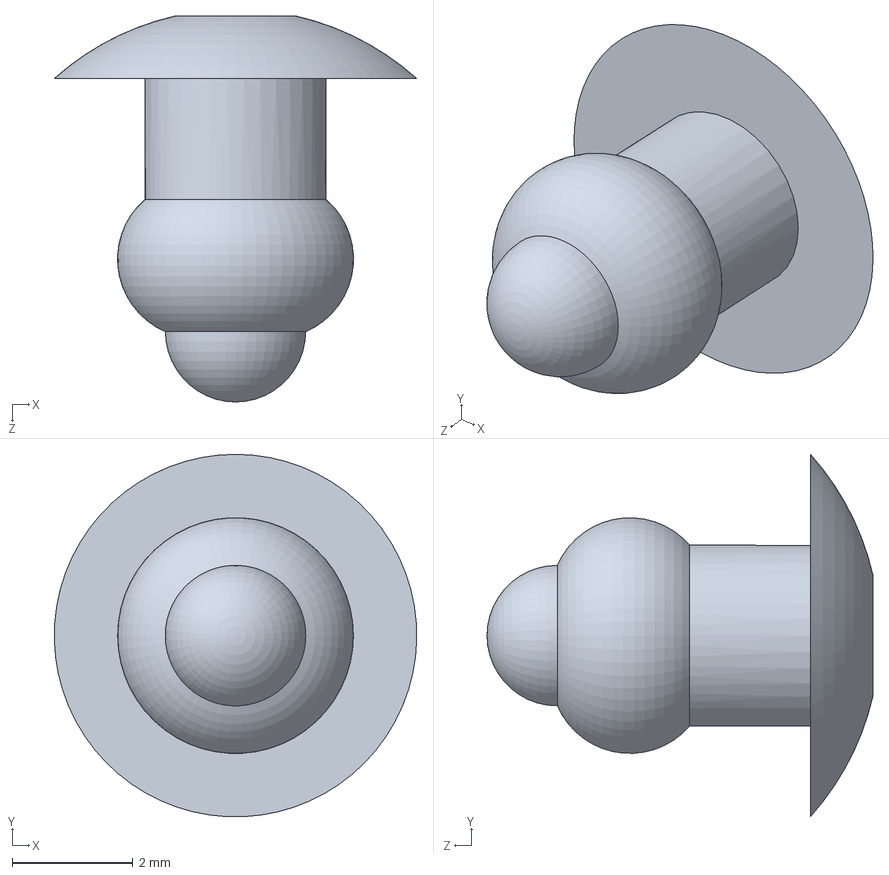
[picture p172: CAD file, 2015-06-16]
mech/ext/pop rivet.SLDPRT
6.00 x 6.00 x 6.39 mm
