amperes-robot/peta/mech/Gears/motorDriveGear V2.SLDPRT

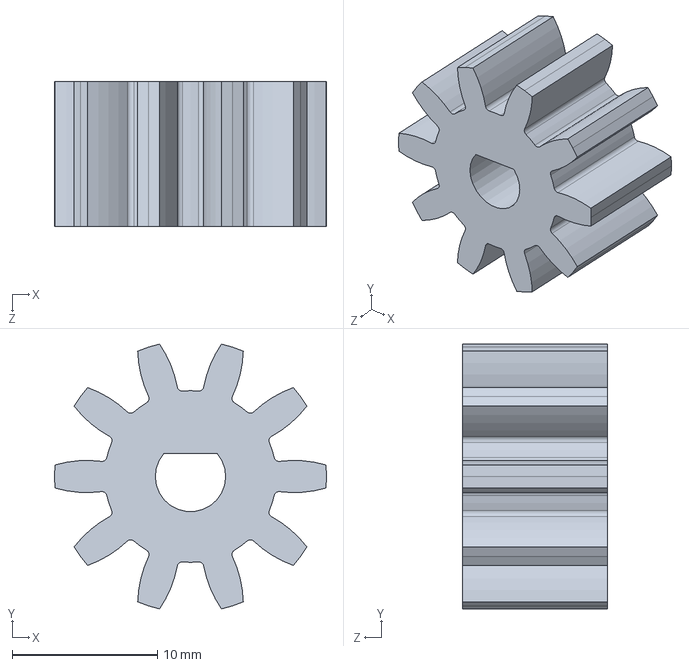
[picture p173: CAD file, 2015-06-24]
mech/Gears/motorDriveGear V2.SLDPRT
18.8 x 18.3 x 10.0 mm
