amperes-robot/peta/mech/petArm/GearArmV2.SLDPRT

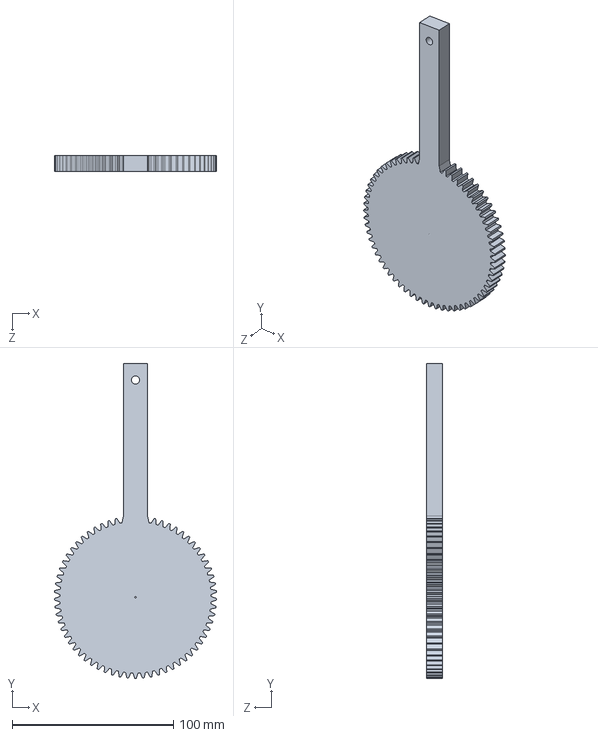
[picture p174: CAD file, 2015-07-02]
mech/petArm/GearArmV2.SLDPRT
100.5 x 195.1 x 10.0 mm
