amperes-robot/peta/mech/zipLine/winchBody.SLDPRT

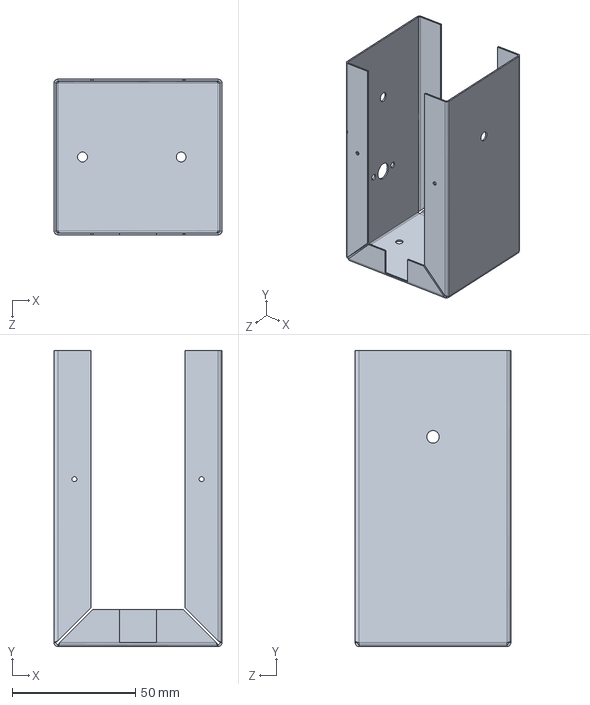
[picture p175: CAD file, 2015-07-11]
mech/zipLine/winchBody.SLDPRT
68.1 x 120.0 x 63.1 mm
