amperes-robot/peta/mech/DXFs/arm/GearArmV2.DXF

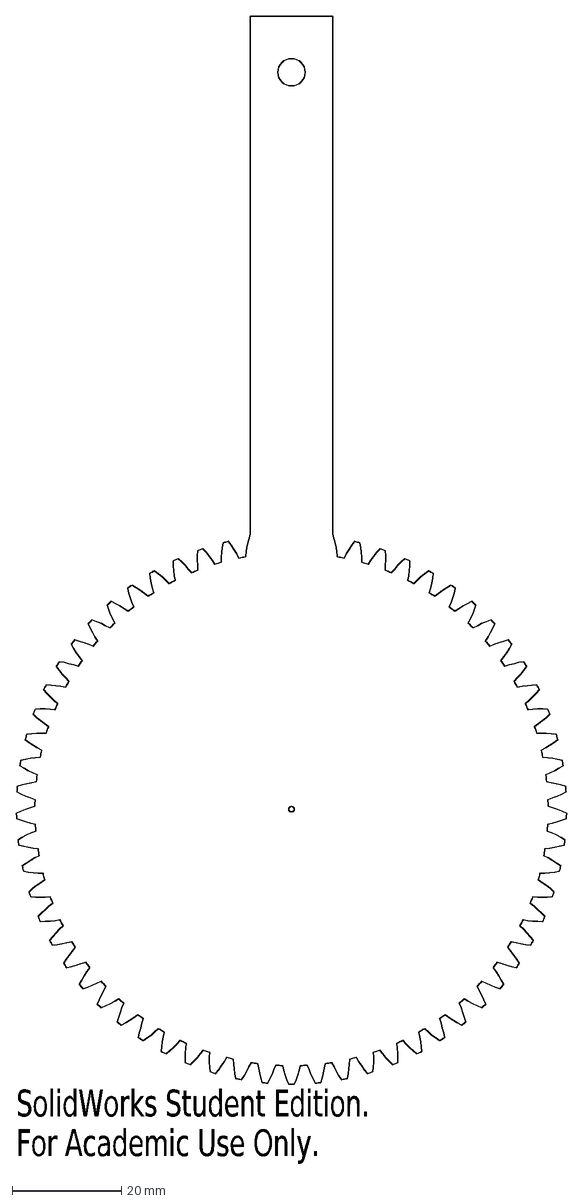
[picture p176: CAD file, 2015-07-06]
mech/DXFs/arm/GearArmV2.DXF
SolidWorks Student Edition.
For Academic Use Only.
