amperes-robot/peta/mech/DXFs/encoder gear V2.DXF

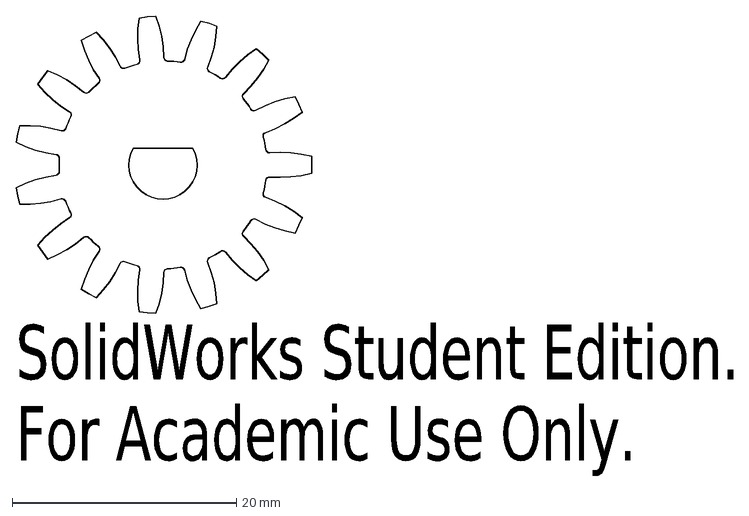
[picture p177: CAD file, 2015-06-24]
mech/DXFs/encoder gear V2.DXF
SolidWorks Student Edition.
For Academic Use Only.
