amperes-robot/peta/mech/ext/Meccano Worm.SLDPRT

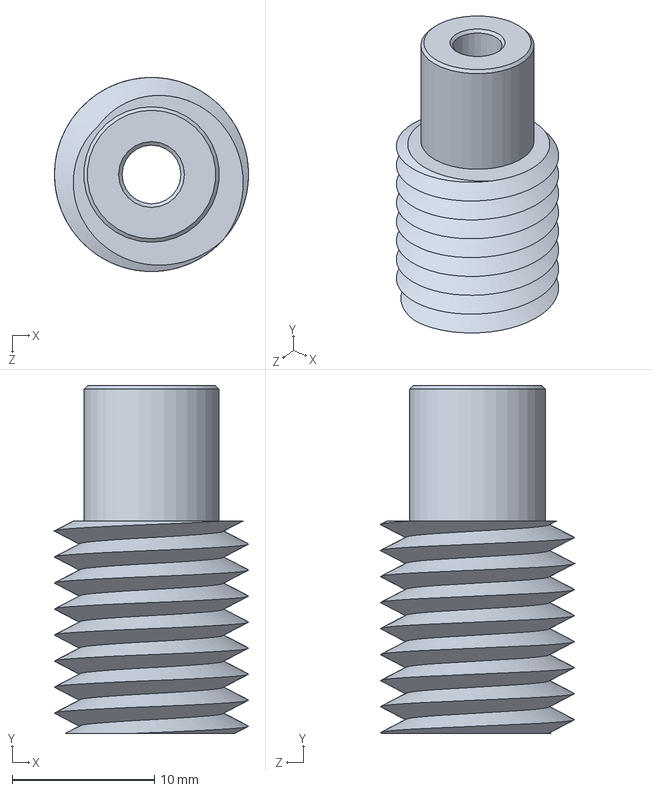
[picture p178: CAD file, 2015-06-16]
mech/ext/Meccano Worm.SLDPRT
13.6 x 24.5 x 13.6 mm
