amperes-robot/peta/mech/petArm/boxPetSensePlate.SLDPRT

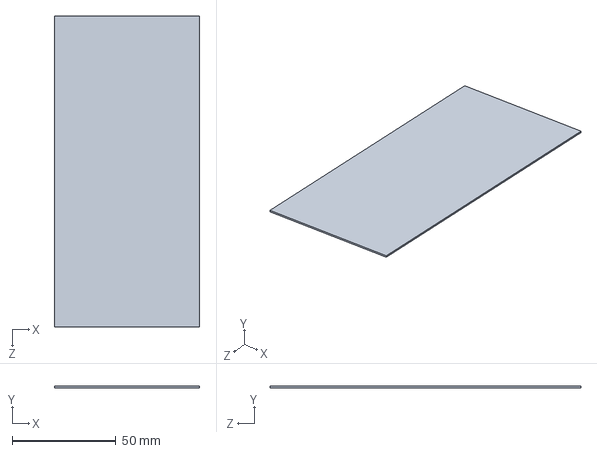
[picture p179: CAD file, 2015-06-17]
mech/petArm/boxPetSensePlate.SLDPRT
70.0 x 0.81 x 150.0 mm
