amperes-robot/peta/mech/zipLine/winchCover.SLDPRT

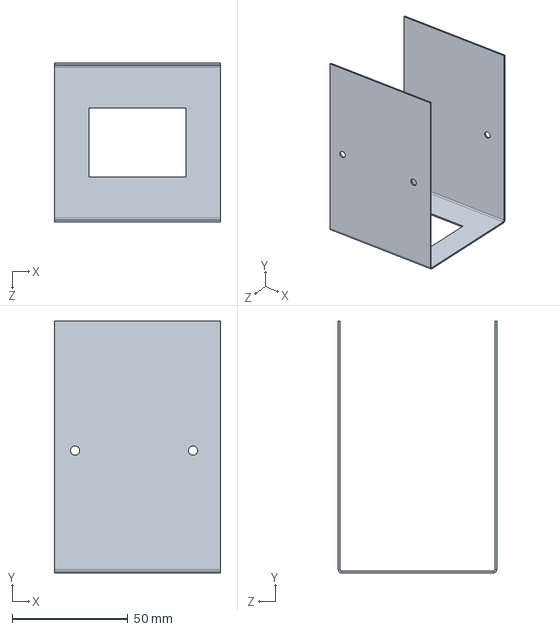
[picture p180: CAD file, 2015-07-11]
mech/zipLine/winchCover.SLDPRT
72.0 x 109.0 x 68.6 mm
