amperes-robot/peta/mech/DXFs/arm/Flat pattern - armBracket.DXF

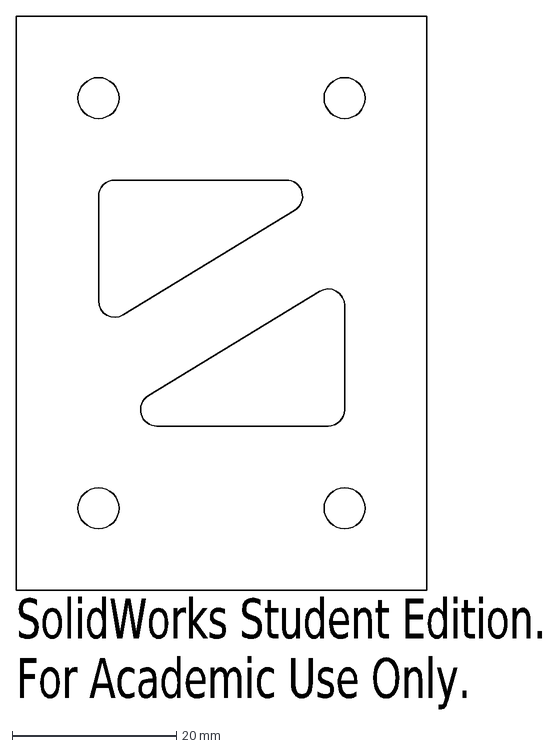
[picture p181: CAD file, 2015-07-06]
mech/DXFs/arm/Flat pattern - armBracket.DXF
SolidWorks Student Edition.
For Academic Use Only.
