amperes-robot/peta/mech/DXFs/motorDriveGear V2.DXF

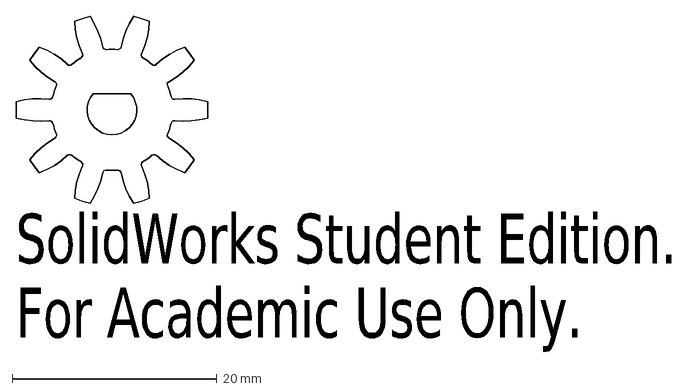
[picture p182: CAD file, 2015-06-24]
mech/DXFs/motorDriveGear V2.DXF
SolidWorks Student Edition.
For Academic Use Only.
