amperes-robot/peta/mech/ext/battery NiMH.SLDPRT

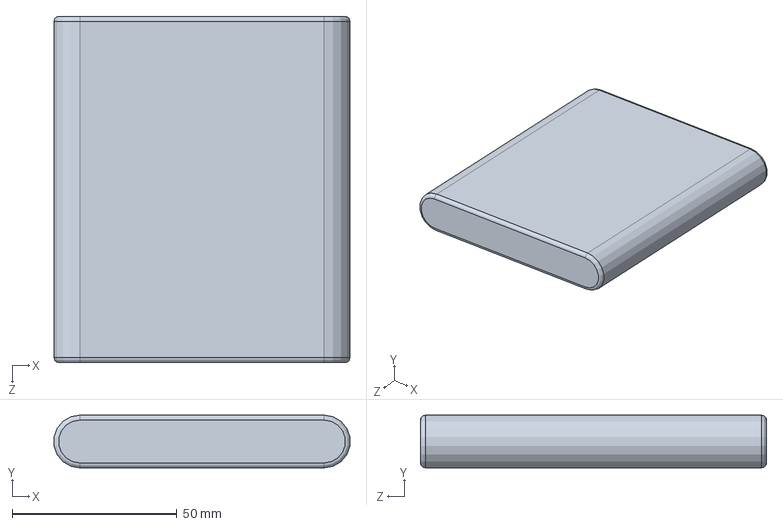
[picture p183: CAD file, 2015-06-10]
mech/ext/battery NiMH.SLDPRT
89.8 x 16.0 x 105.0 mm
