amperes-robot/peta/mech/petArm/ArmLongGear.SLDPRT

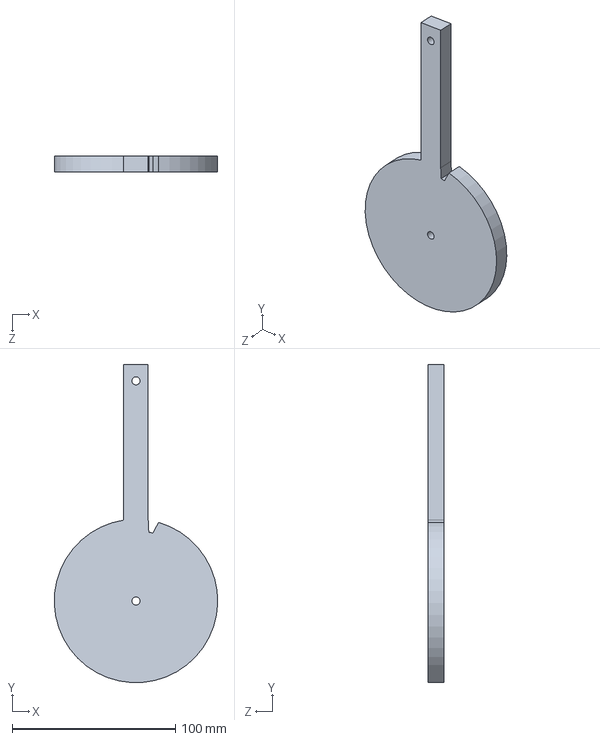
[picture p184: CAD file, 2015-06-16]
mech/petArm/ArmLongGear.SLDPRT
99.9 x 194.5 x 10.0 mm
