amperes-robot/peta/mech/zipLine/winchGearedMotor.SLDPRT

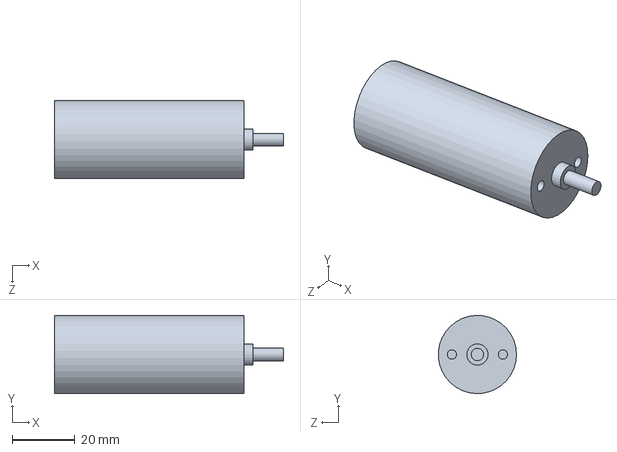
[picture p185: CAD file, 2015-07-11]
mech/zipLine/winchGearedMotor.SLDPRT
73.2 x 25.0 x 24.9 mm
