amperes-robot/peta/mech/ext/Tinah Board representation.SLDPRT

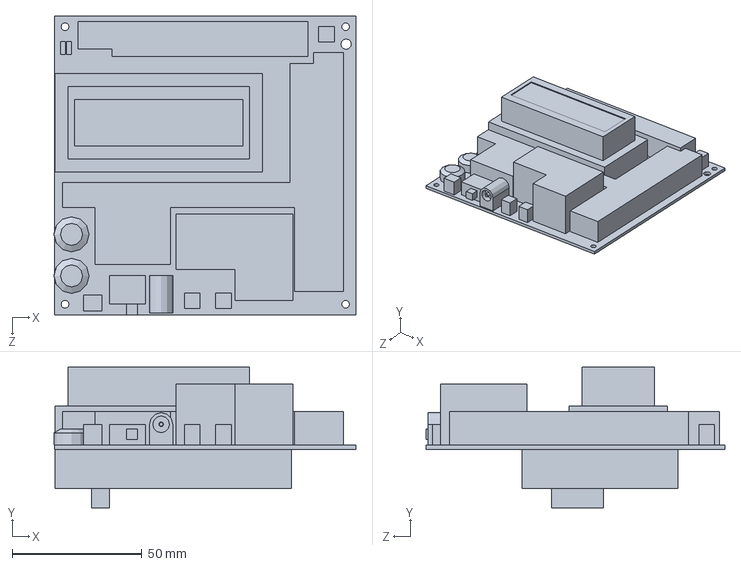
[picture p186: CAD file, 2015-06-10]
mech/ext/Tinah Board representation.SLDPRT
116.2 x 54.2 x 115.0 mm
