amperes-robot/peta/mech/petArm/pickUpArmAxel.SLDPRT

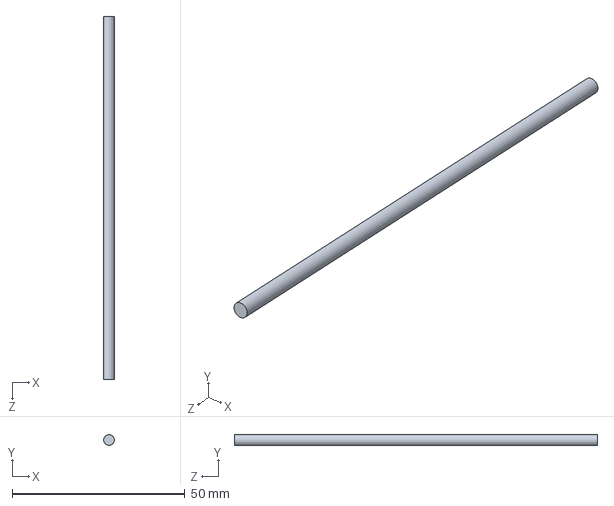
[picture p187: CAD file, 2015-06-16]
mech/petArm/pickUpArmAxel.SLDPRT
3.10 x 3.10 x 105.0 mm
