amperes-robot/peta/mech/zipLine/winchReel.SLDPRT

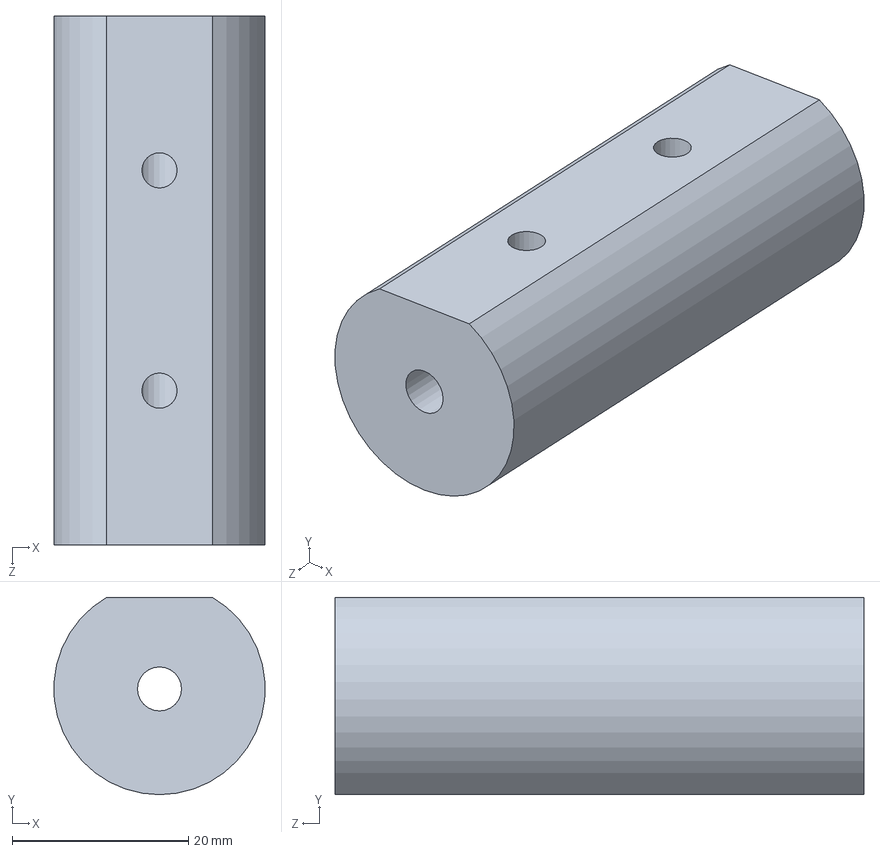
[picture p188: CAD file, 2015-07-11]
mech/zipLine/winchReel.SLDPRT
23.9 x 22.4 x 60.0 mm
