amperes-robot/peta/mech/ext/Motor Barber Coleman geared.SLDPRT

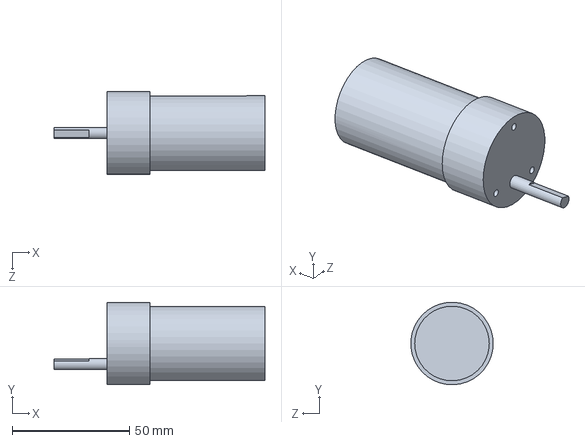
[picture p189: CAD file, 2015-06-03]
mech/ext/Motor Barber Coleman geared.SLDPRT
89.9 x 35.1 x 35.1 mm
