amperes-robot/peta/mech/petArm/armRod.SLDPRT

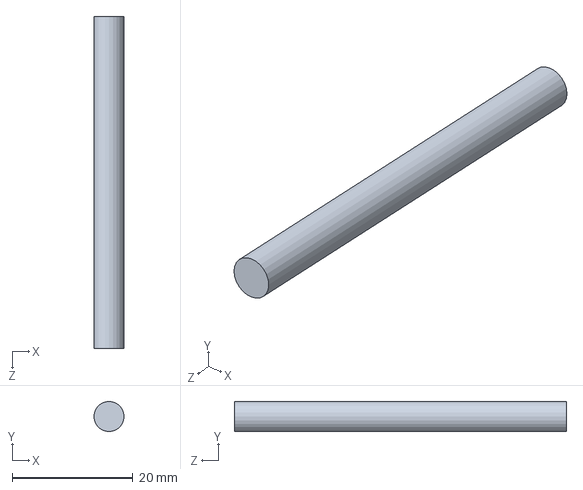
[picture p190: CAD file, 2015-06-16]
mech/petArm/armRod.SLDPRT
5.00 x 5.00 x 55.0 mm
