amperes-robot/peta/mech/zipLine/ziplineWinchBracket.SLDPRT

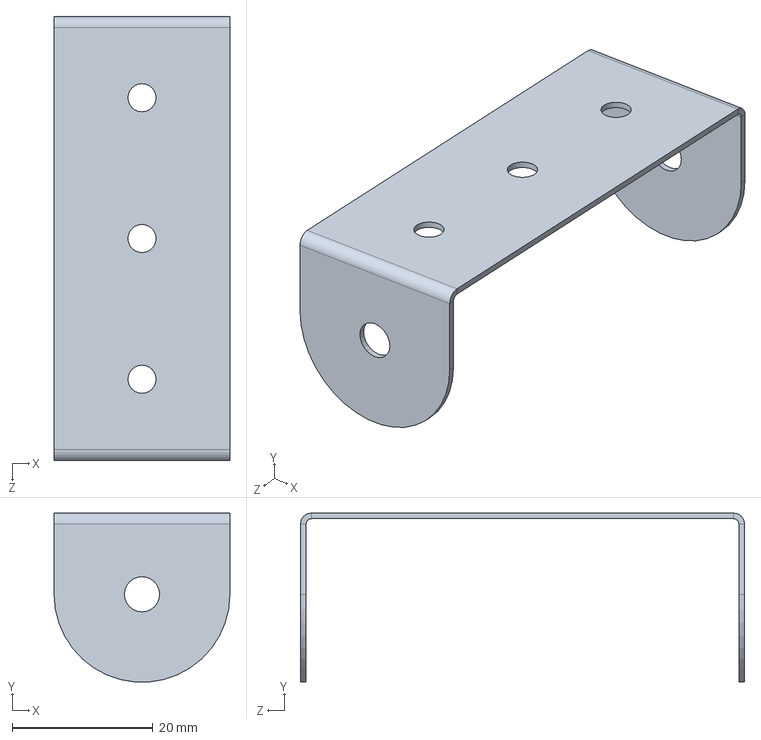
[picture p191: CAD file, 2015-07-09]
mech/zipLine/ziplineWinchBracket.SLDPRT
25.0 x 24.0 x 63.1 mm
