amperes-robot/peta/mech/ext/axle_4.SLDPRT

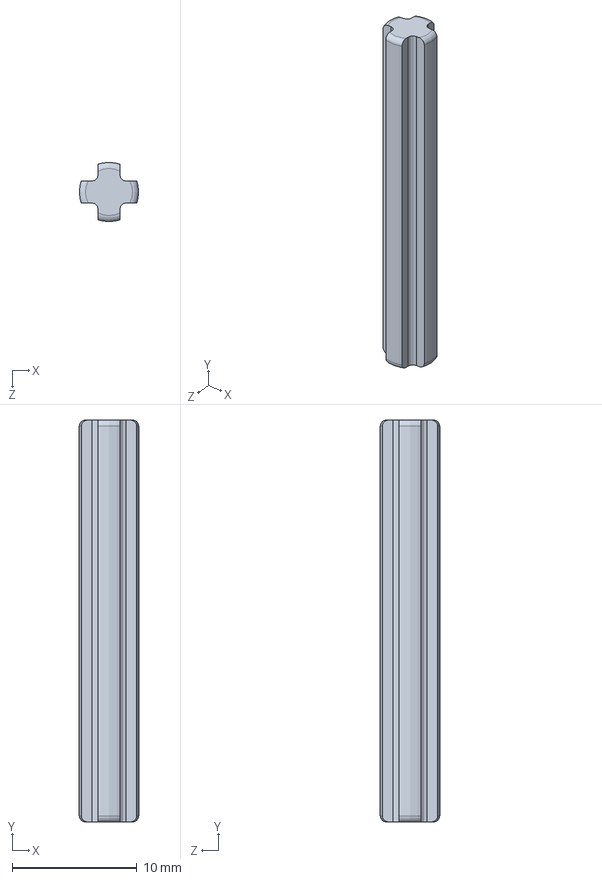
[picture p192: CAD file, 2015-06-03]
mech/ext/axle_4.SLDPRT
4.78 x 32.3 x 4.78 mm
