amperes-robot/peta/mech/petArm/knockOffTool.SLDPRT

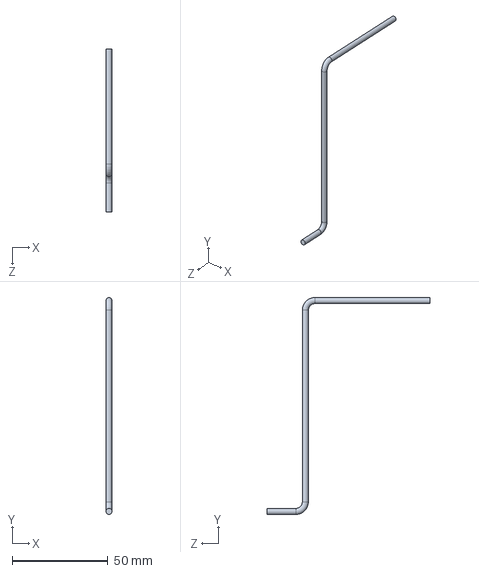
[picture p193: CAD file, 2015-06-16]
mech/petArm/knockOffTool.SLDPRT
3.20 x 113.2 x 85.0 mm
