amperes-robot/peta/mech/zipLine/ziplineCBracket.SLDPRT

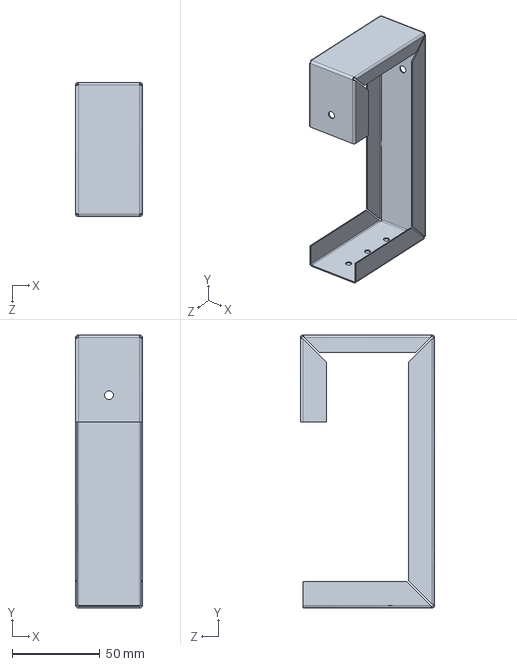
[picture p194: CAD file, 2015-07-09]
mech/zipLine/ziplineCBracket.SLDPRT
38.1 x 155.5 x 76.5 mm
