amperes-robot/peta/mech/zipLine/ziplineRoller.SLDPRT

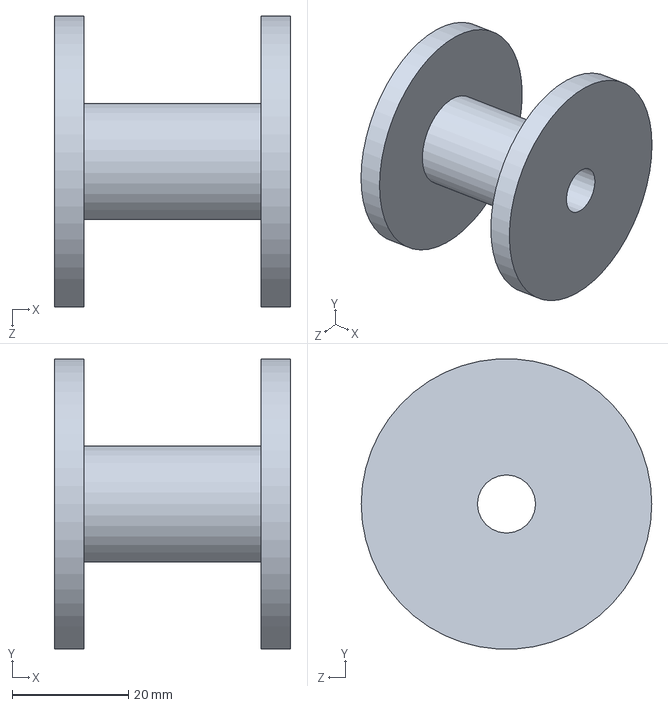
[picture p195: CAD file, 2015-06-24]
mech/zipLine/ziplineRoller.SLDPRT
40.6 x 49.9 x 50.0 mm
