amperes-robot/peta/mech/zipLine/ziplineAxel.SLDPRT

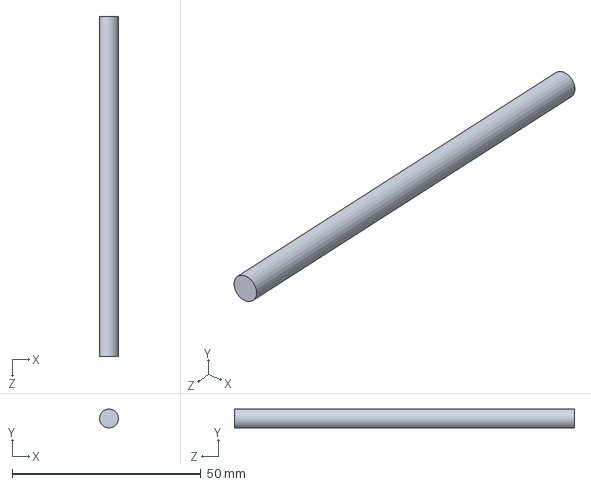
[picture p196: CAD file, 2015-06-16]
mech/zipLine/ziplineAxel.SLDPRT
5.00 x 5.00 x 90.0 mm
