amperes-robot/peta/mech/zipLine/ziplineZipperAxel.SLDPRT

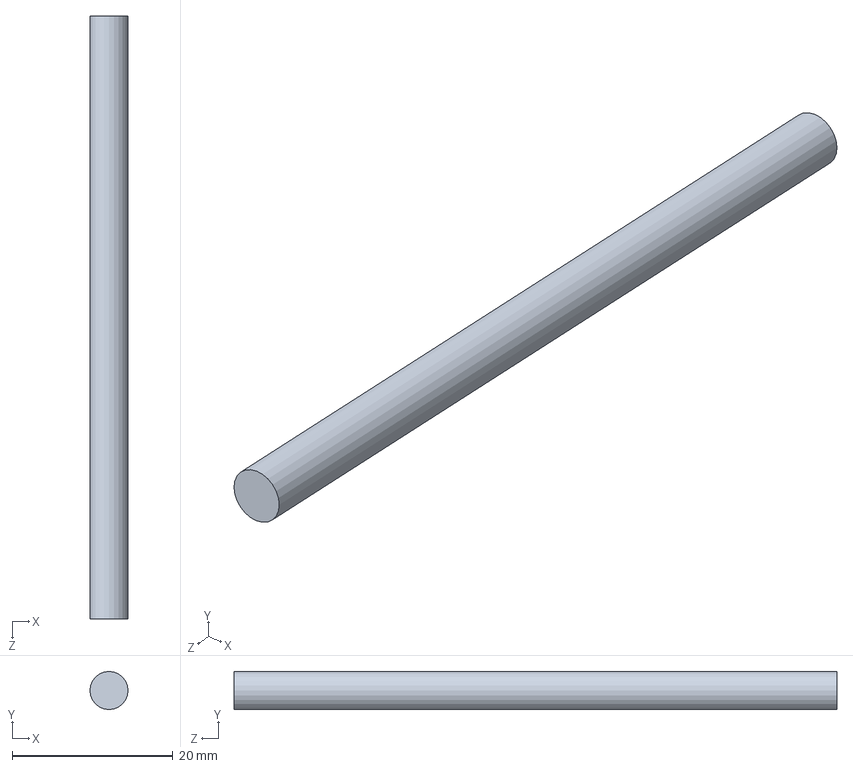
[picture p197: CAD file, 2015-06-16]
mech/zipLine/ziplineZipperAxel.SLDPRT
4.75 x 4.75 x 75.0 mm
