amperes-robot/peta/mech/zipLine/armGear2.SLDPRT

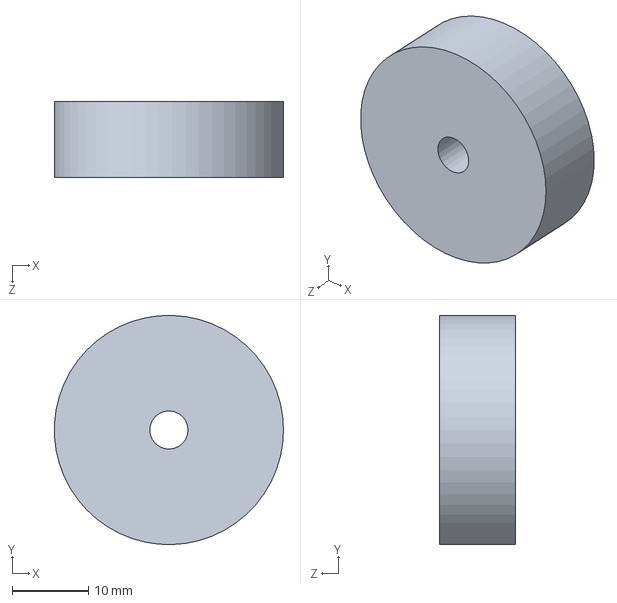
[picture p198: CAD file, 2015-06-12]
mech/zipLine/armGear2.SLDPRT
30.0 x 30.0 x 10.0 mm
