amperes-robot/peta/mech/zipLine/armGear.SLDPRT

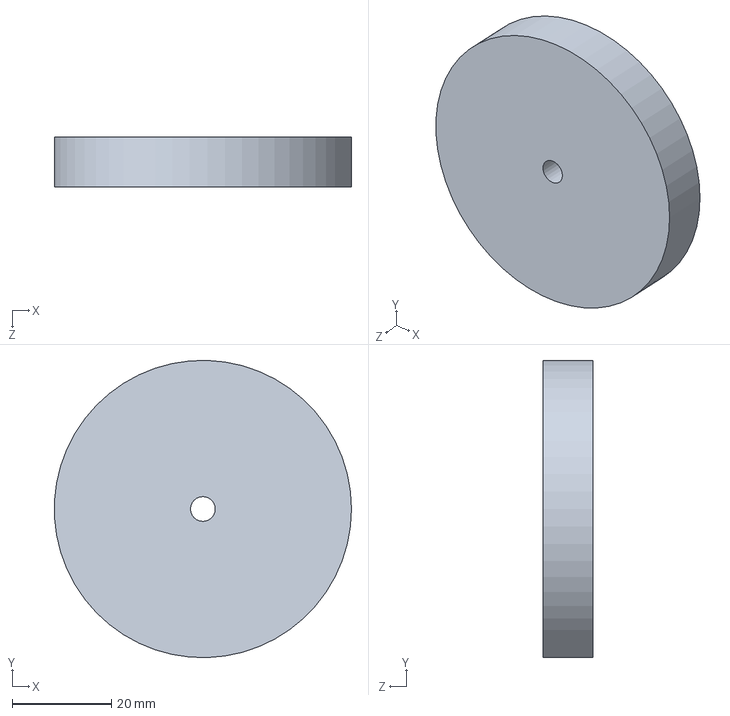
[picture p199: CAD file, 2015-06-12]
mech/zipLine/armGear.SLDPRT
59.9 x 60.0 x 10.0 mm
