amperes-robot/peta/(list of files, cad)

Other CAD files:
mech/ext/QRD/emisorqrd.SLDPRT
mech/DXFs/Zipline/ZiplineSupport.DXF
mech/DXFs/Zipline/ziplineArmGuide.DXF
mech/boxArm/boxArm.SLDPRT
mech/chassis/Sled.SLDPRT
