amperes-robot/peta/elec/QRD.brd

## EAGLE design elec/QRD.brd (2015-08-01)

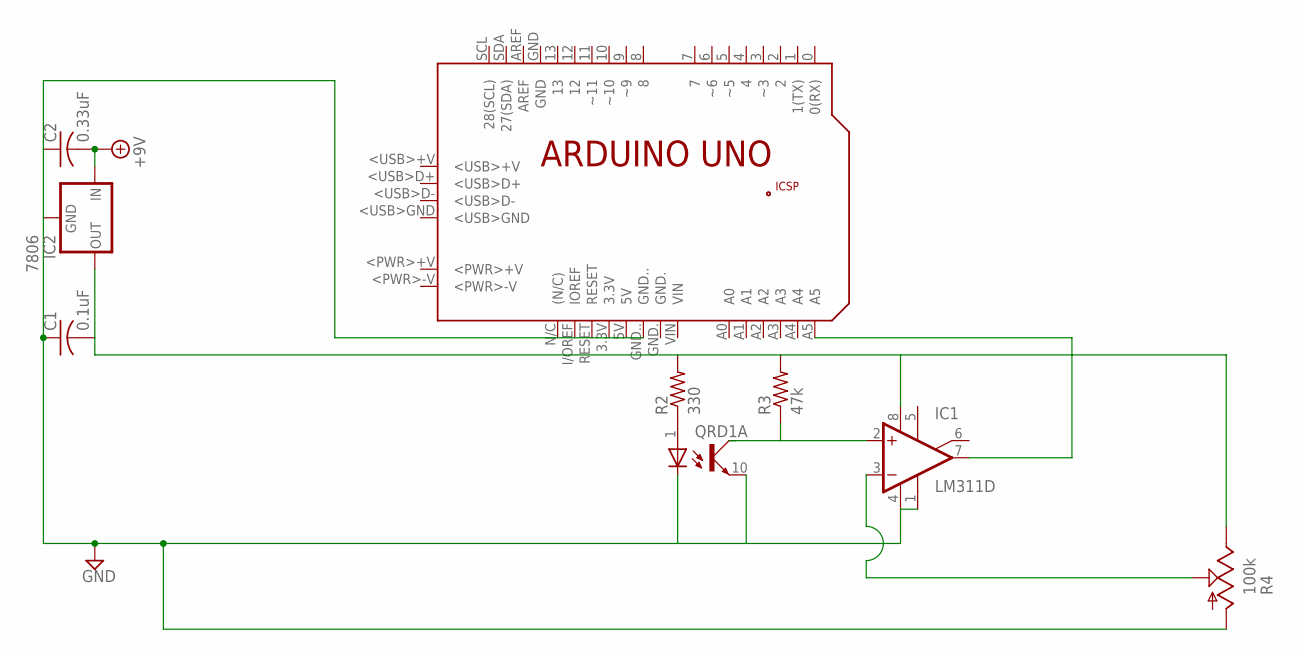
[picture p200: schematic QRD.sch]

Parts:
C1: 0.1uF; C025-024X044
C2: 0.33uF; C025-024X044
IC1: LM311D; SO08
IC2: 7806; 78XXL
PCB1: ARDUINO_UNO
QRD1: SFH6943; SOT223/10
R2: 330; 0204V
R3: 47k; 0204V
R4: 100k; 3223G

Connections:
+9V: C2.2, IC2.IN
GND: C1.1, C2.1, IC1.1 (GND), IC1.4 (V-), IC2.GND, PCB1.GND.., QRD1.10 (EMI), R4.1 (A)
unnamed: IC1.7 (OUT), PCB1.A5
unnamed: QRD1.1 (A), R2.1
unnamed: IC1.3 (-IN), R4.2 (S)
unnamed: IC1.2 (+IN), R3.1
unnamed: C1.2, IC1.8 (V+), IC2.OUT, R2.2, R3.2, R4.3 (E)

Board: 2 copper layers, 9 parts (2 on the bottom side), 7 nets, no tracks yet.
