amperes-robot/peta/sw/motion.h

#pragma once
#include "io.h"

namespace motion
{
	struct Motor final
	{
		public:
			Motor(uint8_t id, uint8_t reverse);
			int16_t speed(int16_t amt);
			inline int16_t speed() const
			{
				return _speed;
			}
			inline int8_t dir() const
			{
				return _speed > 0 ? 1 : -1;
			}
			void halt();
		private:
			const uint8_t _id, _rev;
			int16_t _speed;
	};

	void init();

	/*
	 * Move in a direction, with -255 being right, 255 being left.
	 */
	void dir(int16_t x);

	/*
	 * Speed.
	 */
	void vel(int16_t x);

	/**
	 * Update encoder state.
	 */
	void enc0();
	void enc1();
	void update_enc();

	extern Motor left;
	extern Motor right;
	extern Motor arm;
	extern Motor excavator;
	extern Motor* const motors[4];

	extern volatile uint32_t x;
	extern volatile uint32_t y;
	extern volatile uint16_t theta;

	extern volatile int16_t left_theta;
	extern volatile int16_t right_theta;
	extern volatile int16_t arm_theta;
	extern volatile int16_t excavator_theta;
}
