amperes-robot/peta/sw/strings.cpp

#include "strings.h"

namespace strings
{
	DEFN_FSTR(course);
	DEFN_FSTR(course_short);
	DEFN_FSTR(reset);
	DEFN_FSTR(opt);
	DEFN_FSTR(opt_restore);
	DEFN_FSTR(follow);
	DEFN_FSTR(dbg);

	DEFN_FSTR(flw_p);
	DEFN_FSTR(flw_i);
	DEFN_FSTR(flw_d);
	DEFN_FSTR(flw_vel);
	DEFN_FSTR(flw_thresh_left);
	DEFN_FSTR(flw_thresh_side);
	DEFN_FSTR(flw_thresh_right);
	DEFN_FSTR(flw_recover);
	DEFN_FSTR(flw_drecover);

	DEFN_FSTR(home_p);
	DEFN_FSTR(home_i);
	DEFN_FSTR(home_d);
	DEFN_FSTR(home_thresh);
	DEFN_FSTR(home_vel);

	DEFN_FSTR(beacon_thresh);
	DEFN_FSTR(beacon_theta);

	DEFN_FSTR(home);
	DEFN_FSTR(retrieval);
	DEFN_FSTR(view);
	DEFN_FSTR(ppark);

	DEFN_FSTR(courseid);
	DEFN_FSTR(el_theta);
}
