amperes-robot/peta/sw/math.cpp

#include "math.h"
#include <avr/pgmspace.h>

namespace math
{
	namespace
	{
		const uint8_t SINETABLE_SIZE = 128;
		const PROGMEM int16_t sinetable[] =
		{
			0,
			402,
			804,
			1206,
			1608,
			2009,
			2411,
			2811,
			3212,
			3612,
			4011,
			4410,
			4808,
			5205,
			5602,
			5998,
			6393,
			6787,
			7180,
			7571,
			7962,
			8351,
			8740,
			9127,
			9512,
			9896,
			10279,
			10660,
			11039,
			11417,
			11793,
			12167,
			12540,
			12910,
			13279,
			13646,
			14010,
			14373,
			14733,
			15091,
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
		};
	}

	int16_t sin(uint16_t theta)
	{
		uint8_t sign = 0;

		if (theta > pi)
		{
			theta -= pi;
			sign = 1;
		}
		if (theta > pi / 2)
		{
			theta = pi - theta;
		}

		uint8_t ind = (uint8_t) ((uint32_t) theta * SINETABLE_SIZE * 2 / pi);
		uint16_t r;
		if (ind == SINETABLE_SIZE - 1)
		{
			r = sinetable[SINETABLE_SIZE - 1];
		}
		else
		{
			uint16_t lower = pgm_read_word(sinetable + ind);
			uint16_t upper = pgm_read_word(sinetable + ind + 1);

			r = lower + (upper - lower) * (theta % (pi / 2 / SINETABLE_SIZE)) / (pi / 2 / SINETABLE_SIZE);
		}

		return sign ? -r : r;
	}

	int16_t cos(uint16_t theta)
	{
		return sin(theta + pi / 2);
	}
}
