amperes-robot/peta/(commit log)

2015-05-13 more framework stuff
2015-05-14 updated framework
2015-05-14 added enph253 lib (but it doesn't compile)
    [io.h, main.cpp]
2015-05-27 remove test cpp file, add pid framework
2015-06-03 motor file
    [Motor Barber Coleman geared.SLDPRT]
2015-06-03 chassis and rear wheel solidworks stuff
    [AxelMotorBracket.SLDPRT, ChassisPlate.SLDPRT, Motor Barber Coleman geared.SLDPRT, RobotAssy.SLDASM, axle.SLDPRT, axle_4.SLDPRT, hub.SLDPRT, tire.SLDPRT]
2015-06-04 move wheels in
    [RobotAssy.SLDASM]
2015-06-09 arm and chissis mods
    [ArmLongSection.SLDPRT, ArmShortSection.SLDPRT, ChassisPlate.SLDPRT, LBracket.SLDPRT, RobotAssy.SLDASM, armAssy.SLDASM, armGear.SLDPRT, armRod.SLDPRT]
2015-06-09 end of day june 8
    [ChassisPlate.SLDPRT, PetBox.SLDPRT, RobotAssy.SLDASM, armAssy.SLDASM, armBase.SLDPRT, armTempHolderPlate.SLDPRT]
2015-06-09 played with some geometry
    [ArmLongSection.SLDPRT, ArmShortSection.SLDPRT, ChassisPlate.SLDPRT, RobotAssy.SLDASM, armAssy.SLDASM, armBase.SLDPRT, armGear.SLDPRT, armTempHolderPlate.SLDPRT]
2015-06-09 part mods
    [LBracket.SLDPRT, RobotAssy.SLDASM, armAssy.SLDASM, armTempHolderPlate.SLDPRT]
2015-06-10 june 09 2015
    [ChassisPlate.SLDPRT, RobotAssy.SLDASM, Tinah Board representation.SLDPRT, armAssy.SLDASM, battery NiMH.SLDPRT, boadBackPanel.SLDPRT, boardTray.SLDPRT, robot shop wheel 69mm diam.SLDPRT]
2015-06-10 more interrupts and raw analog reading
2015-06-10 removed testing framework (kind of useless)
2015-06-11 a bunch of arm stuff June10th
    [ArmLongGear.SLDPRT, ArmLongSection.SLDPRT, LBracket.SLDPRT, RobotAssy.SLDASM, ZiplineSupport.SLDPRT, armAssy.SLDASM, armBase.SLDPRT, armBracket.SLDPRT]
2015-06-11 add sled
    [RobotAssy.SLDASM, Sled.SLDPRT, armAssy.SLDASM, sledBracket.SLDPRT, ziplineAssy.SLDASM]
2015-06-11 make chassis assembly to clean up main assembly
    [RobotAssy.SLDASM, Sled.SLDPRT, chassisAssy.SLDASM]
2015-06-11 adc interrupt
2015-06-12 add tinah mount and pet removal tool
    [ChassisPlate.SLDPRT, LiPoBattery.SLDPRT, RobotAssy.SLDASM, armAssy.SLDASM, armBase.SLDPRT, armBracket.SLDPRT, armRod.SLDPRT, boadBackPanel.SLDPRT]
2015-06-12 front arm for pet 4 and random mods
    [ArmLongGear.SLDPRT, ArmLongSection.SLDPRT, LBracket.SLDPRT, RobotAssy.SLDASM, Sled.SLDPRT, armAssy.SLDASM, armBracket.SLDPRT, armGear.SLDPRT]
2015-06-12 axles and rollers and assembly and cshape
    [Assembly.SLDASM, CShape.SLDPRT, roller.SLDPRT, rollerAxle.SLDPRT]
2015-06-12 pid and menu
2015-06-12 clean up file storage and zipline zipper
    [ArmLongGear.SLDPRT, ArmLongSection.SLDPRT, ArmShortSection.SLDPRT, AxelMotorBracket.SLDPRT, ChassisPlate.SLDPRT, LBracket.SLDPRT, LiPoBattery.SLDPRT, PetBox.SLDPRT]
2015-06-12 IR Detector and Filter
    [IRDetector.sch]
2015-06-13 update zipline assy as per jons advice
    [ChassisPlate.SLDPRT, RobotAssy.SLDASM, ZiplineSupport.SLDPRT, armAssy.SLDASM, chassisAssy.SLDASM, wheel.SLDASM, ziplineArmGuide.SLDPRT, ziplineAssy.SLDASM]
2015-06-13 added some sensors
    [Assembly.SLDASM, CShape.SLDPRT, ChassisPlate.SLDPRT, LBracket.SLDPRT, Microswitch_1A_125vAC(seul).sldprt, QRD Chasis.SLDPRT, QRD1114.SLDASM, QRDeye.SLDASM]
2015-06-14 fixed bug where options didn't reflect
    [menu.cpp]
2015-06-14 Hbridge and IR Detector circuits modified version June 13
    [HBridge.sch]
2015-06-14 Initial commit of 2 QRD circuits
    [QRD.sch]
2015-06-14 Updated QRD and created winch circuit
    [Winch.sch]
2015-06-14 Updated H bridge
    [HBridge.sch]
2015-06-14 a whole bunch of stuff I dont remember including finishing the zipline stuff
    [ASM Meccano Gear 65mm.SLDASM, AxelMotorBracket.SLDPRT, ChassisPlate.SLDPRT, LBracket.SLDPRT, LiPoBattery.SLDPRT, Meccano Gear 13.5mm.SLDPRT, Meccano Gear 65mm.SLDPRT, Meccano Gear Axle.SLDPRT]
2015-06-14 modified QRD added potentialmeter value
    [QRD.sch]
2015-06-15 Swtich for detecting pet pick up
    [petswitch.sch]
2015-06-15 modified winch circuit
    [Winch.sch]
2015-06-16 Circuit schematics initial commit for report and proposal
2015-06-16 add schematics appendix and references in elec section
2015-06-16 Just a gear
    [Gear_Blank.SLDPRT]
2015-06-16 report add up to arm assy, mod some parts
    [QRD1114.SLDASM, QRDeye.SLDASM, RobotAssy.SLDASM, ZiplineSupport.SLDPRT, armAssy.SLDASM, boxPetSensePlate.SLDPRT, chassisAssy.SLDASM, wheel.SLDASM]
2015-06-17 Use this gear
    [better_gear.SLDPRT]
2015-06-17 Sensor system done
2015-06-17 Finish zipline section in report
    [QRD1114.SLDASM, QRDeye.SLDASM, RobotAssy.SLDASM, ZiplineSupport.SLDPRT, armAssy.SLDASM, chassisAssy.SLDASM, pickUpArmSensorPlate.SLDPRT, wheel.SLDASM]
2015-06-17 editing sensors section
2015-06-17 added torque calculations
2015-06-17 Voltage regulators added if necessary
    [HBridge.sch]
2015-06-17 fix arm issue and update report
    [ArmLongSection.SLDPRT, LBracket.SLDPRT, LBracketBack.SLDPRT, RobotAssy.SLDASM, armAssy.SLDASM, armBase.SLDPRT, armBracket.SLDPRT, chassisAssy.SLDASM]
2015-06-17 voltage regulators added
2015-06-18 Add drive gears
    [ArmLongSection.SLDPRT, AxelMotorBracket.SLDPRT, ChassisPlate.SLDPRT, RobotAssy.SLDASM, armAssy.SLDASM, axle.SLDPRT, chassisAssy.SLDASM, encoder gear.SLDPRT]
2015-06-18 update report with gears
2015-06-18 add IR circuit calculations
2015-06-18 add zipline sensor to report
2015-06-19 fixed io and start course
    [control.cpp, course.cpp, course.h, io.cpp, io.h, menu.cpp]
2015-06-19 add dxf files, uprev gears, add rivit holes
    [AxelMotorBracket.SLDPRT, ChassisPlate.SLDPRT, Flat pattern - AxelMotorBracket.DXF, Flat pattern - ChassisPlate.DXF, Flat pattern - SledV2.DXF, Flat pattern - boadBackPanel.DXF, Flat pattern - boardTray.DXF, Flat pattern - boardTrayTopTINAH.DXF]
2015-06-19 New roller drawn, no radius of curvature at all
    [ziplineRoller.SLDPRT]
2015-06-19 turn off adc free running
2015-06-19 update parts add renderings
    [Flat pattern - boardTrayTopTINAH.DXF, RobotAssy.SLDASM, armAssy.SLDASM, boardTrayTopTINAH.SLDPRT, chassisAssy.SLDASM, ziplineAssy.SLDASM]
2015-06-20 continuous adc polling
2015-06-20 switch to delay_ms
2015-06-24 added timer3 compa vect
2015-06-24 add beacon homing
2015-06-24 edits and DFXs
    [Flat pattern - SledV2.DXF, RobotAssy.SLDASM, SledV2.SLDPRT, chassisAssy.SLDASM, encoder gear V2.DXF, encoder gear V2.SLDPRT, motorDriveGear V2.DXF, motorDriveGear V2.SLDPRT]
2015-06-25 modified gear for new wheel
    [wheel gear V2.SLDPRT]
2015-06-27 new drive system and other shit
    [Base.SLDPRT, GearBoxAssy.SLDASM, GearRetainer.DXF, GearRetainer.SLDPRT, MotorGearSolidworksWoffset.SLDPRT, Part3.SLDPRT, RobotAssy.SLDASM, WheelGearSolidworksWoffset.SLDPRT]
2015-06-30 update drive system
    [Base.SLDPRT, EncoderGearSolidworksWoffset.SLDPRT, GearBoxAssy.SLDASM, MotorGearSolidworksWoffset.SLDPRT, RobotAssy.SLDASM, chassisAssy.SLDASM, wheel.SLDASM]
2015-07-01 more work on new drive system and progress on arm design
    [Base.SLDPRT, EncoderGearSolidworksWoffset.DXF, GearArmV2.SLDPRT, GearBoxAssy.SLDASM, LBracket.SLDPRT, LBracketBack.SLDPRT, MotorGearSolidworksWoffset.DXF, QRD1114.SLDASM]
2015-07-02 new pid and view menu
2015-07-02 fix pid direction of recovery
    [menu.cpp, menu.h, pid.cpp]
2015-07-02 fixed pid once and for all
    [menu.cpp, pid.cpp]
2015-07-06 clean DXF folder
    [ArmLongSection.SLDPRT, Base.SLDPRT, Flat pattern - ArmLongSection.DXF, Flat pattern - AxelMotorBracket.DXF, Flat pattern - ChassisPlate.DXF, Flat pattern - LBracket.DXF, Flat pattern - LBracketBack.DXF, Flat pattern - SledV2.DXF]
2015-07-07 arm motor encoder
2015-07-07 filleted the holes
    [Flat-frontarm_curved.DXF]
2015-07-08 front arm L bracket
    [FrontLBracket.DXF]
2015-07-08 mech updates
    [Flat pattern - ziplineWinchBracket.DXF, GearBoxAssy.SLDASM, MotorGearSolidworks.SLDPRT, MotorGearSolidworksFORWATERJET.DXF, QRD1114.SLDASM, QRDeye.SLDASM, RobotAssy.SLDASM, armAssy.SLDASM]
2015-07-09 zipline arm guide dxf
    [ziplineArmGuide.DXF]
2015-07-11 design refinenents on zipline arm
    [EncoderGearSolidworks.SLDPRT, RobotAssy.SLDASM, ZiplineSupport.SLDPRT, winchAssy.SLDASM, winchBody.SLDPRT, winchCover.SLDPRT, ziplineAssy.SLDASM]
2015-07-13 arm lifting stuff
2015-07-13 add brake state
2015-07-14 finalize zipline
    [ZiplineSupport.DXF, ZiplineSupport.SLDPRT, winchAssy.SLDASM, ziplineAssy.SLDASM]
2015-07-14 sync follow and pid
2015-07-15 fixed not entering recovery
    [course.cpp]
2015-07-15 add missing encoder update
    [course.cpp]
2015-07-15 fixed sign on theta values
    [course.cpp]
2015-07-16 course calibration
2015-07-16 new zipline delivery system
    [RobotAssy.SLDASM, ZiplineSupport.SLDPRT, armAssy.SLDASM, ziplineArmGuide.SLDPRT, ziplineArmGuideLShape.SLDPRT, ziplineAssy.SLDASM]
2015-07-17 fixed pet 3 not bedooj
    [course.cpp, course.h, io.cpp, io.h, menu.cpp]
2015-07-17 finish zipline design and DXFs
    [Flat pattern - ZiplineSupport.DXF, Flat pattern - ziplineArmGuideLShape.DXF, RobotAssy.SLDASM, ZiplineSupport.SLDPRT, ziplineArmGuideLShape.SLDPRT, ziplineAssy.SLDASM]
2015-07-22 homing stuff
2015-07-22 dead zone for reverse follow
    [course.cpp, menu.cpp, menu.h, pid.cpp, pid.h, strings.cpp, strings.h]
2015-07-22 mod to drive bracket
    [AxelMotorBracket.SLDPRT, Flat pattern - AxelMotorBracket_NoHoles.DXF, printedShaftFitting.SLDPRT]
2015-07-23 new arm
    [50toothGearWithOffset.DXF, 50toothGearWithOffset.SLDPRT, Flat pattern - armSupport.DXF, Flat pattern - boxArm.DXF, GearBoxAssy.SLDASM, MotorGearSolidworks.SLDPRT, QRD1114.SLDASM, QRDeye.SLDASM]
2015-07-24 switch from ppark to excavation
2015-07-24 update shaft fitting
    [printedShaftFitting.SLDPRT]
2015-07-29 arm retrieds if fails to pick up pet
    [course.cpp, io.cpp, io.h]
2015-07-29 tried to make stuff better and it works sometimes except for when it fails dangerously
    [boxArm.SLDASM, winchAssy.SLDASM, ziplineArmGuideLShape.SLDPRT, ziplineAssy.SLDASM, ziplineZipper.SLDASM]
2015-07-29 dead zone is encoder based
2015-07-29 beacon homing
2015-07-30 add excavator encoder
2015-07-31 reset mode and stuff
    [course.cpp, menu.cpp, menu.h, strings.cpp, strings.h]
2015-08-01 filter for IR fioajsdfj
2015-08-01 Circuit pictures for website added
    [IRDetector.sch, QRD.brd, QRD.sch]
2015-08-05 arm goes down less
